fedurca/het68_pcb/docs/PINOUT.csv

function | gpio | dir | net | notes
mesh_uart_tx | GP0 | out | UART_TX | J_MESH pin 3; Heltec GPIO5 RX; 22 ohm; MeshCore companion 115200
mesh_uart_rx | GP1 | in | UART_RX | J_MESH pin 4; Heltec GPIO6 TX; 22 ohm
env_sda | GP2 | i2c | I2C1_SDA | DPS310 0x77; SHT40 0x44
env_scl | GP3 | i2c | I2C1_SCL | pressure + temperature + humidity
pm_sda | GP4 | i2c | I2C0_SDA | via J_PWR to power board INA/PAC
pm_scl | GP5 | i2c | I2C0_SCL
piezo_a | GP6 | out | PIEZO_IN1 | DRV8837 IN1; 4x PS1240 parallel
piezo_b | GP7 | out | PIEZO_IN2 | DRV8837 IN2
i2s_ws | GP8 | out | I2S_WS | shared; 33 ohm then LVDS047 to six RJ45
i2s_sck | GP9 | out | I2S_SCK | 3.072 MHz; 33 ohm then LVDS047
led4_din | GP10 | out | LED4_DIN | RJ45 MIC4 pin 8
led5_din | GP11 | out | LED5_DIN | RJ45 MIC5 pin 8
led6_din | GP12 | out | LED6_DIN | RJ45 MIC6 pin 8
mic4_sd | GP13 | in | I2S_SD4 | LVDS RX; firmware PIN_I2S_SD[3]
mic5_sd | GP14 | in | I2S_SD5 | firmware PIN_I2S_SD[4]
mic6_sd | GP15 | in | I2S_SD6 | firmware PIN_I2S_SD[5]
mic3_sd | GP16 | in | I2S_SD3 | firmware PIN_I2S_SD[2]
mic2_sd | GP17 | in | I2S_SD2 | firmware PIN_I2S_SD[1]
mic1_sd | GP18 | in | I2S_SD1 | firmware PIN_I2S_SD[0]
led3_din | GP19 | out | LED3_DIN | RJ45 MIC3 pin 8
led2_din | GP20 | out | LED2_DIN | RJ45 MIC2 pin 8
led1_din | GP21 | out | LED1_DIN | RJ45 MIC1 pin 8
dsp_awake | GP22 | out | DSP_AWAKE | J_MESH pin 6; Heltec GPIO4
adxl_sck | GP23 | out | SPI0_SCK | ADXL355 1.8 V
adxl_mosi | GP24 | out | SPI0_MOSI | ADXL355
adxl_miso | GP25 | in | SPI0_MISO | ADXL355
adc_i | GP26 | analog | ADC_I | J_PWR pin 9; CT burden
adc_rogo | GP27 | analog | ADC_ROGO | J_PWR pin 10; VVN integrator; NC on NN/VN
adc_pt1000 | GP28 | analog | ADC_PT1000 | J_PWR pin 12
adc_harvest | GP29 | analog | ADC_HARVEST | J_PWR pin 11
adxl_cs | GP30 | out | SPI0_CS | ADXL355
burden_en | GP31 | out | BURDEN_EN | J_PWR pin 13; NN/VN multiplex; NC on VVN
psram_ce | GP32 | out | PSRAM_CE | APS6404L
psram_so | GP33 | in | PSRAM_SO | APS6404L
psram_si | GP34 | out | PSRAM_SI | APS6404L
psram_sclk | GP35 | out | PSRAM_SCLK | APS6404L
pg_5v | GP36 | in | PG_5V | J_PWR pin 14
status_led | GP37 | out | STATUS_DIN | one SK6812 on Core; +3V3_DIG; DOUT NC
user_btn | GP38 | in | BTN_USER | active low; 10k to +3V3_DIG; SW_USR to GND
reset_btn |  |  | RUN | SW_RST to GND; 10k R_RUN already on RUN
boot_btn |  |  | QSPI_SS | SW_BOOT to GND; 10k R_CS; hold with reset for USB bootloader
wake_dsp |  | in | WAKE_DSP | not an MCU GPIO; Heltec GPIO7 -> EN of +3V3_DIG and +1V8_AUDIO LDOs
qspi_flash |  | bus | QSPI | dedicated RP2350B QSPI pins to W25Q128
usb_cdc |  |  | USB | console; replaces v3 debug UART on GP0/GP1
