fedurca/het68_pcb/docs/img/core-3d.png

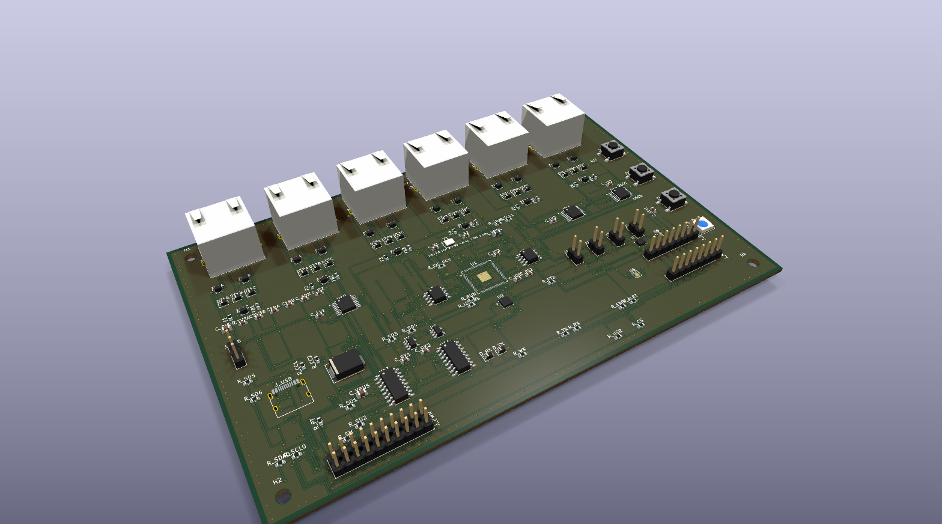
docs/img/core-3d.png
