fedurca/het68_pcb/docs/img/sat-3d.png

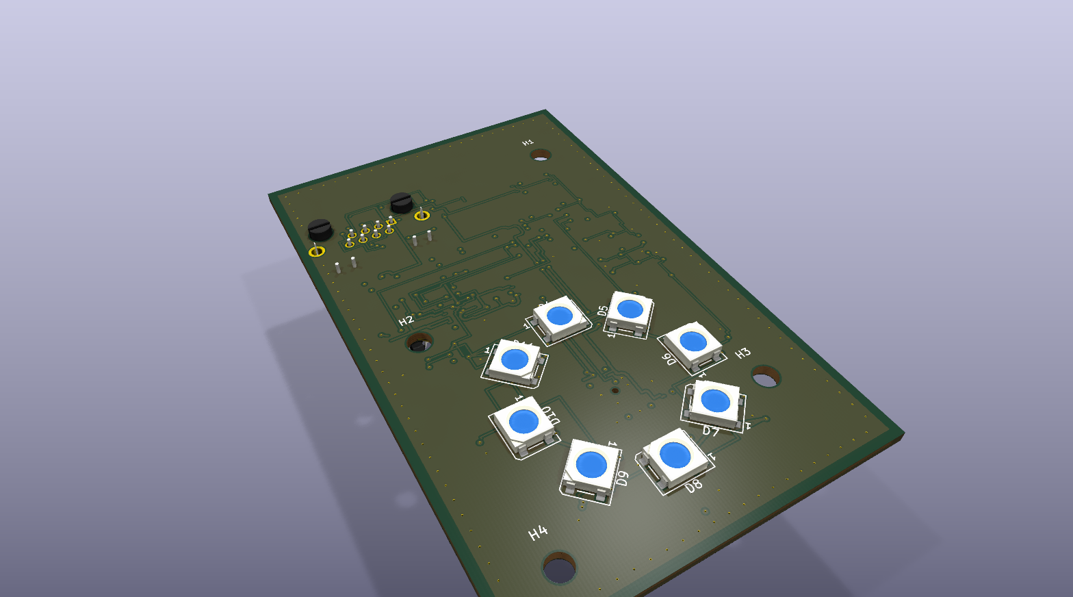
docs/img/sat-3d.png
