fedurca/het68_pcb/docs/img/sat-back-3d.png

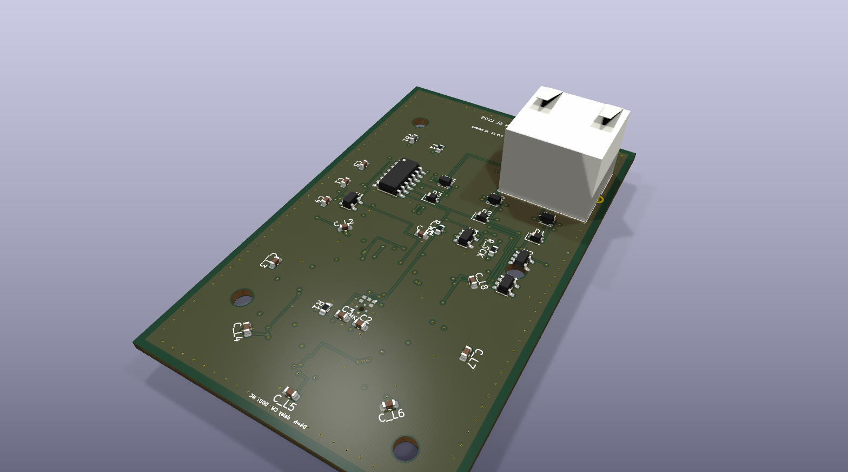
docs/img/sat-back-3d.png
