fedurca/het68_pcb/kicad/BOM_KIT.csv

Qty | Value | MPN | On
4 | 0 | RC0603FR-070RL | core+pwr-nn
1 | 0.1 | RC0805FR-070R1L | pwr-nn
6 | 0.25A | PPTC 0603 | core
6 | 0.5A | PPTC 0603 | sat x6
1 | 0.5A | polyfuse 1812 0.5 A | pwr-nn
1 | 10 | 10R 0.1pct burden | pwr-nn
18 | 100 | RC0603FR-07100RL | core+sat x6
1 | 100 | 100R THT burden | pwr-nn
11 | 100k | RC0603FR-07100KL | core+pwr-nn+sat x6
80 | 100n | CL10B104KB8NNNC | core+pwr-nn+sat x6
12 | 10k | RC0603FR-0710KL | core+pwr-nn
4 | 10u | CL21A106KOQNNNE | core+pwr-nn
1 | 10uH | 10uH boost | pwr-nn
1 | 12MHz | 12MHz 3225 | core
2 | 15p | CL10C150JB8NNNC | core
1 | 1k | RC0603FR-071KL | core
1 | 1k | RC0805FR-071KL | pwr-nn
16 | 1u | CL10A105KA8NNNC | core+pwr-nn+sat x6
1 | 1u/100V | 1uF 100V X7R LC | pwr-nn
1 | 2.2k | RC0603FR-072K2L | pwr-nn
1 | 2.2u | CL21A225KOQNNNE | core
1 | 2.2uH | 2.2uH VREG | core
1 | 20k | RC0603FR-0720KL | pwr-nn
1 | 21700 | Keystone 1122 | pwr-nn
2 | 22 | RC0603FR-0722RL | core
2 | 33 | RC0603FR-0733RL | core
6 | 4.7k | RC0603FR-074K7L | core+pwr-nn
1 | 470u/50V | electrolytic 470u 50V | pwr-nn
1 | 470uH | 470uH radial | pwr-nn
4 | 5.1k | RC0603FR-075K1L | core+pwr-nn
1 | 5KP36A | 5KP36A | pwr-nn
12 | 600R | BLM18PG601SN1D | core+sat x6
1 | ADXL355 | ADXL355BCCZ | core
2 | AO3400A | AO3400A | pwr-nn
1 | AO3401A | AO3401A | pwr-nn
7 | AP2112K-1.8 | AP2112K-1.8TRG1 | core+sat x6
2 | AP2112K-3.3 | AP2112K-3.3TRG1 | core+pwr-nn
1 | APS6404L | APS6404L-3SQR-SN | core
1 | BOOT | PTS645SM43SMTR92 | core
1 | BZX84-C24 | BZX84-C24 | pwr-nn
36 | CMC | ACM2012 | core+sat x6
1 | CN3791 | CN3791 | pwr-nn
1 | CT_SEC | sekundar CT, NE sit | pwr-nn
1 | DPS310 | DPS310 | core
1 | DRV8837C | DRV8837CDSGR | core
1 | FP6291 | FP6291 | pwr-nn
1 | GDT | GDT secondary | pwr-nn
1 | INA3221 | INA3221AIRGVR | pwr-nn
1 | J_CORE | interconnect 2x10 | pwr-nn
1 | J_MESH | PinHeader 1x8 Heltec V3 | core
1 | J_PWR | interconnect 2x10 | core
1 | J_STAMP_DNP | DNP stamp RAK class | core
1 | LED | LED 0603 | pwr-nn
1 | MIC1 | RJ45-8P8C-VERT | core
1 | MIC2 | RJ45-8P8C-VERT | core
1 | MIC3 | RJ45-8P8C-VERT | core
1 | MIC4 | RJ45-8P8C-VERT | core
1 | MIC5 | RJ45-8P8C-VERT | core
1 | MIC6 | RJ45-8P8C-VERT | core
38 | PESD5V0X1BT | PESD5V0X1BT | core+sat x6
1 | PT1000 | PT1000 on conductor | pwr-nn
1 | PZ1 | PS1240 | core
1 | PZ2 | PS1240 | core
1 | PZ3 | PS1240 | core
1 | PZ4 | PS1240 | core
1 | RESET | PTS645SM43SMTR92 | core
6 | RJ45 | RJ45-8P8C-VERT | sat x6
1 | RP2350B | RP2350B | core
1 | SHT40 | SHT40-AD1B-R2 | core
49 | SK6812 | SK6812 (5050, 3.3 V) | core+sat x6
3 | SN65LVDS047 | SN65LVDS047PW | core
6 | SN65LVDS1 | SN65LVDS1DBVR | sat x6
12 | SN65LVDS2 | SN65LVDS2DBVR | sat x6
2 | SN65LVDS32 | SN65LVDS32D | core
1 | SOLAR | panel Voc 6-18 V | pwr-nn
4 | SS14 | SS14 | pwr-nn
4 | SS34 | SS34 | core+pwr-nn
1 | SWD | SWD | core
6 | T5848 | MMICT5848-00-012 | sat x6
6 | TXS0104E | TXS0104EDR | sat x6
2 | USB_C | TYPE-C-31-M-12 | core+pwr-nn
1 | USER | PTS645SM43SMTR92 | core
1 | VOUT | 5V lab | pwr-nn
1 | W25Q128JVSIQ | W25Q128JVSIQ | core
1 | X0202MN | X0202MN | pwr-nn
