fedurca/het68_pcb/kicad/BOM_v4.csv

Board | Qty | Value | MPN | Refs
core | 1 | RP2350B | RP2350B | U1
core | 1 | W25Q128JVSIQ | W25Q128JVSIQ | U2
core | 1 | APS6404L | APS6404L-3SQR-SN | U3
core | 1 | 12MHz | 12MHz 3225 | Y1
core | 2 | 15p | CL10C150JB8NNNC | C_X1 C_X2
core | 1 | 2.2uH | 2.2uH VREG | L_VREG
core | 1 | 2.2u | CL21A225KOQNNNE | C_DVDD
core | 1 | AP2112K-3.3 | AP2112K-3.3TRG1 | U4
core | 1 | AP2112K-1.8 | AP2112K-1.8TRG1 | U5
core | 3 | 1u | CL10A105KA8NNNC | C3V3A C18A C_IO3
core | 12 | 100n | CL10B104KB8NNNC | C3V3B C18B C_STAT C_ADX C_PZ C_LV1 C_LV2 C_LV3 C_RX1 C_RX2 C_IO1 C_IO2
core | 5 | 10k | RC0603FR-0710KL | R_RUN R_CS R_USR R_ENRF R_ALRT
core | 1 | 100k | RC0603FR-07100KL | R_WK
core | 1 | RESET | PTS645SM43SMTR92 | SW_RST
core | 1 | BOOT | PTS645SM43SMTR92 | SW_BOOT
core | 1 | USER | PTS645SM43SMTR92 | SW_USR
core | 1 | SK6812 | SK6812 (5050, 3.3 V) | D_STAT
core | 1 | USB_C | TYPE-C-31-M-12 | J_USB
core | 2 | 5.1k | RC0603FR-075K1L | R_CC1 R_CC2
core | 1 | SS34 | SS34 | D_USB
core | 1 | 10u | CL21A106KOQNNNE | C_VBUS
core | 1 | J_MESH | PinHeader 1x8 Heltec V3 | J_MESH
core | 1 | J_STAMP_DNP | DNP stamp RAK class | J_STAMP
core | 2 | 22 | RC0603FR-0722RL | R_TX R_RX
core | 2 | 33 | RC0603FR-0733RL | R_I2S_SCK R_I2S_WS
core | 20 | PESD5V0X1BT | PESD5V0X1BT | D_TX D_RX DT1A DT1B DT1C DT2A DT2B DT2C DT3A DT3B DT3C DT4A DT4B DT4C DT5A DT5B DT5C DT6A DT6B DT6C
core | 1 | SWD | SWD | J_SWD
core | 1 | J_PWR | interconnect 2x10 | J_PWR
core | 4 | 4.7k | RC0603FR-074K7L | R_SDA0 R_SCL0 R_SDA1 R_SCL1
core | 1 | 1k | RC0603FR-071KL | R_PT
core | 2 | 0 | RC0603FR-070RL | R_PT2 R_SH
core | 1 | DPS310 | DPS310 | U7
core | 1 | SHT40 | SHT40-AD1B-R2 | U8
core | 1 | ADXL355 | ADXL355BCCZ | U9
core | 1 | DRV8837C | DRV8837CDSGR | U6
core | 1 | PZ1 | PS1240 | J11
core | 1 | PZ2 | PS1240 | J12
core | 1 | PZ3 | PS1240 | J13
core | 1 | PZ4 | PS1240 | J14
core | 3 | SN65LVDS047 | SN65LVDS047PW | U10 U11 U12
core | 2 | SN65LVDS32 | SN65LVDS32D | U13 U14
core | 1 | MIC1 | RJ45-8P8C-VERT | J1
core | 18 | CMC | ACM2012 | FL1A FL1B FL1C FL2A FL2B FL2C FL3A FL3B FL3C FL4A FL4B FL4C FL5A FL5B FL5C FL6A FL6B FL6C
core | 6 | 100 | RC0603FR-07100RL | R_SD1 R_SD2 R_SD3 R_SD4 R_SD5 R_SD6
core | 6 | 0.25A | PPTC 0603 | F1 F2 F3 F4 F5 F6
core | 6 | 600R | BLM18PG601SN1D | FB1 FB2 FB3 FB4 FB5 FB6
core | 1 | MIC2 | RJ45-8P8C-VERT | J2
core | 1 | MIC3 | RJ45-8P8C-VERT | J3
core | 1 | MIC4 | RJ45-8P8C-VERT | J4
core | 1 | MIC5 | RJ45-8P8C-VERT | J5
core | 1 | MIC6 | RJ45-8P8C-VERT | J6
sat | 6 | RJ45 | RJ45-8P8C-VERT | J1
sat | 18 | CMC | ACM2012 | FL1 FL2 FL3
sat | 18 | PESD5V0X1BT | PESD5V0X1BT | D1 D2 D3
sat | 6 | 0.5A | PPTC 0603 | F1
sat | 6 | 600R | BLM18PG601SN1D | FB1
sat | 12 | 100 | RC0603FR-07100RL | R_SCK R_WS
sat | 12 | SN65LVDS2 | SN65LVDS2DBVR | U2 U3
sat | 6 | SN65LVDS1 | SN65LVDS1DBVR | U4
sat | 6 | TXS0104E | TXS0104EDR | U5
sat | 6 | AP2112K-1.8 | AP2112K-1.8TRG1 | U1
sat | 6 | T5848 | MMICT5848-00-012 | MK1
sat | 48 | SK6812 | SK6812 (5050, 3.3 V) | D4 D5 D6 D7 D8 D9 D10 D11
sat | 66 | 100n | CL10B104KB8NNNC | C_L1 C_L2 C_L3 C_L4 C_L5 C_L6 C_L7 C_L8 C3 C4 C5
sat | 12 | 1u | CL10A105KA8NNNC | C1 C2
sat | 6 | 100k | RC0603FR-07100KL | R1
het68-pwr-nn | 1 | CT_SEC | sekundar CT, NE sit | J1
het68-pwr-nn | 1 | 100 | 100R THT burden | R4
het68-pwr-nn | 1 | GDT | GDT secondary | GDT1
het68-pwr-nn | 1 | 470uH | 470uH radial | L1
het68-pwr-nn | 1 | 1u/100V | 1uF 100V X7R LC | C4
het68-pwr-nn | 1 | 0.5A | polyfuse 1812 0.5 A | F1
het68-pwr-nn | 4 | SS14 | SS14 | D1 D2 D3 D4
het68-pwr-nn | 1 | 470u/50V | electrolytic 470u 50V | C1
het68-pwr-nn | 1 | X0202MN | X0202MN | Q1
het68-pwr-nn | 1 | BZX84-C24 | BZX84-C24 | D5
het68-pwr-nn | 1 | 1k | RC0805FR-071KL | R5
het68-pwr-nn | 1 | 5KP36A | 5KP36A | DTVS
het68-pwr-nn | 3 | SS34 | SS34 | D6 D7 D_HV
het68-pwr-nn | 1 | 10 | 10R 0.1pct burden | RPREC
het68-pwr-nn | 2 | AO3400A | AO3400A | Q2 Q4
het68-pwr-nn | 4 | 100k | RC0603FR-07100KL | R_BG R_PGATE R_ROGO_NC R_FB1
het68-pwr-nn | 1 | AO3401A | AO3401A | Q3
het68-pwr-nn | 7 | 10k | RC0603FR-0710KL | R_IS R_IG R_PG R_PG2 R_RFEN R_HS R_HG
het68-pwr-nn | 1 | USB_C | TYPE-C-31-M-12 | J2
het68-pwr-nn | 2 | 5.1k | RC0603FR-075K1L | R1 R2
het68-pwr-nn | 3 | 10u | CL21A106KOQNNNE | C3 C_MP C_5V
het68-pwr-nn | 1 | SOLAR | panel Voc 6-18 V | J_SOL
het68-pwr-nn | 1 | CN3791 | CN3791 | U_MPPT
het68-pwr-nn | 2 | 100n | CL10B104KB8NNNC | C_MC C_INA
het68-pwr-nn | 1 | 21700 | Keystone 1122 | BT1
het68-pwr-nn | 1 | FP6291 | FP6291 | U_BST
het68-pwr-nn | 1 | 10uH | 10uH boost | L_BST
het68-pwr-nn | 1 | 20k | RC0603FR-0720KL | R_FB2
het68-pwr-nn | 1 | AP2112K-3.3 | AP2112K-3.3TRG1 | U_RF
het68-pwr-nn | 1 | 1u | CL10A105KA8NNNC | C_RF
het68-pwr-nn | 1 | INA3221 | INA3221AIRGVR | U_INA
het68-pwr-nn | 1 | 0.1 | RC0805FR-070R1L | R_SH5
het68-pwr-nn | 1 | PT1000 | PT1000 on conductor | J_RTD
het68-pwr-nn | 2 | 0 | RC0603FR-070RL | R_RTN R_SH
het68-pwr-nn | 1 | J_CORE | interconnect 2x10 | J_CORE
het68-pwr-nn | 2 | 4.7k | RC0603FR-074K7L | R_SDA R_SCL
het68-pwr-nn | 1 | LED | LED 0603 | D8
het68-pwr-nn | 1 | 2.2k | RC0603FR-072K2L | R3
het68-pwr-nn | 1 | VOUT | 5V lab | J3
het68-pwr-vn | 1 | CT_SEC | sekundar CT, NE sit | J1
het68-pwr-vn | 1 | 100 | 100R THT burden | R4
het68-pwr-vn | 1 | GDT | GDT secondary | GDT1
het68-pwr-vn | 1 | GDT | GDT secondary extra | GDT2
het68-pwr-vn | 1 | 470uH | 470uH radial | L1
het68-pwr-vn | 1 | 1u/100V | 1uF 100V X7R LC | C4
het68-pwr-vn | 1 | 0.5A | polyfuse 1812 0.5 A | F1
het68-pwr-vn | 4 | SS14 | SS14 | D1 D2 D3 D4
het68-pwr-vn | 1 | 470u/50V | electrolytic 470u 50V | C1
het68-pwr-vn | 1 | X0202MN | X0202MN | Q1
het68-pwr-vn | 1 | BZX84-C24 | BZX84-C24 | D5
het68-pwr-vn | 1 | 1k | RC0805FR-071KL | R5
het68-pwr-vn | 1 | 15KP36A | 15KP36A | DTVS
het68-pwr-vn | 3 | SS34 | SS34 | D6 D7 D_HV
het68-pwr-vn | 1 | 10 | 10R 0.1pct burden | RPREC
het68-pwr-vn | 2 | AO3400A | AO3400A | Q2 Q4
het68-pwr-vn | 4 | 100k | RC0603FR-07100KL | R_BG R_PGATE R_ROGO_NC R_FB1
het68-pwr-vn | 1 | AO3401A | AO3401A | Q3
het68-pwr-vn | 7 | 10k | RC0603FR-0710KL | R_IS R_IG R_PG R_PG2 R_RFEN R_HS R_HG
het68-pwr-vn | 1 | USB_C | TYPE-C-31-M-12 | J2
het68-pwr-vn | 2 | 5.1k | RC0603FR-075K1L | R1 R2
het68-pwr-vn | 3 | 10u | CL21A106KOQNNNE | C3 C_MP C_5V
het68-pwr-vn | 1 | SOLAR | panel Voc 6-18 V | J_SOL
het68-pwr-vn | 1 | CN3791 | CN3791 | U_MPPT
het68-pwr-vn | 2 | 100n | CL10B104KB8NNNC | C_MC C_INA
het68-pwr-vn | 1 | 21700 | Keystone 1122 | BT1
het68-pwr-vn | 1 | FP6291 | FP6291 | U_BST
het68-pwr-vn | 1 | 10uH | 10uH boost | L_BST
het68-pwr-vn | 1 | 20k | RC0603FR-0720KL | R_FB2
het68-pwr-vn | 1 | AP2112K-3.3 | AP2112K-3.3TRG1 | U_RF
het68-pwr-vn | 1 | 1u | CL10A105KA8NNNC | C_RF
het68-pwr-vn | 1 | INA3221 | INA3221AIRGVR | U_INA
het68-pwr-vn | 1 | 0.1 | RC0805FR-070R1L | R_SH5
het68-pwr-vn | 1 | PT1000 | PT1000 on conductor | J_RTD
het68-pwr-vn | 2 | 0 | RC0603FR-070RL | R_RTN R_SH
het68-pwr-vn | 1 | J_CORE | interconnect 2x10 | J_CORE
het68-pwr-vn | 2 | 4.7k | RC0603FR-074K7L | R_SDA R_SCL
het68-pwr-vn | 1 | LED | LED 0603 | D8
het68-pwr-vn | 1 | 2.2k | RC0603FR-072K2L | R3
het68-pwr-vn | 1 | VOUT | 5V lab | J3
het68-pwr-vvn | 1 | CT_SEC | sekundar CT, NE sit | J1
het68-pwr-vvn | 1 | 100 | 100R THT burden | R4
het68-pwr-vvn | 1 | GDT | GDT secondary | GDT1
het68-pwr-vvn | 1 | 470uH | 470uH radial | L1
het68-pwr-vvn | 1 | 1u/100V | 1uF 100V X7R LC | C4
het68-pwr-vvn | 1 | 0.5A | polyfuse 1812 0.5 A | F1
het68-pwr-vvn | 4 | SS14 | SS14 | D1 D2 D3 D4
het68-pwr-vvn | 1 | 470u/50V | electrolytic 470u 50V | C1
het68-pwr-vvn | 1 | X0202MN | X0202MN | Q1
het68-pwr-vvn | 1 | BZX84-C24 | BZX84-C24 | D5
het68-pwr-vvn | 1 | 1k | RC0805FR-071KL | R5
het68-pwr-vvn | 1 | 15KP36A | 15KP36A | DTVS
het68-pwr-vvn | 3 | SS34 | SS34 | D6 D7 D_HV
het68-pwr-vvn | 1 | ROGOWSKI | Rogowski secondary, NE sit | J_ROGO
het68-pwr-vvn | 3 | 0 | RC0603FR-070RL | R_RN R_RTN R_SH
het68-pwr-vvn | 8 | 10k | RC0603FR-0710KL | R_INT R_IS R_IG R_PG R_PG2 R_RFEN R_HS R_HG
het68-pwr-vvn | 4 | 100n | CL10B104KB8NNNC | C_INT C_OA C_MC C_INA
het68-pwr-vvn | 1 | MCP6001 | MCP6001T-OT | U_INT
het68-pwr-vvn | 2 | 100k | RC0603FR-07100KL | R_BEN_NC R_FB1
het68-pwr-vvn | 1 | USB_C | TYPE-C-31-M-12 | J2
het68-pwr-vvn | 2 | 5.1k | RC0603FR-075K1L | R1 R2
het68-pwr-vvn | 3 | 10u | CL21A106KOQNNNE | C3 C_MP C_5V
het68-pwr-vvn | 1 | SOLAR | panel Voc 6-18 V | J_SOL
het68-pwr-vvn | 1 | CN3791 | CN3791 | U_MPPT
het68-pwr-vvn | 1 | 21700 | Keystone 1122 | BT1
het68-pwr-vvn | 1 | FP6291 | FP6291 | U_BST
het68-pwr-vvn | 1 | 10uH | 10uH boost | L_BST
het68-pwr-vvn | 1 | 20k | RC0603FR-0720KL | R_FB2
het68-pwr-vvn | 1 | AP2112K-3.3 | AP2112K-3.3TRG1 | U_RF
het68-pwr-vvn | 1 | 1u | CL10A105KA8NNNC | C_RF
het68-pwr-vvn | 1 | INA3221 | INA3221AIRGVR | U_INA
het68-pwr-vvn | 1 | 0.1 | RC0805FR-070R1L | R_SH5
het68-pwr-vvn | 1 | PT1000 | PT1000 on conductor | J_RTD
het68-pwr-vvn | 1 | J_CORE | interconnect 2x10 | J_CORE
het68-pwr-vvn | 2 | 4.7k | RC0603FR-074K7L | R_SDA R_SCL
het68-pwr-vvn | 1 | LED | LED 0603 | D8
het68-pwr-vvn | 1 | 2.2k | RC0603FR-072K2L | R3
het68-pwr-vvn | 1 | VOUT | 5V lab | J3
