fedurca/het68_pcb/kicad/het68-sat/bom.csv

Ref | Value | Footprint | MPN | LCSC
J1 | RJ45 | het68:RJ45_Vertical_het68 | RJ45-8P8C-VERT
FL1 | CMC | Inductor_SMD:L_CommonModeChoke_Coilank_ACM2012 | ACM2012
FL2 | CMC | Inductor_SMD:L_CommonModeChoke_Coilank_ACM2012 | ACM2012
D1 | PESD5V0X1BT | Diode_SMD:D_SOD-323 | PESD5V0X1BT
D2 | PESD5V0X1BT | Diode_SMD:D_SOD-323 | PESD5V0X1BT
D3 | PESD5V0X1BT | Diode_SMD:D_SOD-323 | PESD5V0X1BT
F1 | 0.5A | Fuse:Fuse_0603_1608Metric | PPTC 0603
FB1 | 600R | Inductor_SMD:L_0603_1608Metric | BLM18PG601SN1D
R_SCK | 100 | Resistor_SMD:R_0603_1608Metric | RC0603FR-07100RL
R_WS | 100 | Resistor_SMD:R_0603_1608Metric | RC0603FR-07100RL
JP_TSCK | T | Connector_PinHeader_2.54mm:PinHeader_1x02_P2.54mm_Vertical | jumper DIFF term SCK
JP_TWS | T | Connector_PinHeader_2.54mm:PinHeader_1x02_P2.54mm_Vertical | jumper DIFF term WS
U2 | SN65LVDS2 | Package_TO_SOT_SMD:SOT-23-5 | SN65LVDS2DBVR
U3 | SN65LVDS2 | Package_TO_SOT_SMD:SOT-23-5 | SN65LVDS2DBVR
U4 | SN65LVDS1 | Package_TO_SOT_SMD:SOT-23-5 | SN65LVDS1DBVR
JP_SCK | MODE | Connector_PinHeader_2.54mm:PinHeader_2x03_P2.54mm_Vertical | SCK radky DIFF / 3V3 / 1V8
JP_WS | MODE | Connector_PinHeader_2.54mm:PinHeader_2x03_P2.54mm_Vertical | WS radky DIFF / 3V3 / 1V8
JP_SD | MODE | Connector_PinHeader_2.54mm:PinHeader_2x03_P2.54mm_Vertical | SD radky DIFF / 3V3 / 1V8
JP_SDN | SDN | Connector_PinHeader_2.54mm:PinHeader_1x03_P2.54mm_Vertical | jumper SDN 1-2 DIFF 2-3 single-ended
R_OE | 10k | Resistor_SMD:R_0603_1608Metric | RC0603FR-0710KL
JP_OE | OE | Connector_PinHeader_2.54mm:PinHeader_1x02_P2.54mm_Vertical | jumper OE to GND = 1V8 mode
R_SD3 | 100k | Resistor_SMD:R_0603_1608Metric | RC0603FR-07100KL
U5 | TXS0104E | Package_SO:SOIC-14_3.9x8.7mm_P1.27mm | TXS0104EDR
U1 | AP2112K-1.8 | Package_TO_SOT_SMD:SOT-23-5 | AP2112K-1.8TRG1 | C176944
MK1 | T5848 | het68:T5848 | MMICT5848-00-012 | C20344623
D4 | SK6812 | LED_SMD:LED_WS2812B_PLCC4_5.0x5.0mm_P3.2mm | SK6812 (5050, 3.3 V)
C_L1 | 100n | Capacitor_SMD:C_0603_1608Metric | CL10B104KB8NNNC
D5 | SK6812 | LED_SMD:LED_WS2812B_PLCC4_5.0x5.0mm_P3.2mm | SK6812 (5050, 3.3 V)
C_L2 | 100n | Capacitor_SMD:C_0603_1608Metric | CL10B104KB8NNNC
D6 | SK6812 | LED_SMD:LED_WS2812B_PLCC4_5.0x5.0mm_P3.2mm | SK6812 (5050, 3.3 V)
C_L3 | 100n | Capacitor_SMD:C_0603_1608Metric | CL10B104KB8NNNC
D7 | SK6812 | LED_SMD:LED_WS2812B_PLCC4_5.0x5.0mm_P3.2mm | SK6812 (5050, 3.3 V)
C_L4 | 100n | Capacitor_SMD:C_0603_1608Metric | CL10B104KB8NNNC
D8 | SK6812 | LED_SMD:LED_WS2812B_PLCC4_5.0x5.0mm_P3.2mm | SK6812 (5050, 3.3 V)
C_L5 | 100n | Capacitor_SMD:C_0603_1608Metric | CL10B104KB8NNNC
D9 | SK6812 | LED_SMD:LED_WS2812B_PLCC4_5.0x5.0mm_P3.2mm | SK6812 (5050, 3.3 V)
C_L6 | 100n | Capacitor_SMD:C_0603_1608Metric | CL10B104KB8NNNC
D10 | SK6812 | LED_SMD:LED_WS2812B_PLCC4_5.0x5.0mm_P3.2mm | SK6812 (5050, 3.3 V)
C_L7 | 100n | Capacitor_SMD:C_0603_1608Metric | CL10B104KB8NNNC
D11 | SK6812 | LED_SMD:LED_WS2812B_PLCC4_5.0x5.0mm_P3.2mm | SK6812 (5050, 3.3 V)
C_L8 | 100n | Capacitor_SMD:C_0603_1608Metric | CL10B104KB8NNNC
C1 | 1u | Capacitor_SMD:C_0603_1608Metric | CL10A105KA8NNNC
C2 | 1u | Capacitor_SMD:C_0603_1608Metric | CL10A105KA8NNNC
C3 | 100n | Capacitor_SMD:C_0603_1608Metric | CL10B104KB8NNNC
C4 | 100n | Capacitor_SMD:C_0603_1608Metric | CL10B104KB8NNNC
C5 | 100n | Capacitor_SMD:C_0603_1608Metric | CL10B104KB8NNNC
R1 | 100k | Resistor_SMD:R_0603_1608Metric | RC0603FR-07100KL
FL3 | CMC | Inductor_SMD:L_CommonModeChoke_Coilank_ACM2012 | ACM2012
