fedurca/het68_pcb/kicad/jlc/het68-core-bom.csv

Comment | Designator | Footprint | MPN | LCSC
RP2350B | U1 | Package_DFN_QFN:QFN-80-1EP_10x10mm_P0.4mm_EP3.4x3.4mm_ThermalVias | RP2350B
W25Q128JVSIQ | U2 | Package_SO:SOIC-8_3.9x4.9mm_P1.27mm | W25Q128JVSIQ
APS6404L | U3 | Package_SO:SOIC-8_3.9x4.9mm_P1.27mm | APS6404L-3SQR-SN
12MHz | Y1 | Crystal:Crystal_SMD_3225-4Pin_3.2x2.5mm | 12MHz 3225
15p | C_X1,C_X2 | Capacitor_SMD:C_0603_1608Metric | CL10C150JB8NNNC
2.2uH | L_VREG | Inductor_SMD:L_0805_2012Metric | 2.2uH VREG
2.2u | C_DVDD | Capacitor_SMD:C_0805_2012Metric | CL21A225KOQNNNE
AP2112K-3.3 | U4 | Package_TO_SOT_SMD:SOT-23-5 | AP2112K-3.3TRG1
AP2112K-1.8 | U5 | Package_TO_SOT_SMD:SOT-23-5 | AP2112K-1.8TRG1 | C176944
1u | C3V3A,C18A,C_IO3 | Capacitor_SMD:C_0603_1608Metric | CL10A105KA8NNNC
100n | C3V3B,C18B,C_STAT,C_ADX,C_PZ,C_LV1,C_LV2,C_LV3,C_RX1,C_RX2,C_IO1,C_IO2 | Capacitor_SMD:C_0603_1608Metric | CL10B104KB8NNNC
10k | R_RUN,R_CS,R_USR,R_ENRF,R_ALRT | Resistor_SMD:R_0603_1608Metric | RC0603FR-0710KL
100k | R_WK | Resistor_SMD:R_0603_1608Metric | RC0603FR-07100KL
RESET | SW_RST | Button_Switch_SMD:SW_SPST_PTS645Sx43SMTR92 | PTS645SM43SMTR92
BOOT | SW_BOOT | Button_Switch_SMD:SW_SPST_PTS645Sx43SMTR92 | PTS645SM43SMTR92
USER | SW_USR | Button_Switch_SMD:SW_SPST_PTS645Sx43SMTR92 | PTS645SM43SMTR92
SK6812 | D_STAT | LED_SMD:LED_WS2812B_PLCC4_5.0x5.0mm_P3.2mm | SK6812 (5050, 3.3 V)
USB_C | J_USB | Connector_USB:USB_C_Receptacle_HRO_TYPE-C-31-M-12 | TYPE-C-31-M-12 | C165948
5.1k | R_CC1,R_CC2 | Resistor_SMD:R_0603_1608Metric | RC0603FR-075K1L
SS34 | D_USB | Diode_SMD:D_SMC | SS34
10u | C_VBUS | Capacitor_SMD:C_0805_2012Metric | CL21A106KOQNNNE
J_MESH | J_MESH | Connector_PinHeader_2.54mm:PinHeader_1x08_P2.54mm_Vertical | PinHeader 1x8 Heltec V3
J_STAMP_DNP | J_STAMP | Connector_PinHeader_2.54mm:PinHeader_1x08_P2.54mm_Vertical | DNP stamp RAK class
22 | R_TX,R_RX | Resistor_SMD:R_0603_1608Metric | RC0603FR-0722RL
33 | R_I2S_SCK,R_I2S_WS | Resistor_SMD:R_0603_1608Metric | RC0603FR-0733RL
PESD5V0X1BT | D_TX,D_RX,DT1A,DT1B,DT1C,DT2A,DT2B,DT2C,DT3A,DT3B,DT3C,DT4A,DT4B,DT4C,DT5A,DT5B,DT5C,DT6A,DT6B,DT6C | Diode_SMD:D_SOD-323 | PESD5V0X1BT
SWD | J_SWD | Connector_PinHeader_2.54mm:PinHeader_1x03_P2.54mm_Vertical | SWD
J_PWR | J_PWR | Connector_PinHeader_2.54mm:PinHeader_2x10_P2.54mm_Vertical | interconnect 2x10
4.7k | R_SDA0,R_SCL0,R_SDA1,R_SCL1 | Resistor_SMD:R_0603_1608Metric | RC0603FR-074K7L
1k | R_PT | Resistor_SMD:R_0603_1608Metric | RC0603FR-071KL
0 | R_PT2,R_SH | Resistor_SMD:R_0603_1608Metric | RC0603FR-070RL
DPS310 | U7 | Package_LGA:Bosch_LGA-8_2x2.5mm_P0.65mm_ClockwisePinNumbering | DPS310 | C130156
SHT40 | U8 | Sensor_Humidity:Sensirion_DFN-4_1.5x1.5mm_P0.8mm_SHT4x_NoCentralPad | SHT40-AD1B-R2 | C2909890
ADXL355 | U9 | Package_DFN_QFN:QFN-16-1EP_3x3mm_P0.5mm_EP1.7x1.7mm | ADXL355BCCZ
DRV8837C | U6 | Package_SON:Texas_DSG0008A_WSON-8-1EP_2x2mm_P0.5mm_EP0.9x1.6mm | DRV8837CDSGR | C191000
PZ1 | J11 | Connector_PinHeader_2.54mm:PinHeader_1x02_P2.54mm_Vertical | PS1240
PZ2 | J12 | Connector_PinHeader_2.54mm:PinHeader_1x02_P2.54mm_Vertical | PS1240
PZ3 | J13 | Connector_PinHeader_2.54mm:PinHeader_1x02_P2.54mm_Vertical | PS1240
PZ4 | J14 | Connector_PinHeader_2.54mm:PinHeader_1x02_P2.54mm_Vertical | PS1240
SN65LVDS047 | U10,U11,U12 | Package_SO:TSSOP-16_4.4x5mm_P0.65mm | SN65LVDS047PW
SN65LVDS32 | U13,U14 | Package_SO:SOIC-16_3.9x9.9mm_P1.27mm | SN65LVDS32D
MIC1 | J1 | het68:RJ45_Vertical_het68 | RJ45-8P8C-VERT
CMC | FL1A,FL1B,FL1C,FL2A,FL2B,FL2C,FL3A,FL3B,FL3C,FL4A,FL4B,FL4C,FL5A,FL5B,FL5C,FL6A,FL6B,FL6C | Inductor_SMD:L_CommonModeChoke_Coilank_ACM2012 | ACM2012
100 | R_SD1,R_SD2,R_SD3,R_SD4,R_SD5,R_SD6 | Resistor_SMD:R_0603_1608Metric | RC0603FR-07100RL
0.25A | F1,F2,F3,F4,F5,F6 | Fuse:Fuse_0603_1608Metric | PPTC 0603
600R | FB1,FB2,FB3,FB4,FB5,FB6 | Inductor_SMD:L_0603_1608Metric | BLM18PG601SN1D
MIC2 | J2 | het68:RJ45_Vertical_het68 | RJ45-8P8C-VERT
MIC3 | J3 | het68:RJ45_Vertical_het68 | RJ45-8P8C-VERT
MIC4 | J4 | het68:RJ45_Vertical_het68 | RJ45-8P8C-VERT
MIC5 | J5 | het68:RJ45_Vertical_het68 | RJ45-8P8C-VERT
MIC6 | J6 | het68:RJ45_Vertical_het68 | RJ45-8P8C-VERT
