fedurca/het68_pcb/kicad/jlc/het68-sat-bom.csv

Comment | Designator | Footprint | MPN | LCSC
RJ45 | J1 | het68:RJ45_Vertical_het68 | RJ45-8P8C-VERT
CMC | FL1,FL2,FL3 | Inductor_SMD:L_CommonModeChoke_Coilank_ACM2012 | ACM2012
PESD5V0X1BT | D1,D2,D3 | Diode_SMD:D_SOD-323 | PESD5V0X1BT
0.5A | F1 | Fuse:Fuse_0603_1608Metric | PPTC 0603
600R | FB1 | Inductor_SMD:L_0603_1608Metric | BLM18PG601SN1D
100 | R_SCK,R_WS | Resistor_SMD:R_0603_1608Metric | RC0603FR-07100RL
10k | R_OE | Resistor_SMD:R_0603_1608Metric | RC0603FR-0710KL
MODE | JP_SCK,JP_WS,JP_SD | Connector_PinHeader_2.54mm:PinHeader_2x03_P2.54mm_Vertical | PinHeader 2x03 2.54mm
T | JP_TSCK,JP_TWS | Connector_PinHeader_2.54mm:PinHeader_1x02_P2.54mm_Vertical | PinHeader 1x02 2.54mm
SDN | JP_SDN | Connector_PinHeader_2.54mm:PinHeader_1x03_P2.54mm_Vertical | PinHeader 1x03 2.54mm
OE | JP_OE | Connector_PinHeader_2.54mm:PinHeader_1x02_P2.54mm_Vertical | PinHeader 1x02 2.54mm
SN65LVDS2 | U2,U3 | Package_TO_SOT_SMD:SOT-23-5 | SN65LVDS2DBVR
SN65LVDS1 | U4 | Package_TO_SOT_SMD:SOT-23-5 | SN65LVDS1DBVR
TXS0104E | U5 | Package_SO:SOIC-14_3.9x8.7mm_P1.27mm | TXS0104EDR
AP2112K-1.8 | U1 | Package_TO_SOT_SMD:SOT-23-5 | AP2112K-1.8TRG1 | C176944
T5848 | MK1 | het68:T5848 | MMICT5848-00-012 | C20344623
SK6812 | D4,D5,D6,D7,D8,D9,D10,D11 | LED_SMD:LED_WS2812B_PLCC4_5.0x5.0mm_P3.2mm | SK6812 (5050, 3.3 V)
100n | C_L1,C_L2,C_L3,C_L4,C_L5,C_L6,C_L7,C_L8,C3,C4,C5 | Capacitor_SMD:C_0603_1608Metric | CL10B104KB8NNNC
1u | C1,C2 | Capacitor_SMD:C_0603_1608Metric | CL10A105KA8NNNC
100k | R1,R_SD3 | Resistor_SMD:R_0603_1608Metric | RC0603FR-07100KL
