fedurca/het68_pcb/kicad/het68-pwr-nn/bom.csv

Ref | Value | Footprint | MPN | LCSC
J1 | CT_SEC | Connector_PinHeader_2.54mm:PinHeader_1x02_P2.54mm_Vertical | sekundar CT, NE sit
R4 | 100 | Resistor_THT:R_Axial_DIN0207_L6.3mm_D2.5mm_P10.16mm_Horizontal | 100R THT burden
GDT1 | GDT | Fuse:Fuse_1812_4532Metric | GDT secondary
L1 | 470uH | Inductor_THT:L_Radial_D10.0mm_P5.00mm_Fastron_07P | 470uH radial
C4 | 1u/100V | Capacitor_SMD:C_1206_3216Metric | 1uF 100V X7R LC
F1 | 0.5A | Fuse:Fuse_1812_4532Metric | polyfuse 1812 0.5 A
D1 | SS14 | Diode_SMD:D_SMA | SS14
D2 | SS14 | Diode_SMD:D_SMA | SS14
D3 | SS14 | Diode_SMD:D_SMA | SS14
D4 | SS14 | Diode_SMD:D_SMA | SS14
C1 | 470u/50V | Capacitor_THT:CP_Radial_D10.0mm_P5.00mm | electrolytic 470u 50V
Q1 | X0202MN | Package_TO_SOT_SMD:SOT-223 | X0202MN
D5 | BZX84-C24 | Diode_SMD:D_SOD-323 | BZX84-C24
R5 | 1k | Resistor_SMD:R_0805_2012Metric | RC0805FR-071KL
DTVS | 5KP36A | Diode_THT:D_DO-201_P15.24mm_Horizontal | 5KP36A
D6 | SS34 | Diode_SMD:D_SMC | SS34
RPREC | 10 | Resistor_SMD:R_1206_3216Metric | 10R 0.1pct burden
Q2 | AO3400A | Package_TO_SOT_SMD:SOT-23 | AO3400A
R_BG | 100k | Resistor_SMD:R_0603_1608Metric | RC0603FR-07100KL
Q3 | AO3401A | Package_TO_SOT_SMD:SOT-23 | AO3401A
R_PGATE | 100k | Resistor_SMD:R_0603_1608Metric | RC0603FR-07100KL
Q4 | AO3400A | Package_TO_SOT_SMD:SOT-23 | AO3400A
R_IS | 10k | Resistor_SMD:R_0603_1608Metric | RC0603FR-0710KL
R_IG | 10k | Resistor_SMD:R_0603_1608Metric | RC0603FR-0710KL
R_ROGO_NC | 100k | Resistor_SMD:R_0603_1608Metric | RC0603FR-07100KL
J2 | USB_C | Connector_USB:USB_C_Receptacle_HRO_TYPE-C-31-M-12 | TYPE-C-31-M-12 | C165948
R1 | 5.1k | Resistor_SMD:R_0603_1608Metric | RC0603FR-075K1L
R2 | 5.1k | Resistor_SMD:R_0603_1608Metric | RC0603FR-075K1L
D7 | SS34 | Diode_SMD:D_SMC | SS34
C3 | 10u | Capacitor_SMD:C_0805_2012Metric | CL21A106KOQNNNE
J_SOL | SOLAR | Connector_PinHeader_2.54mm:PinHeader_1x02_P2.54mm_Vertical | panel Voc 6-18 V
U_MPPT | CN3791 | Package_SO:SOIC-8_3.9x4.9mm_P1.27mm | CN3791
C_MP | 10u | Capacitor_SMD:C_0805_2012Metric | CL21A106KOQNNNE
C_MC | 100n | Capacitor_SMD:C_0603_1608Metric | CL10B104KB8NNNC
D_HV | SS34 | Diode_SMD:D_SMC | SS34
BT1 | 21700 | het68:Keystone_1122_21700 | Keystone 1122
U_BST | FP6291 | Package_TO_SOT_SMD:SOT-23-6 | FP6291
L_BST | 10uH | Inductor_SMD:L_0805_2012Metric | 10uH boost
R_FB1 | 100k | Resistor_SMD:R_0603_1608Metric | RC0603FR-07100KL
R_FB2 | 20k | Resistor_SMD:R_0603_1608Metric | RC0603FR-0720KL
C_5V | 10u | Capacitor_SMD:C_0805_2012Metric | CL21A106KOQNNNE
R_PG | 10k | Resistor_SMD:R_0603_1608Metric | RC0603FR-0710KL
R_PG2 | 10k | Resistor_SMD:R_0603_1608Metric | RC0603FR-0710KL
U_RF | AP2112K-3.3 | Package_TO_SOT_SMD:SOT-23-5 | AP2112K-3.3TRG1
R_RFEN | 10k | Resistor_SMD:R_0603_1608Metric | RC0603FR-0710KL
C_RF | 1u | Capacitor_SMD:C_0603_1608Metric | CL10A105KA8NNNC
U_INA | INA3221 | Package_DFN_QFN:Texas_RGV0016A_VQFN-16-1EP_4x4mm_P0.65mm_EP2.1x2.1mm | INA3221AIRGVR | C181255
R_SH5 | 0.1 | Resistor_SMD:R_0805_2012Metric | RC0805FR-070R1L
C_INA | 100n | Capacitor_SMD:C_0603_1608Metric | CL10B104KB8NNNC
R_HS | 10k | Resistor_SMD:R_0603_1608Metric | RC0603FR-0710KL
R_HG | 10k | Resistor_SMD:R_0603_1608Metric | RC0603FR-0710KL
J_RTD | PT1000 | Connector_PinHeader_2.54mm:PinHeader_1x02_P2.54mm_Vertical | PT1000 on conductor
R_RTN | 0 | Resistor_SMD:R_0603_1608Metric | RC0603FR-070RL
J_CORE | J_CORE | Connector_PinHeader_2.54mm:PinHeader_2x10_P2.54mm_Vertical | interconnect 2x10
R_SH | 0 | Resistor_SMD:R_0603_1608Metric | RC0603FR-070RL
R_SDA | 4.7k | Resistor_SMD:R_0603_1608Metric | RC0603FR-074K7L
R_SCL | 4.7k | Resistor_SMD:R_0603_1608Metric | RC0603FR-074K7L
D8 | LED | LED_SMD:LED_0603_1608Metric | LED 0603
R3 | 2.2k | Resistor_SMD:R_0603_1608Metric | RC0603FR-072K2L
J3 | VOUT | Connector_PinHeader_2.54mm:PinHeader_1x02_P2.54mm_Vertical | 5V lab
