fedurca/het68_pcb/kicad/jlc/het68-pwr-nn-bom.csv

Comment | Designator | Footprint | MPN | LCSC
CT_SEC | J1 | Connector_PinHeader_2.54mm:PinHeader_1x02_P2.54mm_Vertical | sekundar CT, NE sit
100 | R4 | Resistor_THT:R_Axial_DIN0207_L6.3mm_D2.5mm_P10.16mm_Horizontal | 100R THT burden
GDT | GDT1 | Fuse:Fuse_1812_4532Metric | GDT secondary
470uH | L1 | Inductor_THT:L_Radial_D10.0mm_P5.00mm_Fastron_07P | 470uH radial
1u/100V | C4 | Capacitor_SMD:C_1206_3216Metric | 1uF 100V X7R LC
0.5A | F1 | Fuse:Fuse_1812_4532Metric | polyfuse 1812 0.5 A
SS14 | D1,D2,D3,D4 | Diode_SMD:D_SMA | SS14
470u/50V | C1 | Capacitor_THT:CP_Radial_D10.0mm_P5.00mm | electrolytic 470u 50V
X0202MN | Q1 | Package_TO_SOT_SMD:SOT-223 | X0202MN
BZX84-C24 | D5 | Diode_SMD:D_SOD-323 | BZX84-C24
1k | R5 | Resistor_SMD:R_0805_2012Metric | RC0805FR-071KL
5KP36A | DTVS | Diode_THT:D_DO-201_P15.24mm_Horizontal | 5KP36A
SS34 | D6,D7,D_HV | Diode_SMD:D_SMC | SS34
10 | RPREC | Resistor_SMD:R_1206_3216Metric | 10R 0.1pct burden
AO3400A | Q2,Q4 | Package_TO_SOT_SMD:SOT-23 | AO3400A
100k | R_BG,R_PGATE,R_ROGO_NC,R_FB1 | Resistor_SMD:R_0603_1608Metric | RC0603FR-07100KL
AO3401A | Q3 | Package_TO_SOT_SMD:SOT-23 | AO3401A
10k | R_IS,R_IG,R_PG,R_PG2,R_RFEN,R_HS,R_HG | Resistor_SMD:R_0603_1608Metric | RC0603FR-0710KL
USB_C | J2 | Connector_USB:USB_C_Receptacle_HRO_TYPE-C-31-M-12 | TYPE-C-31-M-12 | C165948
5.1k | R1,R2 | Resistor_SMD:R_0603_1608Metric | RC0603FR-075K1L
10u | C3,C_MP,C_5V | Capacitor_SMD:C_0805_2012Metric | CL21A106KOQNNNE
SOLAR | J_SOL | Connector_PinHeader_2.54mm:PinHeader_1x02_P2.54mm_Vertical | panel Voc 6-18 V
CN3791 | U_MPPT | Package_SO:SOIC-8_3.9x4.9mm_P1.27mm | CN3791
100n | C_MC,C_INA | Capacitor_SMD:C_0603_1608Metric | CL10B104KB8NNNC
21700 | BT1 | het68:Keystone_1122_21700 | Keystone 1122
FP6291 | U_BST | Package_TO_SOT_SMD:SOT-23-6 | FP6291
10uH | L_BST | Inductor_SMD:L_0805_2012Metric | 10uH boost
20k | R_FB2 | Resistor_SMD:R_0603_1608Metric | RC0603FR-0720KL
AP2112K-3.3 | U_RF | Package_TO_SOT_SMD:SOT-23-5 | AP2112K-3.3TRG1
1u | C_RF | Capacitor_SMD:C_0603_1608Metric | CL10A105KA8NNNC
INA3221 | U_INA | Package_DFN_QFN:Texas_RGV0016A_VQFN-16-1EP_4x4mm_P0.65mm_EP2.1x2.1mm | INA3221AIRGVR | C181255
0.1 | R_SH5 | Resistor_SMD:R_0805_2012Metric | RC0805FR-070R1L
PT1000 | J_RTD | Connector_PinHeader_2.54mm:PinHeader_1x02_P2.54mm_Vertical | PT1000 on conductor
0 | R_RTN,R_SH | Resistor_SMD:R_0603_1608Metric | RC0603FR-070RL
J_CORE | J_CORE | Connector_PinHeader_2.54mm:PinHeader_2x10_P2.54mm_Vertical | interconnect 2x10
4.7k | R_SDA,R_SCL | Resistor_SMD:R_0603_1608Metric | RC0603FR-074K7L
LED | D8 | LED_SMD:LED_0603_1608Metric | LED 0603
2.2k | R3 | Resistor_SMD:R_0603_1608Metric | RC0603FR-072K2L
VOUT | J3 | Connector_PinHeader_2.54mm:PinHeader_1x02_P2.54mm_Vertical | 5V lab
