fedurca/het68_pcb/kicad/het68-core/fab/het68-core.step

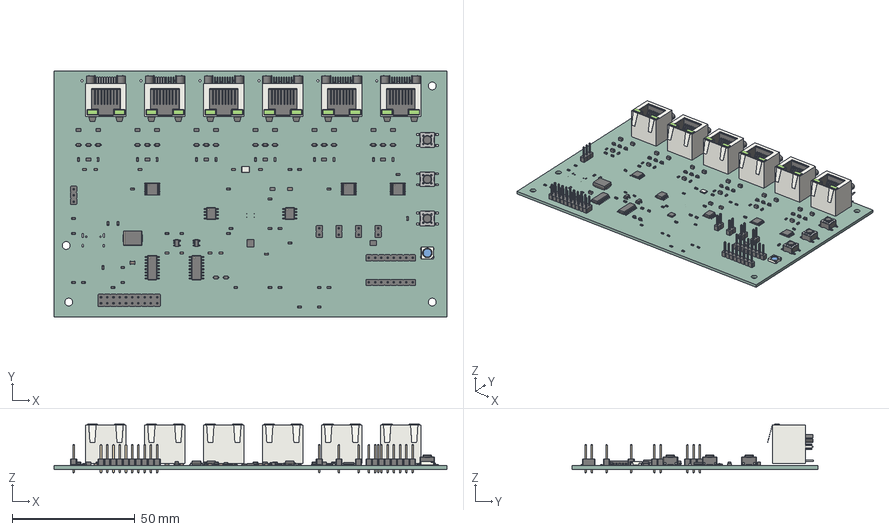
[picture p10: CAD file, 2026-10-31]
kicad/het68-core/fab/het68-core.step
160.0 x 100.0 x 19.8 mm
L_CommonModeChoke_Coilank_ACM2012 x 18
D_SOD-323 x 20
R_0603_1608Metric x 25
RJ45_Amphenol_RJHSE538X x 6
L_0805_2012Metric
TSSOP-16_4.4x5mm_P0.65mm x 3
L_0603_1608Metric x 6
Fuse_0603_1608Metric x 6
PinHeader_1x02_P254mm_Vertical x 4
SOIC-16_3.9x9.9mm_P1.27mm x 2
D_SMC
Bosch_LGA_8_2x25mm_P065mm_ClockwisePinNumbering
SOIC-8_3.9x4.9mm_P1.27mm x 2
C_0603_1608Metric x 17
Crystal_SMD_3225-4Pin_3.2x2.5mm
PinHeader_1x03_P254mm_Vertical
PinHeader_1x08_P254mm_Vertical x 2
SW_SPST_PTS645Sx43SMTR92 x 3
C_0805_2012Metric x 2
PinHeader_2x10_P254mm_Vertical
QFN-16-1EP_3x3mm_P0.5mm_EP1.7x1.7mm
LED_WS2812B_PLCC4_50x50mm_P32mm
SOT-23-5 x 2
het68-core_PCB
