fedurca/het68_pcb/kicad/het68-pwr-nn/fab/het68-pwr-nn.step

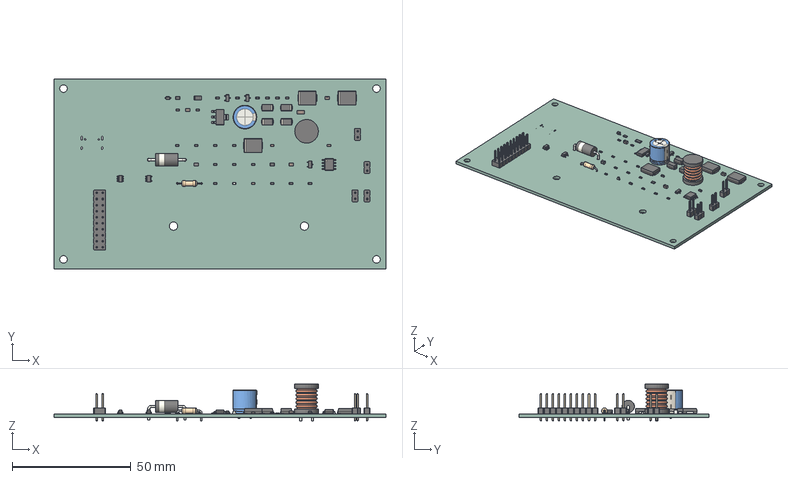
[picture p11: CAD file, 2026-10-29]
kicad/het68-pwr-nn/fab/het68-pwr-nn.step
140.0 x 80.0 x 15.6 mm
C_0805_2012Metric x 3
R_0603_1608Metric x 19
PinHeader_1x02_P254mm_Vertical x 4
D_SMA x 4
SOT-23-6
D_SOD-323
D_SMC x 3
C_0603_1608Metric x 3
SOT-23 x 3
L_0805_2012Metric
L_Radial_D10.0mm_P5.00mm_Fastron_07P
CP_Radial_D100mm_P500mm
R_0805_2012Metric x 2
SOT-223
SOIC-8_3.9x4.9mm_P1.27mm
D_DO-201_P15.24mm_Horizontal
R_Axial_DIN0207_L63mm_D25mm_P1016mm_Horizontal
PinHeader_2x10_P254mm_Vertical
SOT-23-5
LED_0603_1608Metric
R_1206_3216Metric
C_1206_3216Metric
het68-pwr-nn_PCB
