fedurca/het68_pcb/kicad/het68-pwr-vvn/fab/het68-pwr-vvn.step

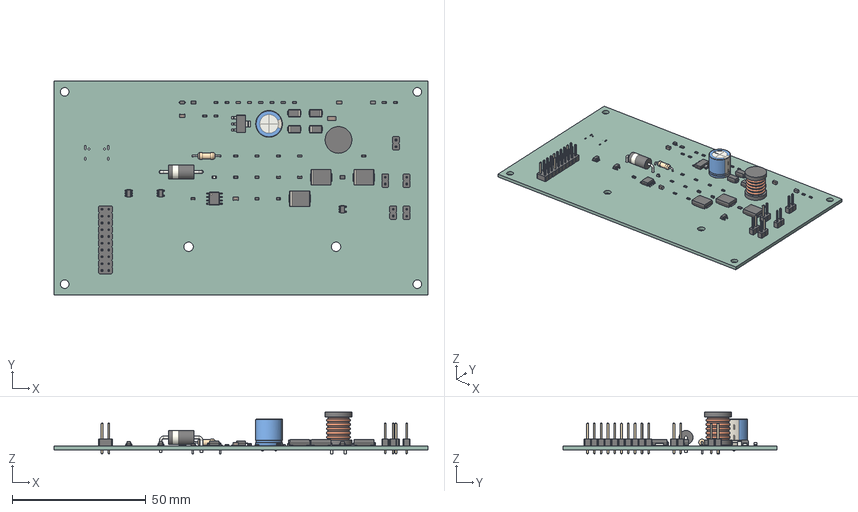
[picture p12: CAD file, 2026-10-29]
kicad/het68-pwr-vvn/fab/het68-pwr-vvn.step
140.0 x 80.0 x 15.6 mm
R_0603_1608Metric x 19
D_SMA x 4
SOT-23-6
CP_Radial_D100mm_P500mm
C_0603_1608Metric x 5
R_Axial_DIN0207_L63mm_D25mm_P1016mm_Horizontal
D_SOD-323
PinHeader_1x02_P254mm_Vertical x 5
SOT-23-5 x 2
LED_0603_1608Metric
D_DO-201_P15.24mm_Horizontal
C_0805_2012Metric x 3
D_SMC x 3
C_1206_3216Metric
R_0805_2012Metric x 2
L_0805_2012Metric
PinHeader_2x10_P254mm_Vertical
SOT-223
SOIC-8_3.9x4.9mm_P1.27mm
L_Radial_D10.0mm_P5.00mm_Fastron_07P
het68-pwr-vvn_PCB
