fedurca/het68_pcb/kicad/het68-sat/fab/het68-sat.step

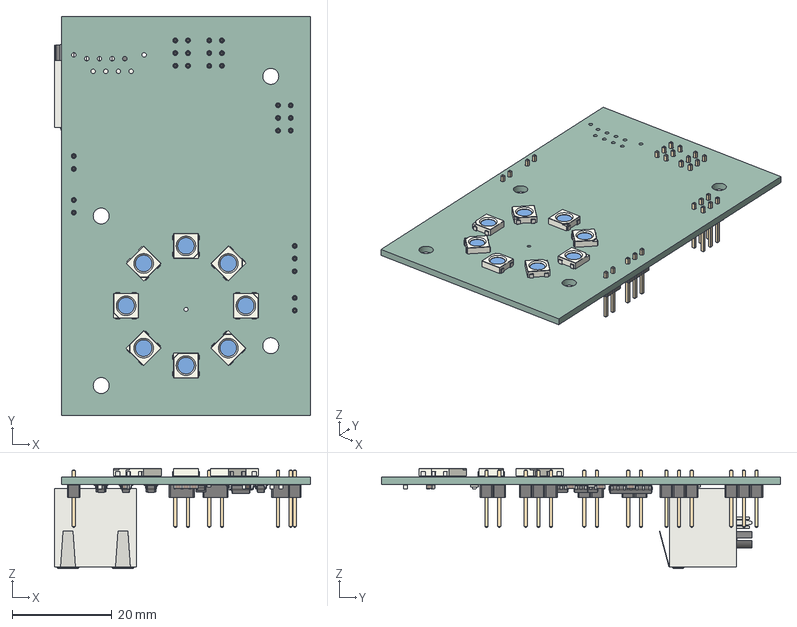
[picture p13: CAD file, 2026-10-31]
kicad/het68-sat/fab/het68-sat.step
51.4 x 80.0 x 20.1 mm
LED_WS2812B_PLCC4_50x50mm_P32mm x 8
RJ45_Amphenol_RJHSE538X
C_0603_1608Metric x 13
SOIC-14_3.9x8.7mm_P1.27mm
L_CommonModeChoke_Coilank_ACM2012 x 3
PinHeader_1x03_P254mm_Vertical
R_0603_1608Metric x 5
D_SOD-323 x 3
SOT-23-5 x 4
PinHeader_1x02_P254mm_Vertical x 3
Fuse_0603_1608Metric
PinHeader_2x03_P254mm_Vertical x 3
L_0603_1608Metric
het68-sat_PCB
