fedurca/het68_pcb/(list of files, cad)

Other CAD files:
kicad/het68-pwr-vn/fab/het68-pwr-vn.step
