fedurca/het68_pcb/docs/img/core-sch.pdf

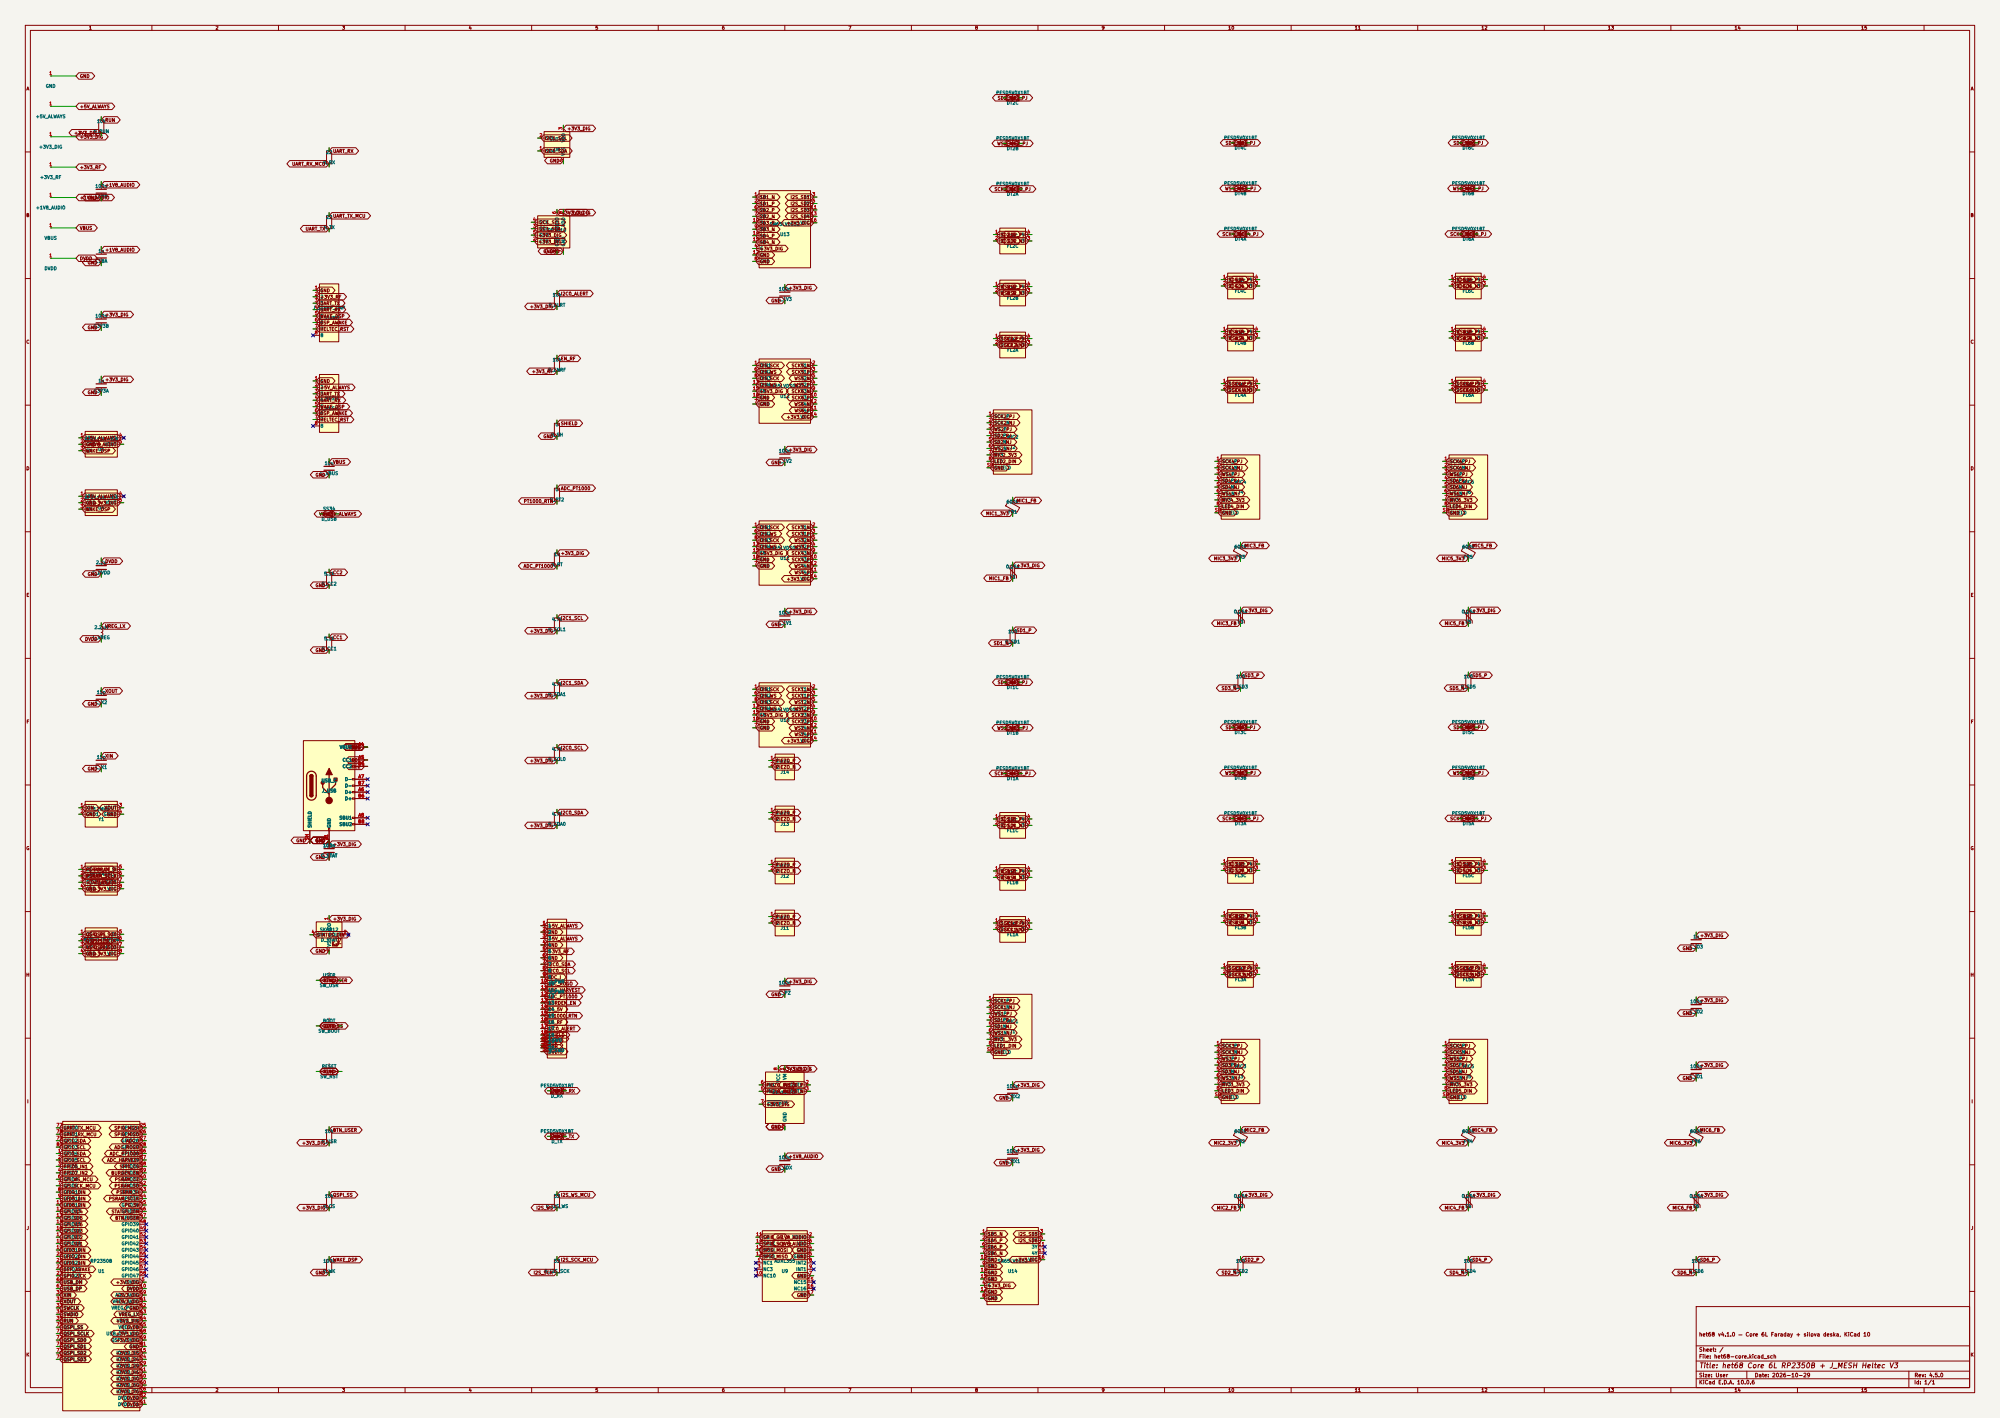
[picture p14: page 1]

het68 v4.1.0 — Core 6L Faraday + silova deska, KiCad 10

Size: User | Rev: 4.5.0
KiCad E.D.A. 10.0.6 | Id: 1/1
