fedurca/het68_pcb/docs/img/pwr-nn-sch.pdf

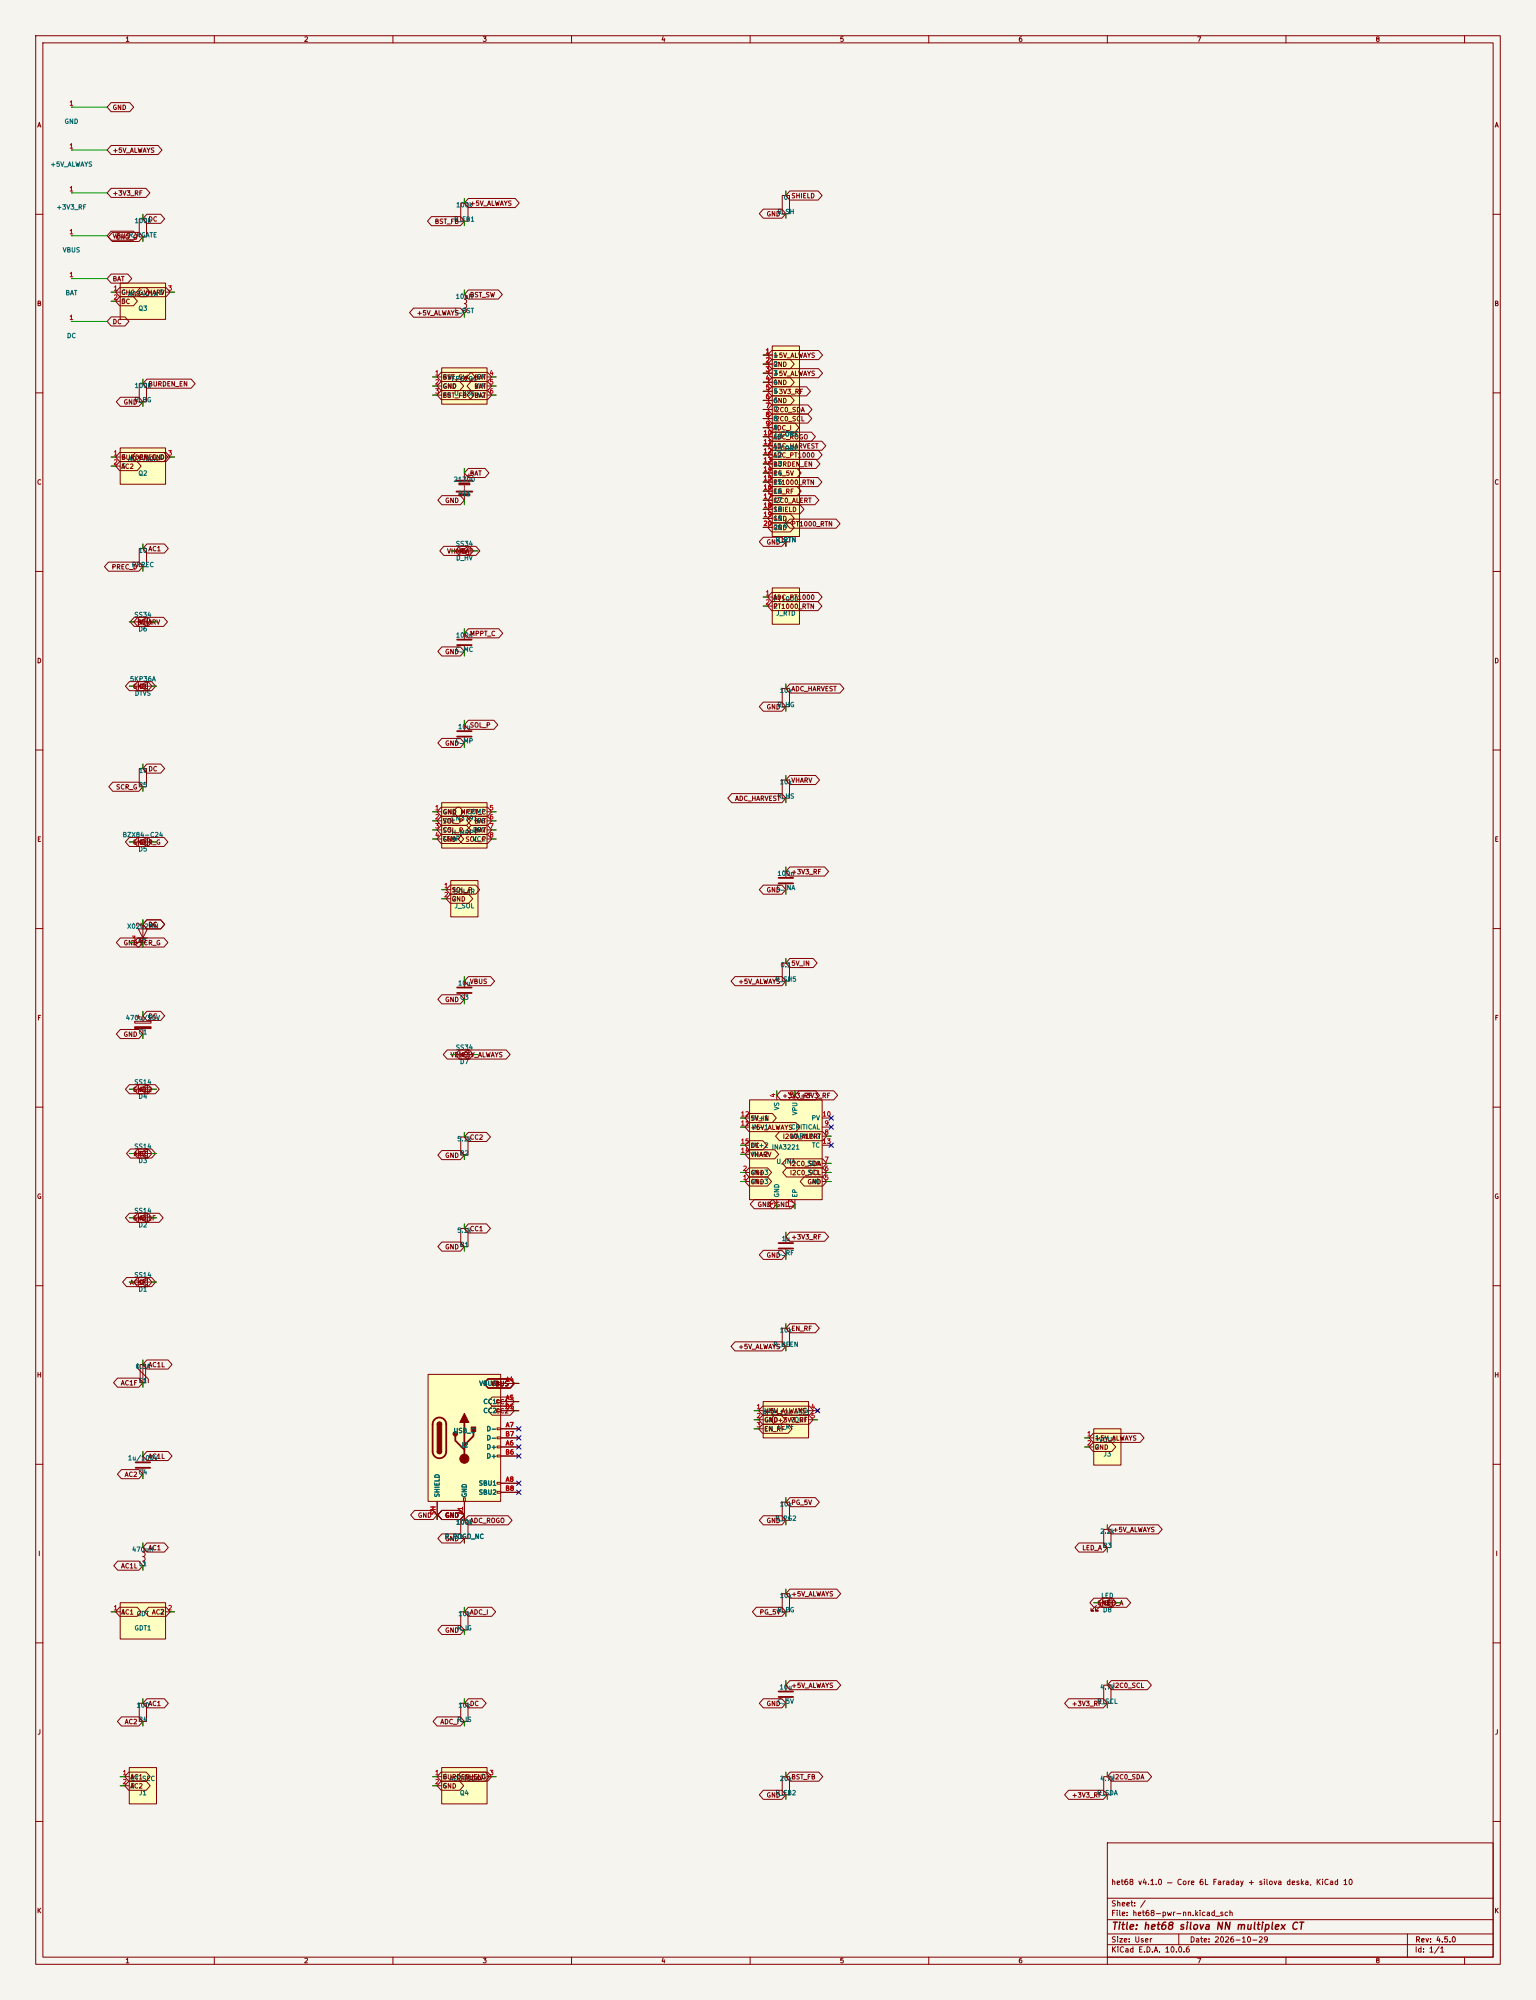
[picture p15: page 1]

het68 v4.1.0 — Core 6L Faraday + silova deska, KiCad 10

Sheet: /
File: het68-pwr-nn.kicad_sch
Title: het68 silova NN multiplex CT

Size: User | Rev: 4.5.0
KiCad E.D.A. 10.0.6 | Id: 1/1
