fedurca/het68_pcb/docs/img/v490/core-sch.pdf

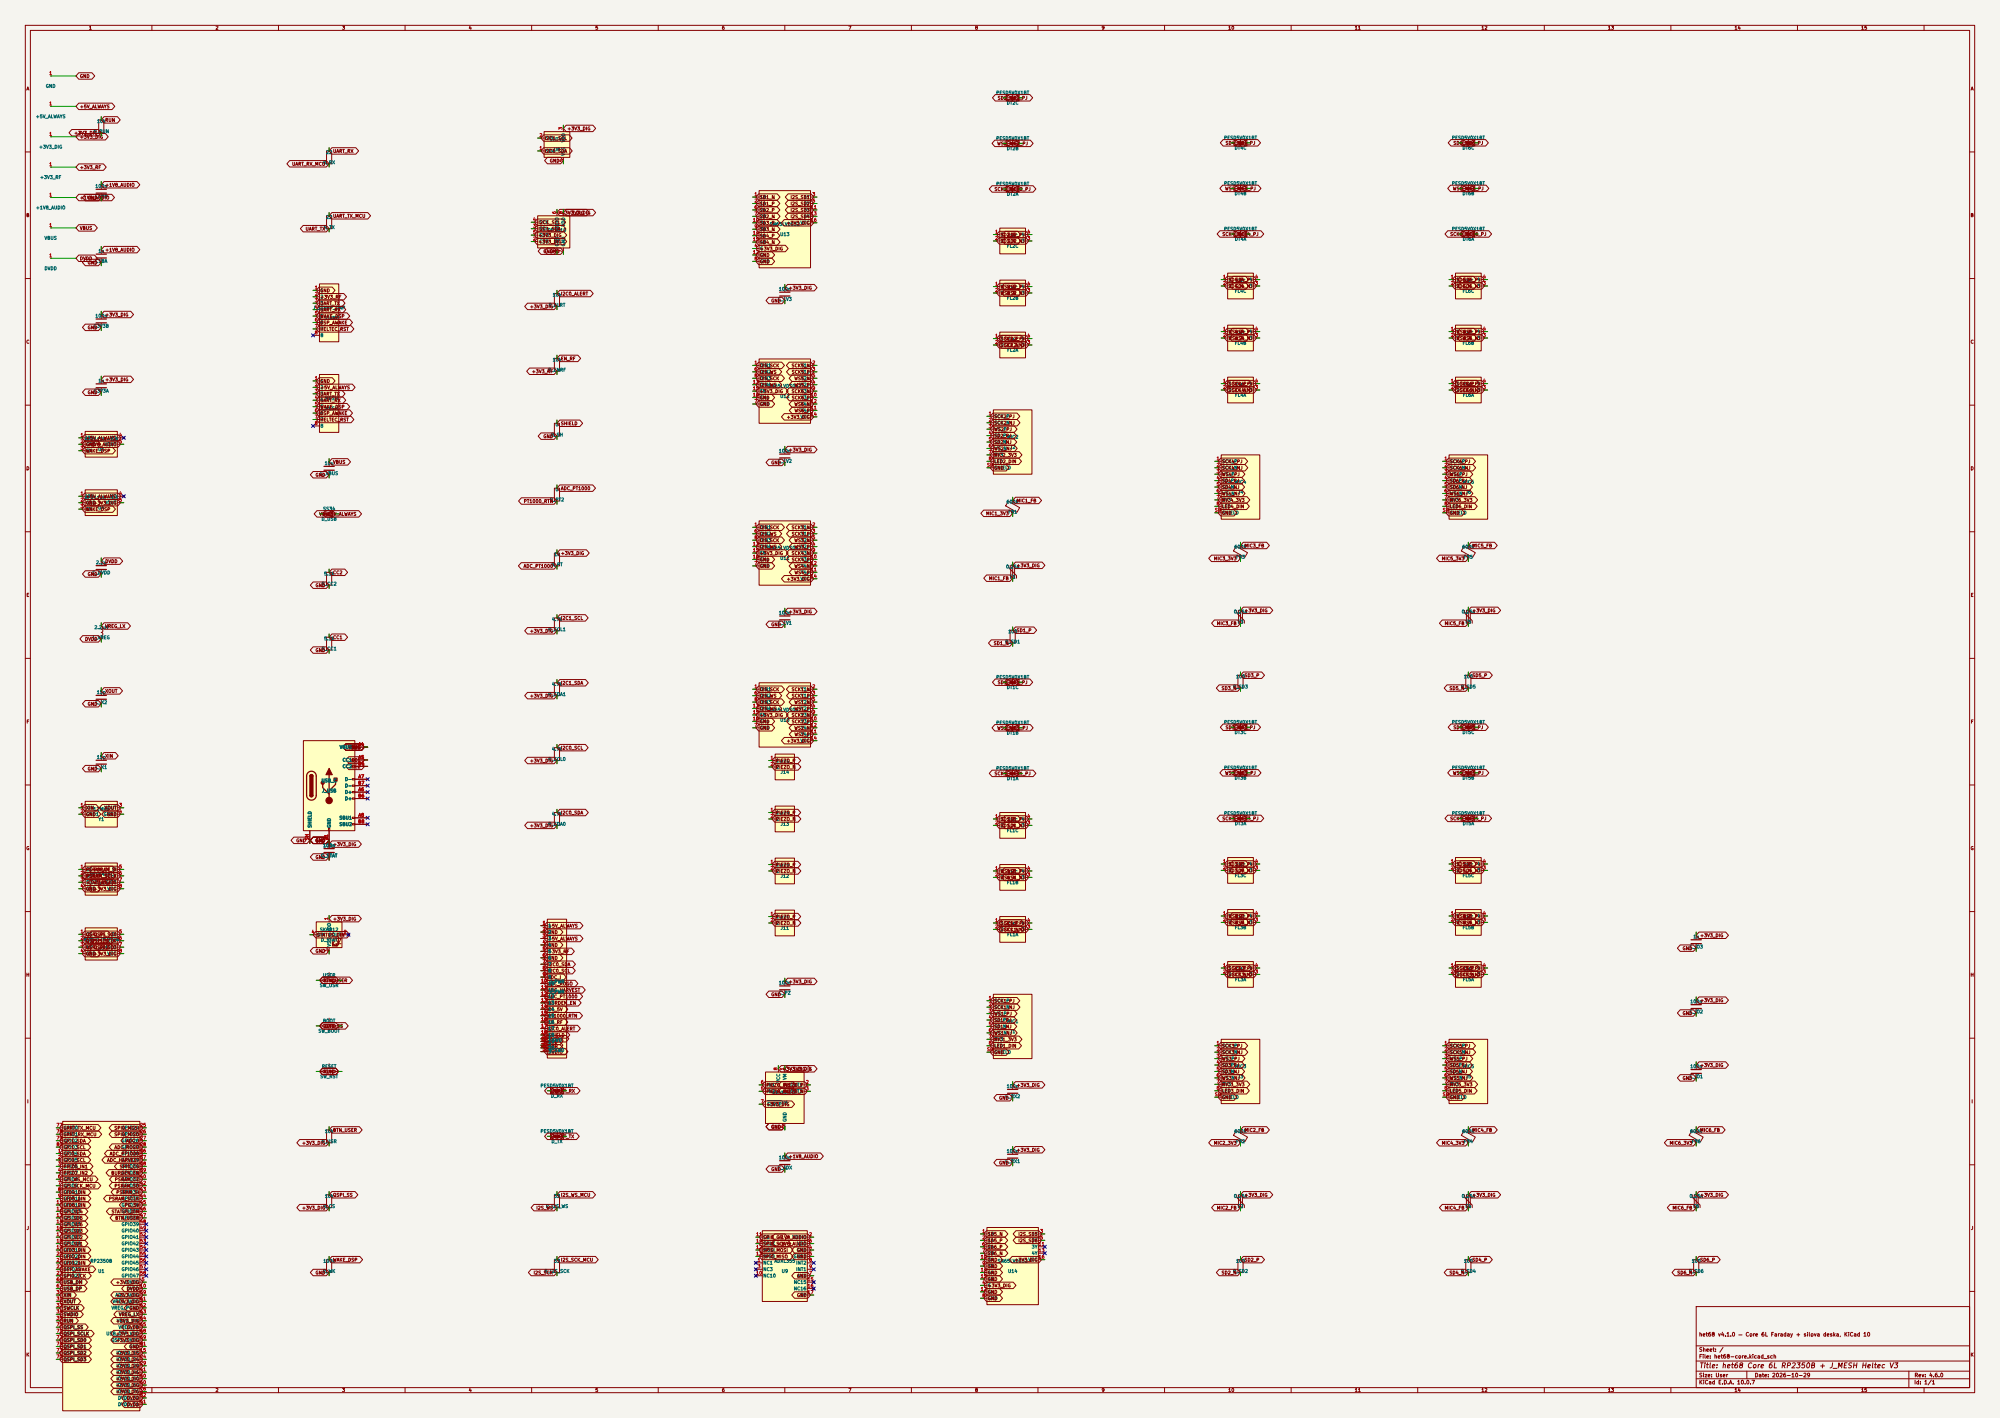
[picture p16: page 1]

het68 v4.1.0 — Core 6L Faraday + silova deska, KiCad 10

Size: User | Rev: 4.6.0
KiCad E.D.A. 10.0.7 | Id: 1/1
