fedurca/het68_pcb/docs/img/v490/sat-sch.pdf

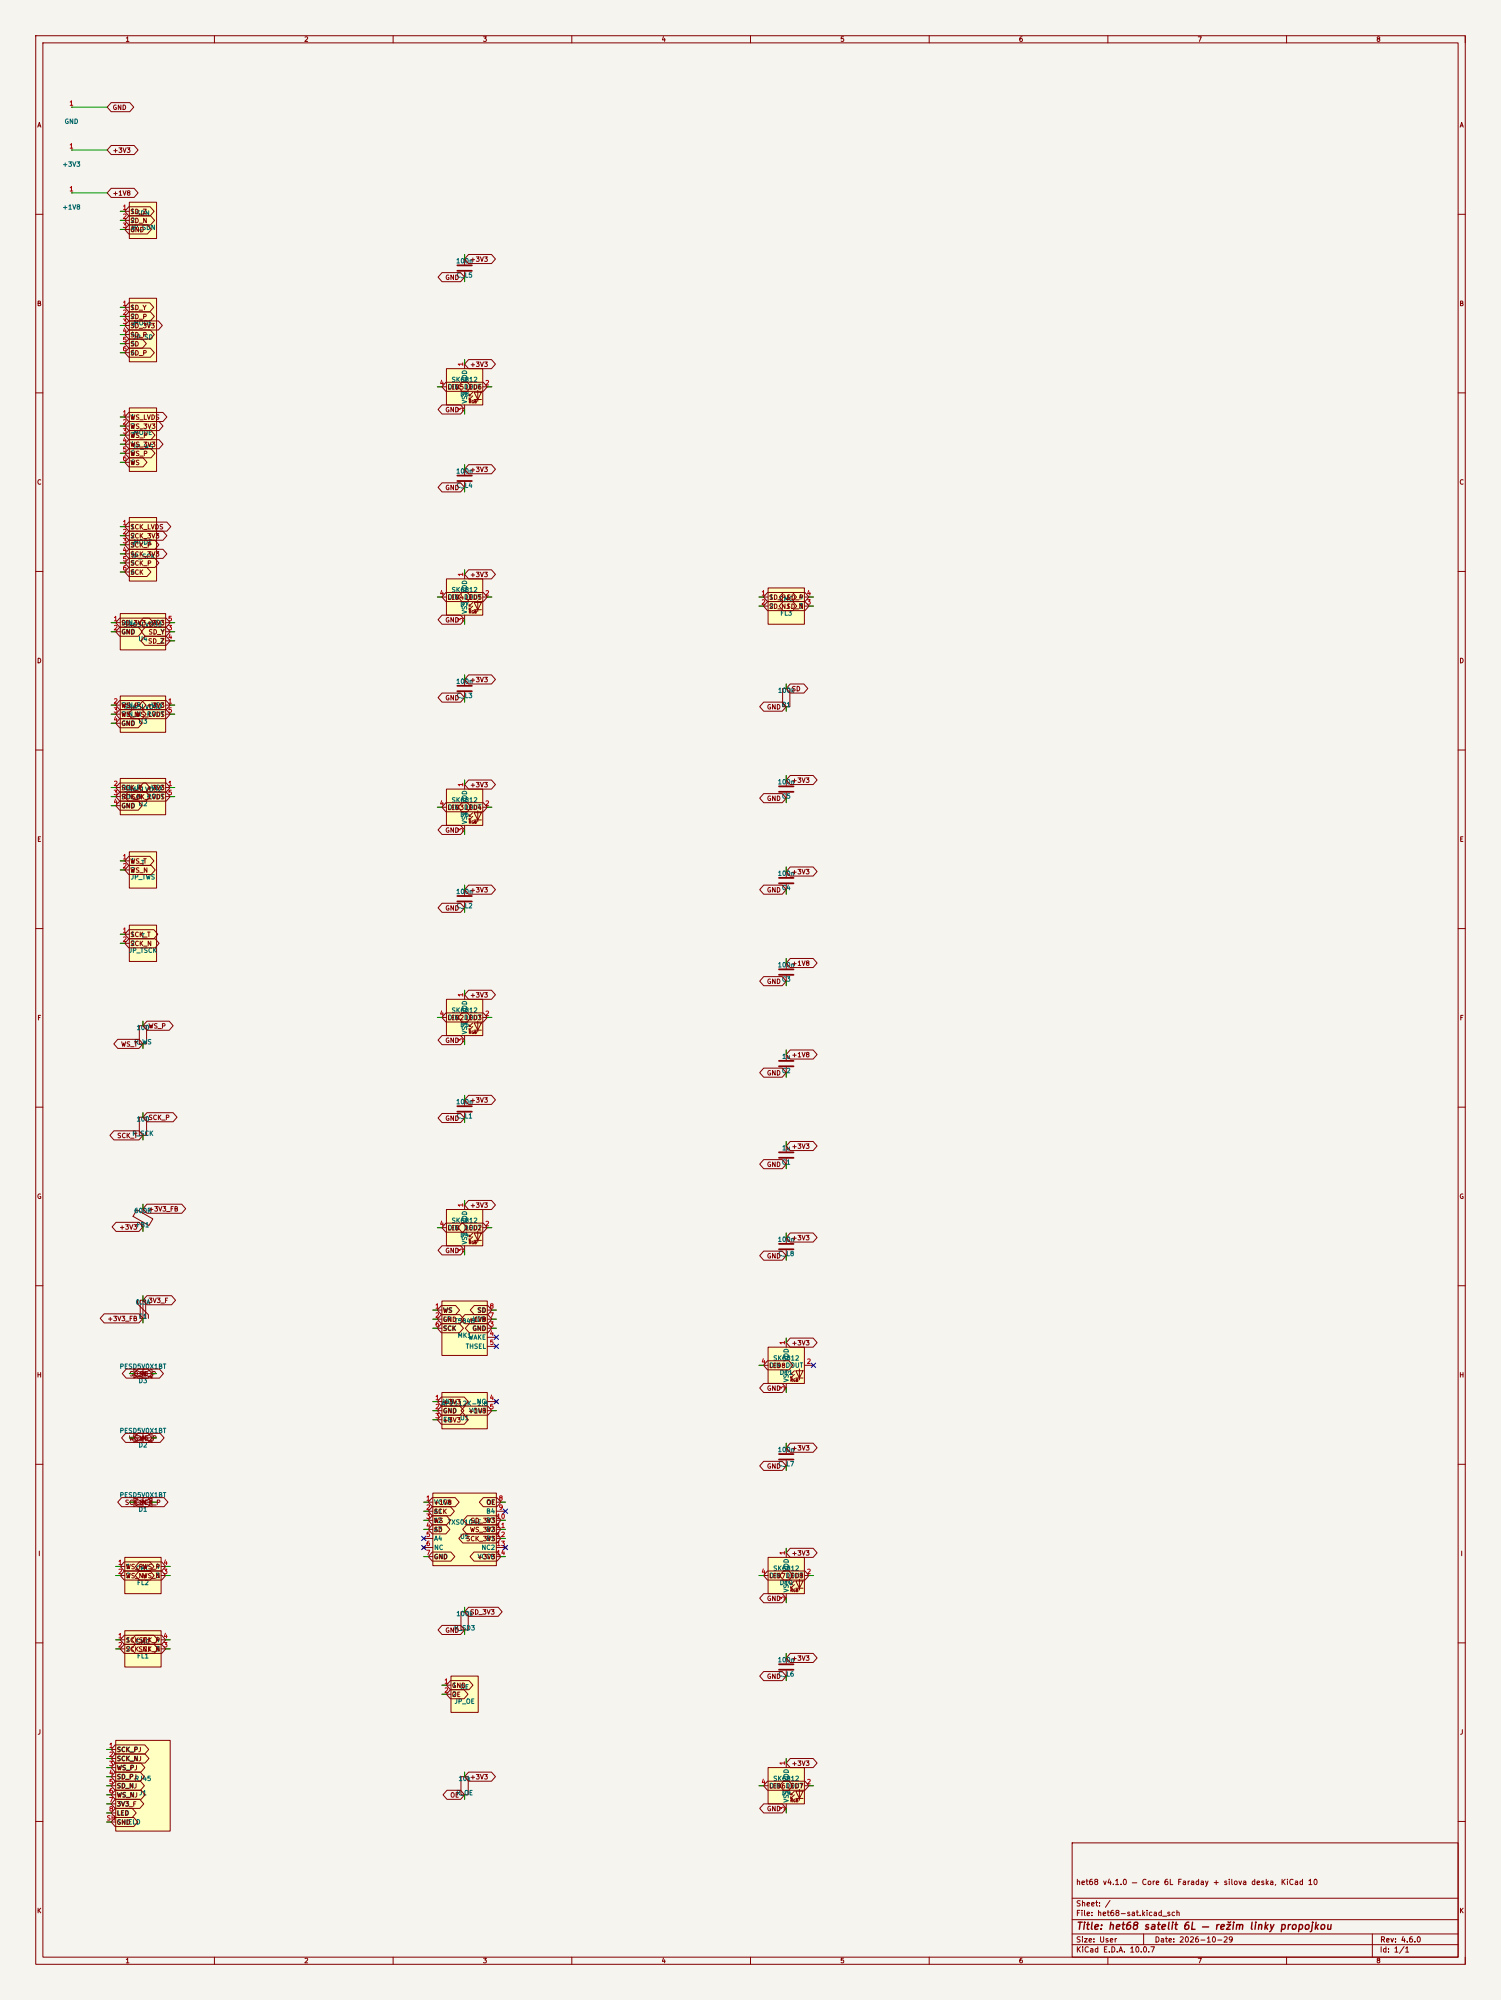
[picture p17: page 1]

Sheet: /
File: het68-sat.kicad_sch
Title: het68 satelit 6L — režim linky propojkou

Size: User | Rev: 4.6.0
KiCad E.D.A. 10.0.7 | Id: 1/1
