fedurca/het68_pcb/kicad/het68-pwr-vvn/fab/het68-pwr-vvn-sch.pdf

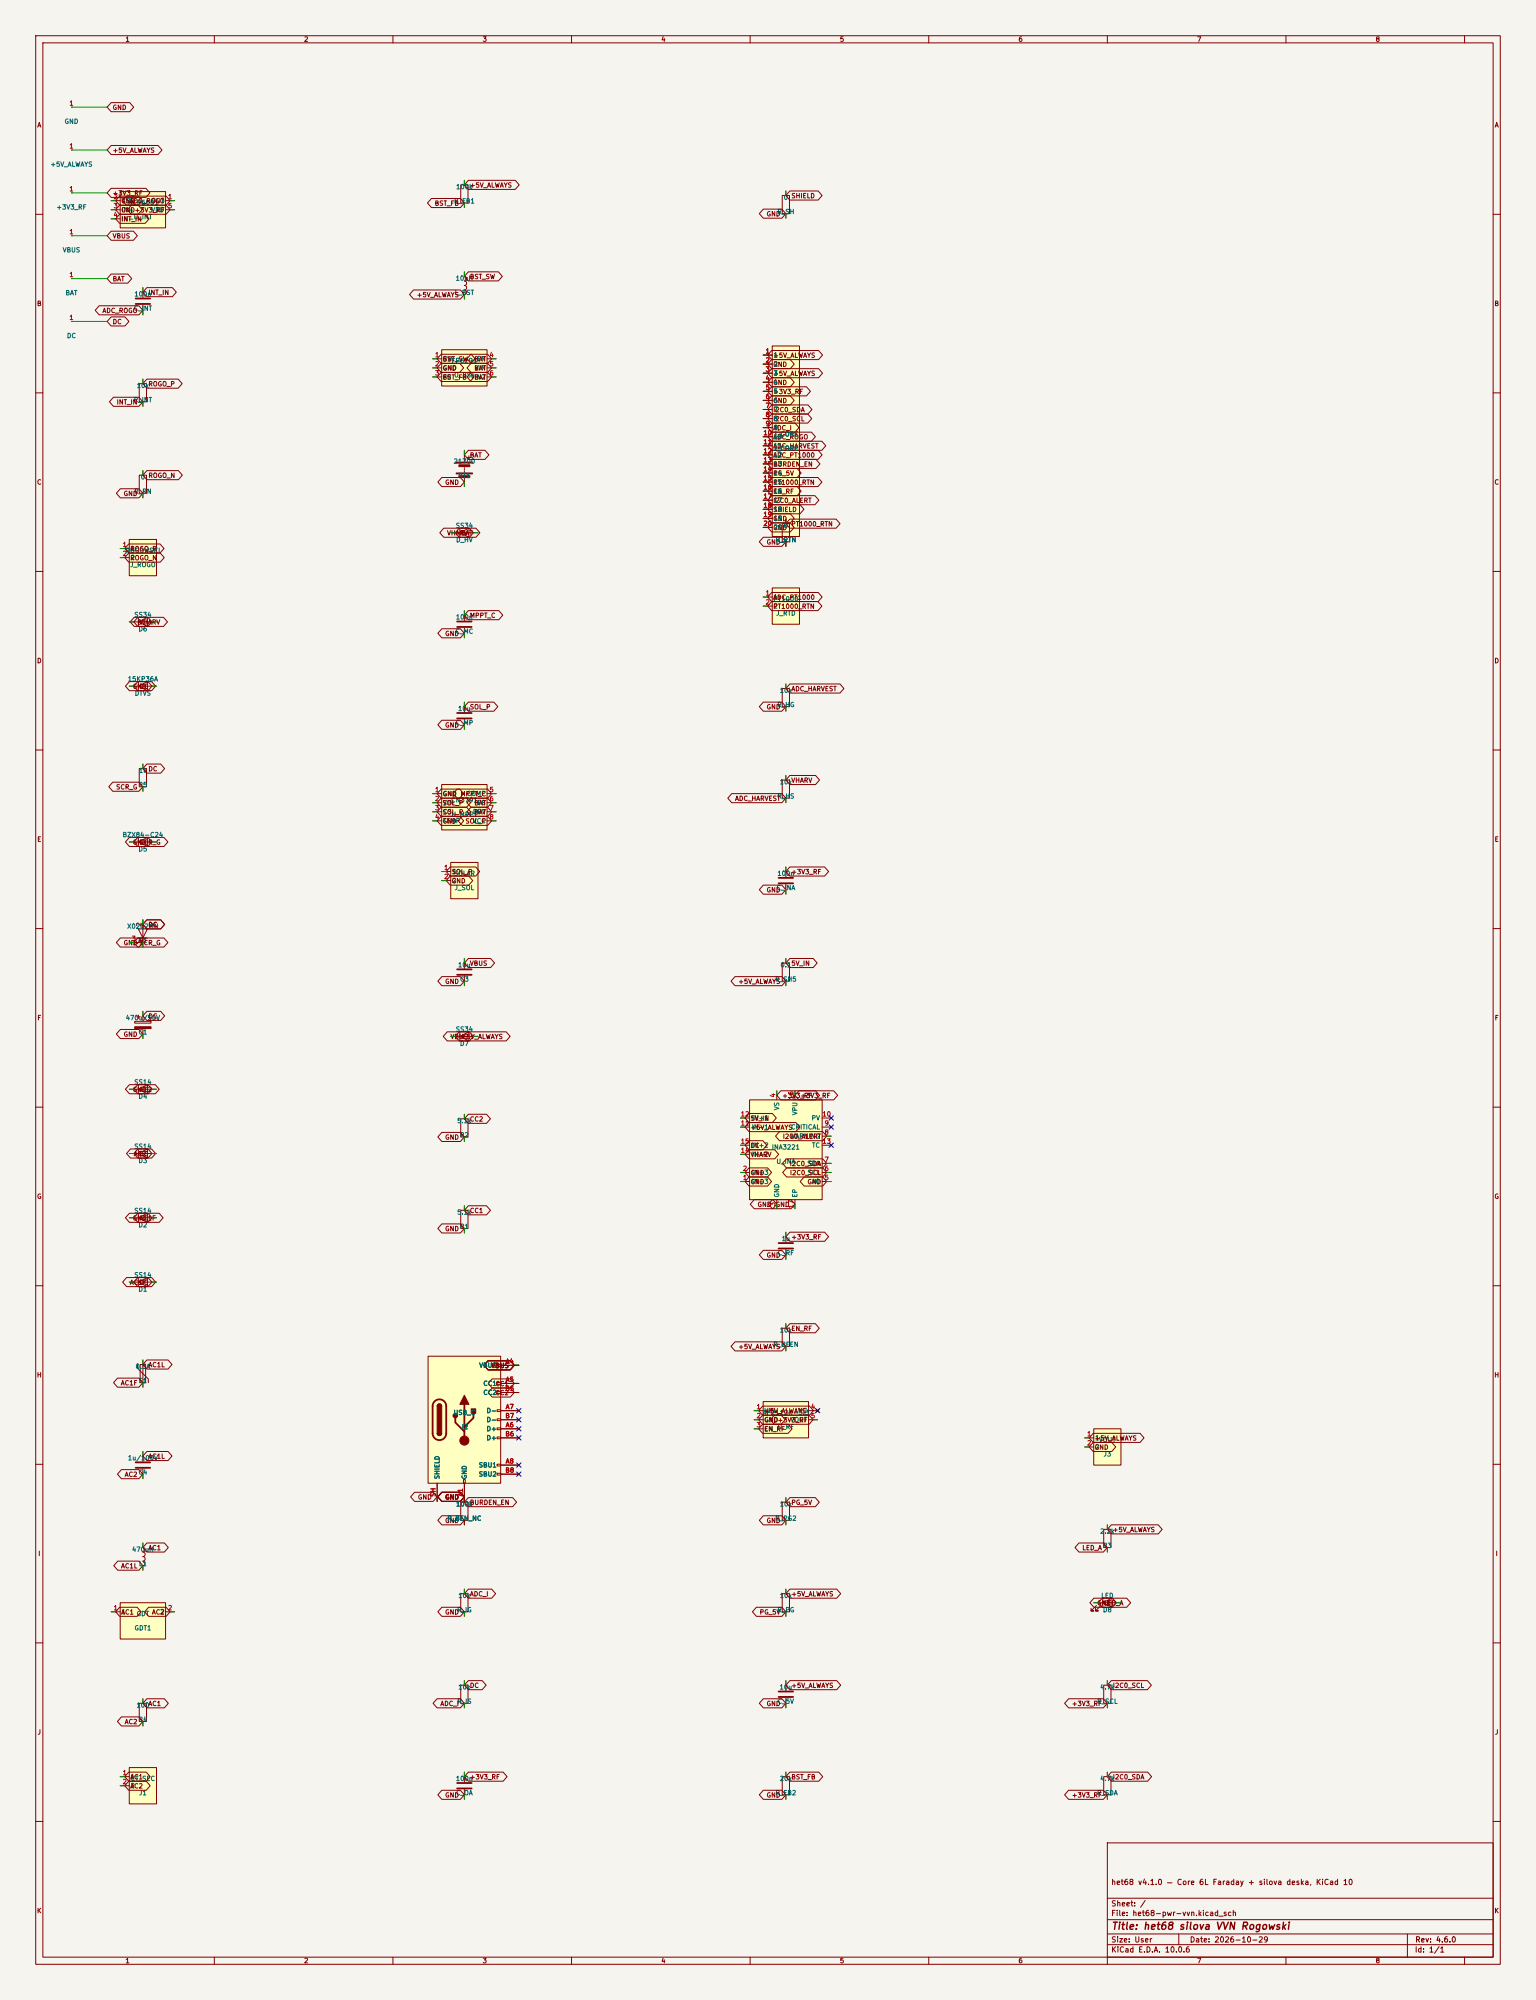
[picture p18: page 1]

het68 v4.1.0 — Core 6L Faraday + silova deska, KiCad 10

Sheet: /
File: het68-pwr-vvn.kicad_sch
Title: het68 silova VVN Rogowski

Size: User | Rev: 4.6.0
KiCad E.D.A. 10.0.6 | Id: 1/1
