fedurca/het68_pcb/kicad/het68-core/het68-core.kicad_pcb

## KiCad design kicad/het68-core/het68-core.kicad_pcb (2026-10-31)

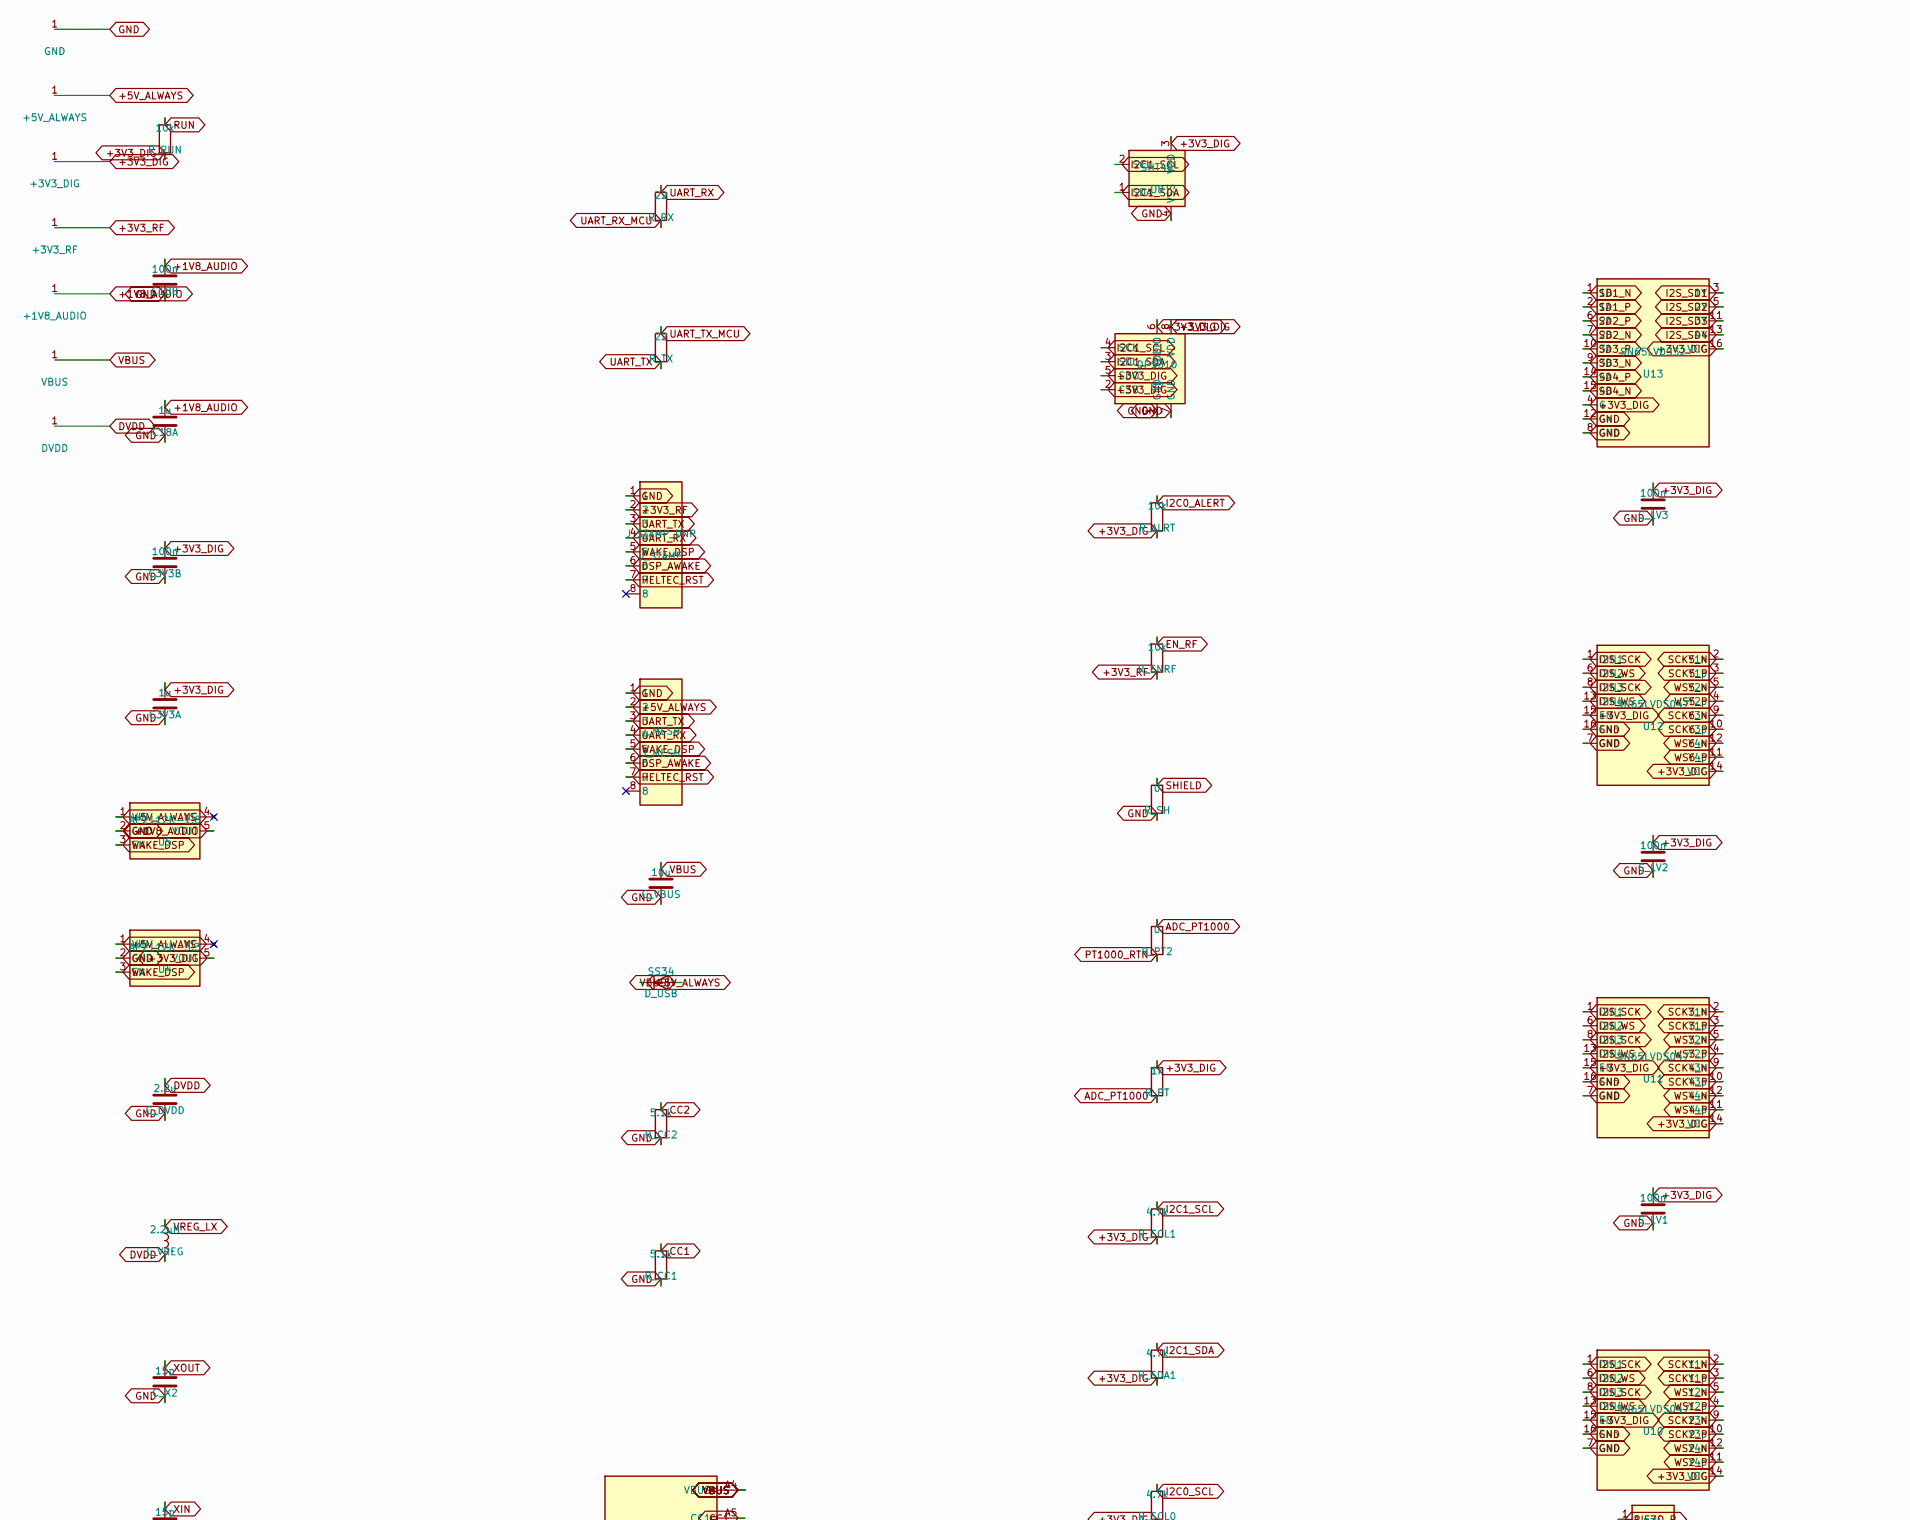
[picture p19: schematic het68-core.kicad_sch, het68 Core 6L RP2350B + J_MESH Heltec V3, part in row 1, column 1]

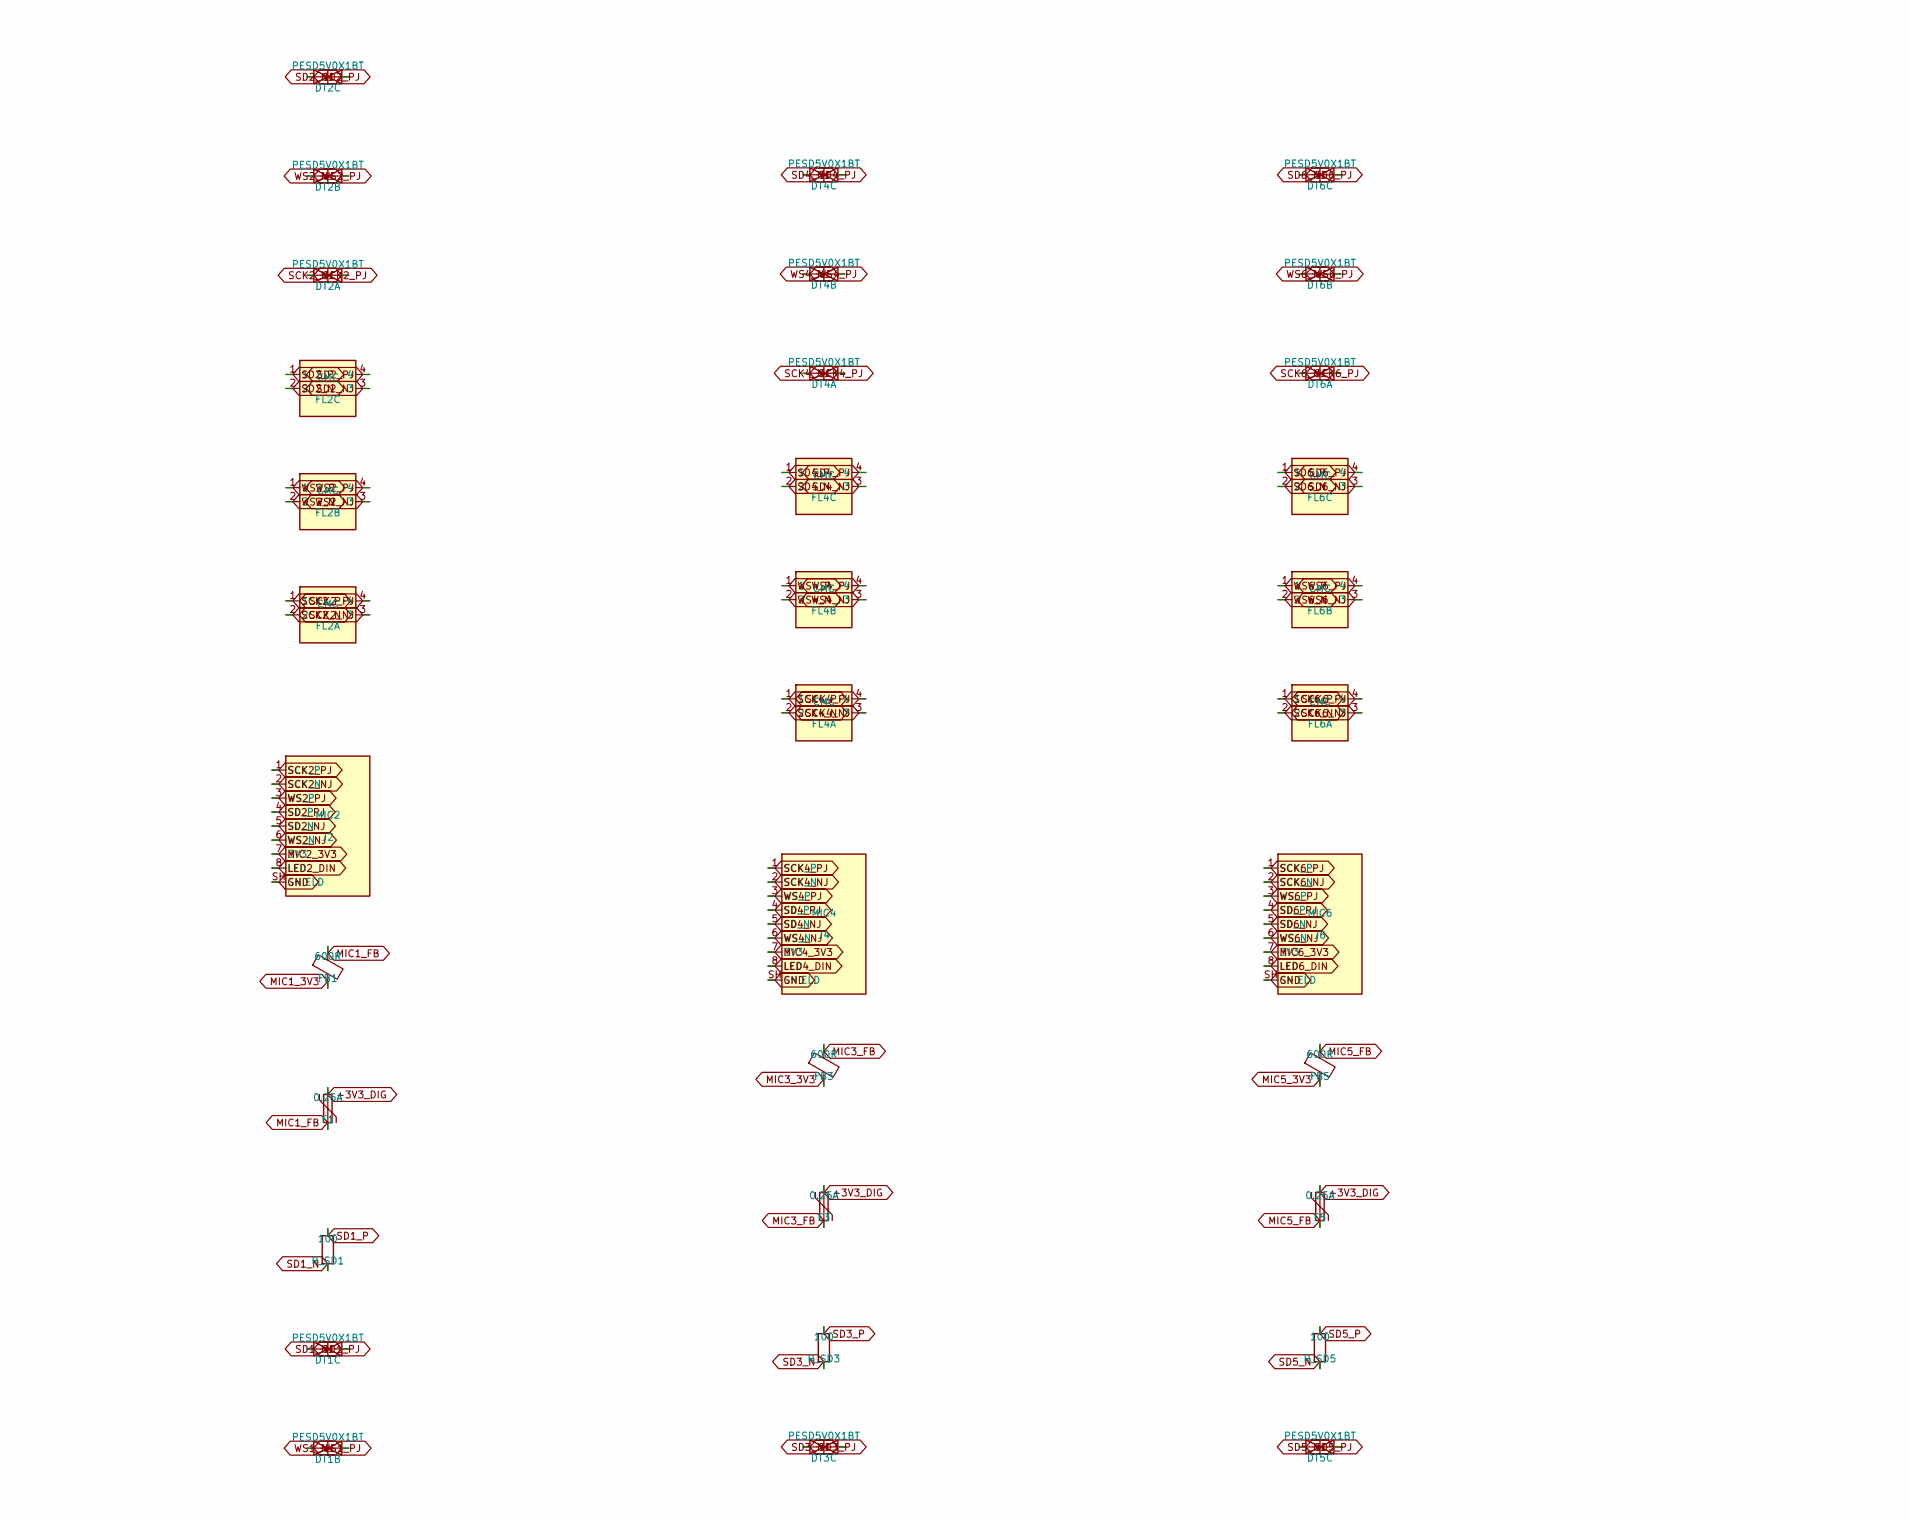
[picture p20: schematic het68-core.kicad_sch, het68 Core 6L RP2350B + J_MESH Heltec V3, part in row 1, column 2]

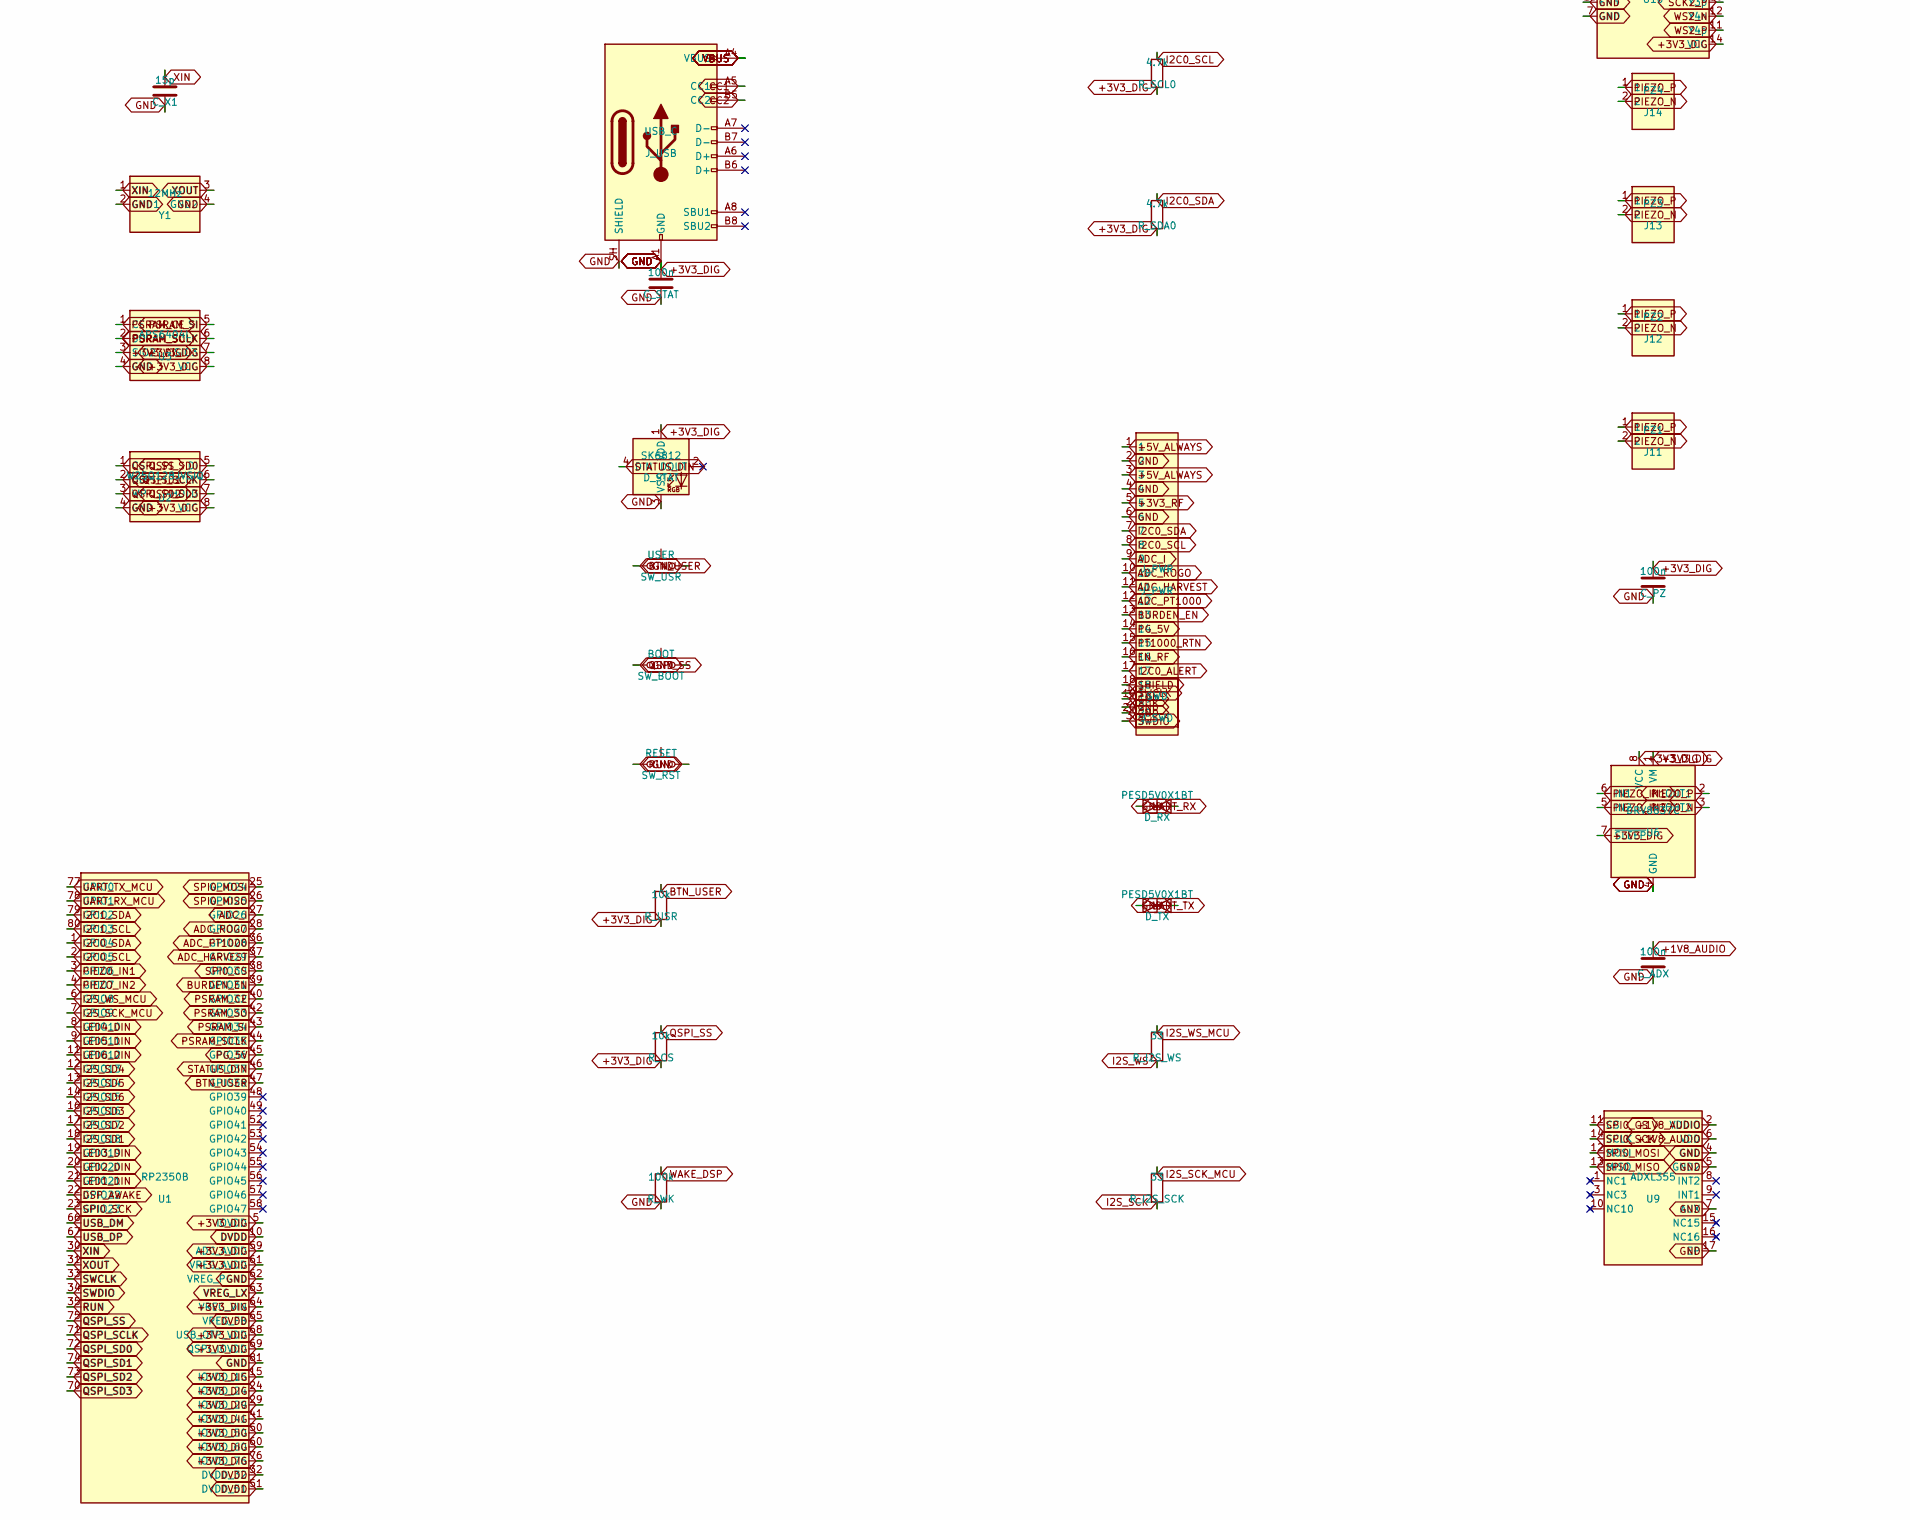
[picture p21: schematic het68-core.kicad_sch, het68 Core 6L RP2350B + J_MESH Heltec V3, part in row 2, column 1]

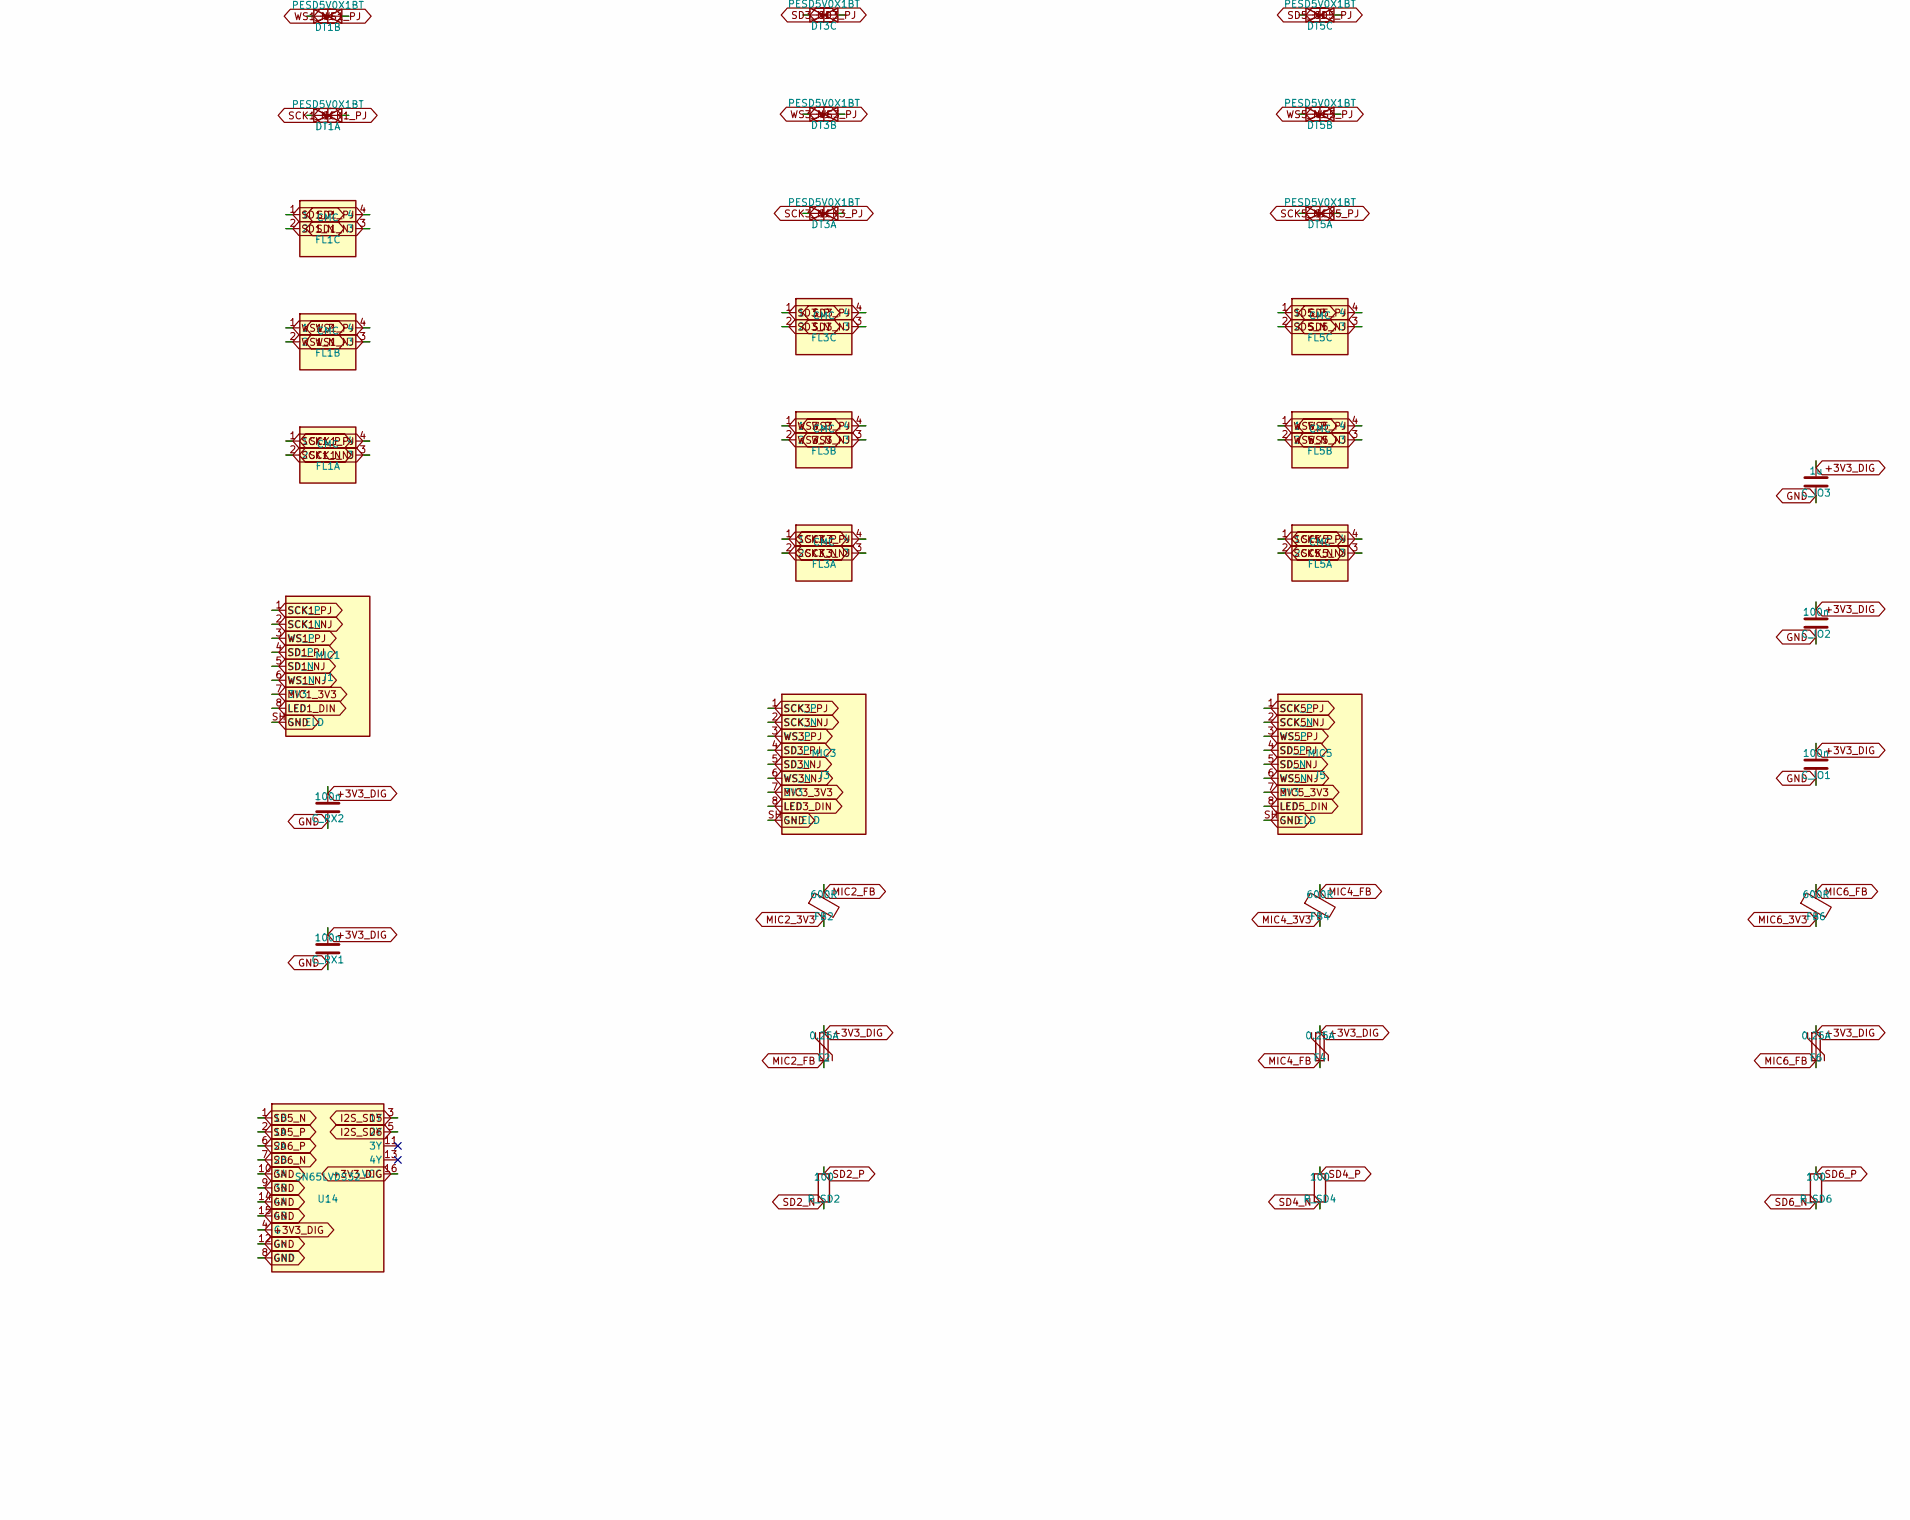
[picture p22: schematic het68-core.kicad_sch, het68 Core 6L RP2350B + J_MESH Heltec V3, part in row 2, column 2]

Parts:
C3V3A, C18A: 1u; C_0603_1608Metric; MPN CL10A105KA8NNNC
C3V3B, C18B: 100n; C_0603_1608Metric; MPN CL10B104KB8NNNC
C_ADX: 100n; C_0603_1608Metric; MPN CL10B104KB8NNNC
C_DVDD: 2.2u; C_0805_2012Metric; MPN CL21A225KOQNNNE
C_IO1, C_IO2: 100n; C_0603_1608Metric; MPN CL10B104KB8NNNC
C_IO3: 1u; C_0603_1608Metric; MPN CL10A105KA8NNNC
C_LV1, C_LV2, C_LV3: 100n; C_0603_1608Metric; MPN CL10B104KB8NNNC
C_PZ: 100n; C_0603_1608Metric; MPN CL10B104KB8NNNC
C_RX1, C_RX2: 100n; C_0603_1608Metric; MPN CL10B104KB8NNNC
C_STAT: 100n; C_0603_1608Metric; MPN CL10B104KB8NNNC
C_VBUS: 10u; C_0805_2012Metric; MPN CL21A106KOQNNNE
C_X1, C_X2: 15p; C_0603_1608Metric; MPN CL10C150JB8NNNC
DT1A, DT1B, DT1C, DT2A, DT2B, DT2C, DT3A, DT3B, DT3C, DT4A, DT4B, DT4C, DT5A, DT5B, DT5C, DT6A, DT6B, DT6C: PESD5V0X1BT; D_SOD-323; MPN PESD5V0X1BT
D_RX: PESD5V0X1BT; D_SOD-323; MPN PESD5V0X1BT
D_STAT: SK6812; LED_WS2812B_PLCC4_5.0x5.0mm_P3.2mm; MPN SK6812 (5050, 3.3 V)
D_TX: PESD5V0X1BT; D_SOD-323; MPN PESD5V0X1BT
D_USB: SS34; D_SMC; MPN SS34
F1, F2, F3, F4, F5, F6: 0.25A; Fuse_0603_1608Metric; MPN PPTC 0603
FB1, FB2, FB3, FB4, FB5, FB6: 600R; L_0603_1608Metric; MPN BLM18PG601SN1D
FL1A, FL1B, FL1C, FL2A, FL2B, FL2C, FL3A, FL3B, FL3C, FL4A, FL4B, FL4C, FL5A, FL5B, FL5C, FL6A, FL6B, FL6C: CMC; L_CommonModeChoke_Coilank_ACM2012; MPN ACM2012
J1: MIC1; RJ45_Vertical_het68; MPN RJ45-8P8C-VERT
J2: MIC2; RJ45_Vertical_het68; MPN RJ45-8P8C-VERT
J3: MIC3; RJ45_Vertical_het68; MPN RJ45-8P8C-VERT
J4: MIC4; RJ45_Vertical_het68; MPN RJ45-8P8C-VERT
J5: MIC5; RJ45_Vertical_het68; MPN RJ45-8P8C-VERT
J6: MIC6; RJ45_Vertical_het68; MPN RJ45-8P8C-VERT
J11: PZ1; PinHeader_1x02_P2.54mm_Vertical; MPN PS1240
J12: PZ2; PinHeader_1x02_P2.54mm_Vertical; MPN PS1240
J13: PZ3; PinHeader_1x02_P2.54mm_Vertical; MPN PS1240
J14: PZ4; PinHeader_1x02_P2.54mm_Vertical; MPN PS1240
J_MESH: J_MESH; PinHeader_1x08_P2.54mm_Vertical; MPN PinHeader 1x8 Heltec V3
J_PWR: J_PWR; PinHeader_2x10_P2.54mm_Vertical; MPN interconnect 2x10
J_STAMP: J_STAMP_DNP; PinHeader_1x08_P2.54mm_Vertical; MPN DNP stamp RAK class
J_SWD: SWD; PinHeader_1x03_P2.54mm_Vertical; MPN SWD
J_USB: USB_C; USB_C_Receptacle_HRO_TYPE-C-31-M-12; MPN TYPE-C-31-M-12
L_VREG: 2.2uH; L_0805_2012Metric; MPN 2.2uH VREG
R_ALRT: 10k; R_0603_1608Metric; MPN RC0603FR-0710KL
R_CC1, R_CC2: 5.1k; R_0603_1608Metric; MPN RC0603FR-075K1L
R_CS: 10k; R_0603_1608Metric; MPN RC0603FR-0710KL
R_ENRF: 10k; R_0603_1608Metric; MPN RC0603FR-0710KL
R_I2S_SCK, R_I2S_WS: 33; R_0603_1608Metric; MPN RC0603FR-0733RL
R_PT: 1k; R_0603_1608Metric; MPN RC0603FR-071KL
R_PT2: 0; R_0603_1608Metric; MPN RC0603FR-070RL
R_RUN: 10k; R_0603_1608Metric; MPN RC0603FR-0710KL
R_RX: 22; R_0603_1608Metric; MPN RC0603FR-0722RL
R_SCL0, R_SCL1: 4.7k; R_0603_1608Metric; MPN RC0603FR-074K7L
R_SD1, R_SD2, R_SD3, R_SD4, R_SD5, R_SD6: 100; R_0603_1608Metric; MPN RC0603FR-07100RL
R_SDA0, R_SDA1: 4.7k; R_0603_1608Metric; MPN RC0603FR-074K7L
R_SH: 0; R_0603_1608Metric; MPN RC0603FR-070RL
R_TX: 22; R_0603_1608Metric; MPN RC0603FR-0722RL
R_USR: 10k; R_0603_1608Metric; MPN RC0603FR-0710KL
R_WK: 100k; R_0603_1608Metric; MPN RC0603FR-07100KL
SW_BOOT: BOOT; SW_SPST_PTS645Sx43SMTR92; MPN PTS645SM43SMTR92
SW_RST: RESET; SW_SPST_PTS645Sx43SMTR92; MPN PTS645SM43SMTR92
SW_USR: USER; SW_SPST_PTS645Sx43SMTR92; MPN PTS645SM43SMTR92
U1: RP2350B; QFN-80-1EP_10x10mm_P0.4mm_EP3.4x3.4mm_ThermalVias; MPN RP2350B
U2: W25Q128JVSIQ; SOIC-8_3.9x4.9mm_P1.27mm; MPN W25Q128JVSIQ
U3: APS6404L; SOIC-8_3.9x4.9mm_P1.27mm; MPN APS6404L-3SQR-SN
U4: AP2112K-3.3; SOT-23-5; MPN AP2112K-3.3TRG1
U5: AP2112K-1.8; SOT-23-5; MPN AP2112K-1.8TRG1
U6: DRV8837C; Texas_DSG0008A_WSON-8-1EP_2x2mm_P0.5mm_EP0.9x1.6mm; MPN DRV8837CDSGR
U7: DPS310; Bosch_LGA-8_2x2.5mm_P0.65mm_ClockwisePinNumbering; MPN DPS310
U8: SHT40; Sensirion_DFN-4_1.5x1.5mm_P0.8mm_SHT4x_NoCentralPad; MPN SHT40-AD1B-R2
U9: ADXL355; QFN-16-1EP_3x3mm_P0.5mm_EP1.7x1.7mm; MPN ADXL355BCCZ
U10, U11, U12: SN65LVDS047; TSSOP-16_4.4x5mm_P0.65mm; MPN SN65LVDS047PW
U13, U14: SN65LVDS32; SOIC-16_3.9x9.9mm_P1.27mm; MPN SN65LVDS32D
Y1: 12MHz; Crystal_SMD_3225-4Pin_3.2x2.5mm; MPN 12MHz 3225

Connections:
+1V8_AUDIO: C18A.1, C18B.1, C_ADX.1, U5.5 (VOUT), U9.2 (VDDIO), U9.6 (VDD)
+3V3_DIG: C3V3A.1, C3V3B.1, C_IO1.1, C_IO2.1, C_IO3.1, C_LV1.1, C_LV2.1, C_LV3.1, C_PZ.1, C_RX1.1, C_RX2.1, C_STAT.1, D_STAT.1 (VDD), F1.1, F2.1, F3.1, F4.1, F5.1, F6.1, R_ALRT.2, R_CS.2, R_PT.1, R_RUN.2, R_SCL0.2, R_SCL1.2, R_SDA0.2, R_SDA1.2, R_USR.2, U1.5 (IOVDD), U1.15 (IOVDD_15), U1.24 (IOVDD_24), U1.29 (IOVDD_29), U1.41 (IOVDD_41), U1.50 (IOVDD_50), U1.59 (ADC_AVDD), U1.60 (IOVDD_60), U1.61 (VREG_AVDD), U1.64 (VREG_VIN), U1.68 (USB_OTP_VDD), U1.69 (QSPI_IOVDD), U1.76 (IOVDD_76), U2.8 (VCC), U3.3 (SIO2), U3.7 (SIO3), U3.8 (VCC), U4.5 (VOUT), U6.1 (VM), U6.7 (~SLEEP), U6.8 (VCC), U7.2 (CSB), U7.5 (SDO), U7.6 (VDDIO), U7.8 (VDD), U8.3 (VDD), U10.14 (VCC), U10.15 (EN), U11.14 (VCC), U11.15 (EN), U12.14 (VCC), U12.15 (EN), U13.4 (G), U13.16 (VCC), U14.4 (G), U14.16 (VCC)
+3V3_RF: J_PWR.5, J_STAMP.2, R_ENRF.2
+5V_ALWAYS: D_USB.1 (K), J_MESH.2, J_PWR.1, J_PWR.3, U4.1 (VIN), U5.1 (VIN)
ADC_HARVEST: J_PWR.11, U1.37 (GPIO29)
ADC_I: J_PWR.9, U1.27 (GPIO26)
ADC_PT1000: J_PWR.12, R_PT.2, R_PT2.1, U1.36 (GPIO28)
ADC_ROGO: J_PWR.10, U1.28 (GPIO27)
BTN_USER: R_USR.1, SW_USR.1, U1.47 (GPIO38)
BURDEN_EN: J_PWR.13, U1.39 (GPIO31)
CC1: J_USB.A5 (CC1), R_CC1.1
CC2: J_USB.B5 (CC2), R_CC2.1
DSP_AWAKE: J_MESH.6, J_STAMP.6, U1.22 (GPIO22)
DVDD: C_DVDD.1, L_VREG.2, U1.10 (DVDD), U1.32 (DVDD_32), U1.51 (DVDD_51), U1.65 (VREG_FB)
EN_RF: J_PWR.16, R_ENRF.1
GND: C3V3A.2, C3V3B.2, C18A.2, C18B.2, C_ADX.2, C_DVDD.2, C_IO1.2, C_IO2.2, C_IO3.2, C_LV1.2, C_LV2.2, C_LV3.2, C_PZ.2, C_RX1.2, C_RX2.2, C_STAT.2, C_VBUS.2, C_X1.2, C_X2.2, D_RX.2 (A2), D_STAT.3 (VSS), D_TX.2 (A2), J1.SH (SHIELD), J2.SH (SHIELD), J3.SH (SHIELD), J4.SH (SHIELD), J5.SH (SHIELD), J6.SH (SHIELD), J_MESH.1, J_PWR.2, J_PWR.4, J_PWR.6, J_PWR.19, J_PWR.20, J_STAMP.1, J_SWD.2, J_USB.A1 (GND), J_USB.A12 (GND), J_USB.B1 (GND), J_USB.B12 (GND), J_USB.SH (SHIELD), R_CC1.2, R_CC2.2, R_SH.2, R_WK.2, SW_BOOT.2, SW_RST.2, SW_USR.2, U1.62 (VREG_PGND), U1.81 (GND), U2.4 (GND), U3.4 (GND), U4.2 (GND), U5.2 (GND), U6.4 (GND), U6.9 (GND), U7.1 (GND), U7.7 (GND), U8.4 (VSS), U9.4 (GND), U9.5 (GND2), U9.7 (AUX), U9.17 (EP), U10.7 (GND), U10.16 (ENn), U11.7 (GND), U11.16 (ENn), U12.7 (GND), U12.16 (ENn), U13.8 (GND), U13.12 (Gn), U14.8 (GND), U14.9 (3B), U14.10 (3A), U14.12 (Gn), U14.14 (4A), U14.15 (4B), Y1.2 (GND1), Y1.4 (GND2)
HELTEC_RST: J_MESH.7, J_STAMP.7
I2C0_ALERT: J_PWR.17, R_ALRT.1
I2C0_SCL: J_PWR.8, R_SCL0.1, U1.2 (GPIO5)
I2C0_SDA: J_PWR.7, R_SDA0.1, U1.1 (GPIO4)
I2C1_SCL: R_SCL1.1, U1.80 (GPIO3), U7.4 (SCK), U8.2 (SCL)
I2C1_SDA: R_SDA1.1, U1.79 (GPIO2), U7.3 (SDI), U8.1 (SDA)
I2S_SCK: R_I2S_SCK.2, U10.1 (DIN1), U10.8 (DIN3), U11.1 (DIN1), U11.8 (DIN3), U12.1 (DIN1), U12.8 (DIN3)
I2S_SCK_MCU: R_I2S_SCK.1, U1.7 (GPIO9)
I2S_SD1: U1.18 (GPIO18), U13.3 (1Y)
I2S_SD2: U1.17 (GPIO17), U13.5 (2Y)
I2S_SD3: U1.16 (GPIO16), U13.11 (3Y)
I2S_SD4: U1.12 (GPIO13), U13.13 (4Y)
I2S_SD5: U1.13 (GPIO14), U14.3 (1Y)
I2S_SD6: U1.14 (GPIO15), U14.5 (2Y)
I2S_WS: R_I2S_WS.2, U10.6 (DIN2), U10.13 (DIN4), U11.6 (DIN2), U11.13 (DIN4), U12.6 (DIN2), U12.13 (DIN4)
I2S_WS_MCU: R_I2S_WS.1, U1.6 (GPIO8)
LED1_DIN: J1.8 (LED), U1.21 (GPIO21)
LED2_DIN: J2.8 (LED), U1.20 (GPIO20)
LED3_DIN: J3.8 (LED), U1.19 (GPIO19)
LED4_DIN: J4.8 (LED), U1.8 (GPIO10)
LED5_DIN: J5.8 (LED), U1.9 (GPIO11)
LED6_DIN: J6.8 (LED), U1.11 (GPIO12)
MIC1_3V3: FB1.2, J1.7 (3V3)
MIC1_FB: F1.2, FB1.1
MIC2_3V3: FB2.2, J2.7 (3V3)
MIC2_FB: F2.2, FB2.1
MIC3_3V3: FB3.2, J3.7 (3V3)
MIC3_FB: F3.2, FB3.1
MIC4_3V3: FB4.2, J4.7 (3V3)
MIC4_FB: F4.2, FB4.1
MIC5_3V3: FB5.2, J5.7 (3V3)
MIC5_FB: F5.2, FB5.1
MIC6_3V3: FB6.2, J6.7 (3V3)
MIC6_FB: F6.2, FB6.1
PG_5V: J_PWR.14, U1.45 (GPIO36)
PIEZO_IN1: U1.3 (GPIO6), U6.6 (IN1)
PIEZO_IN2: U1.4 (GPIO7), U6.5 (IN2)
PIEZO_N: J11.2, J12.2, J13.2, J14.2, U6.3 (OUT2)
PIEZO_P: J11.1, J12.1, J13.1, J14.1, U6.2 (OUT1)
PSRAM_CE: U1.40 (GPIO32), U3.1 (CE)
PSRAM_SCLK: U1.44 (GPIO35), U3.6 (SCLK)
PSRAM_SI: U1.43 (GPIO34), U3.5 (SI)
PSRAM_SO: U1.42 (GPIO33), U3.2 (SO)
PT1000_RTN: J_PWR.15, R_PT2.2
QSPI_SCLK: U1.71 (QSPI_SCLK), U2.6 (CLK)
QSPI_SD0: U1.72 (QSPI_SD0), U2.5 (DI)
QSPI_SD1: U1.74 (QSPI_SD1), U2.2 (DO)
QSPI_SD2: U1.73 (QSPI_SD2), U2.3 (WP)
QSPI_SD3: U1.70 (QSPI_SD3), U2.7 (HOLD)
QSPI_SS: R_CS.1, SW_BOOT.1, U1.75 (QSPI_SS), U2.1 (CS)
RUN: R_RUN.1, SW_RST.1, U1.35 (RUN)
SCK1_N: FL1A.2, U10.2 (Y1n)
SCK1_NJ: DT1A.2 (A2), FL1A.3, J1.2 (SCK_N)
SCK1_P: FL1A.1, U10.3 (Y1p)
SCK1_PJ: DT1A.1 (A1), FL1A.4, J1.1 (SCK_P)
SCK2_N: FL2A.2, U10.9 (Y3n)
SCK2_NJ: DT2A.2 (A2), FL2A.3, J2.2 (SCK_N)
SCK2_P: FL2A.1, U10.10 (Y3p)
SCK2_PJ: DT2A.1 (A1), FL2A.4, J2.1 (SCK_P)
SCK3_N: FL3A.2, U11.2 (Y1n)
SCK3_NJ: DT3A.2 (A2), FL3A.3, J3.2 (SCK_N)
SCK3_P: FL3A.1, U11.3 (Y1p)
SCK3_PJ: DT3A.1 (A1), FL3A.4, J3.1 (SCK_P)
SCK4_N: FL4A.2, U11.9 (Y3n)
SCK4_NJ: DT4A.2 (A2), FL4A.3, J4.2 (SCK_N)
SCK4_P: FL4A.1, U11.10 (Y3p)
SCK4_PJ: DT4A.1 (A1), FL4A.4, J4.1 (SCK_P)
SCK5_N: FL5A.2, U12.2 (Y1n)
SCK5_NJ: DT5A.2 (A2), FL5A.3, J5.2 (SCK_N)
SCK5_P: FL5A.1, U12.3 (Y1p)
SCK5_PJ: DT5A.1 (A1), FL5A.4, J5.1 (SCK_P)
SCK6_N: FL6A.2, U12.9 (Y3n)
SCK6_NJ: DT6A.2 (A2), FL6A.3, J6.2 (SCK_N)
SCK6_P: FL6A.1, U12.10 (Y3p)
SCK6_PJ: DT6A.1 (A1), FL6A.4, J6.1 (SCK_P)
SD1_N: FL1C.2, R_SD1.2, U13.1 (1B)
SD1_NJ: DT1C.2 (A2), FL1C.3, J1.5 (SD_N)
SD1_P: FL1C.1, R_SD1.1, U13.2 (1A)
SD1_PJ: DT1C.1 (A1), FL1C.4, J1.4 (SD_P)
SD2_N: FL2C.2, R_SD2.2, U13.7 (2B)
SD2_NJ: DT2C.2 (A2), FL2C.3, J2.5 (SD_N)
SD2_P: FL2C.1, R_SD2.1, U13.6 (2A)
SD2_PJ: DT2C.1 (A1), FL2C.4, J2.4 (SD_P)
SD3_N: FL3C.2, R_SD3.2, U13.9 (3B)
SD3_NJ: DT3C.2 (A2), FL3C.3, J3.5 (SD_N)
SD3_P: FL3C.1, R_SD3.1, U13.10 (3A)
SD3_PJ: DT3C.1 (A1), FL3C.4, J3.4 (SD_P)
SD4_N: FL4C.2, R_SD4.2, U13.15 (4B)
SD4_NJ: DT4C.2 (A2), FL4C.3, J4.5 (SD_N)
SD4_P: FL4C.1, R_SD4.1, U13.14 (4A)
SD4_PJ: DT4C.1 (A1), FL4C.4, J4.4 (SD_P)
SD5_N: FL5C.2, R_SD5.2, U14.1 (1B)
SD5_NJ: DT5C.2 (A2), FL5C.3, J5.5 (SD_N)
SD5_P: FL5C.1, R_SD5.1, U14.2 (1A)
SD5_PJ: DT5C.1 (A1), FL5C.4, J5.4 (SD_P)
SD6_N: FL6C.2, R_SD6.2, U14.7 (2B)
SD6_NJ: DT6C.2 (A2), FL6C.3, J6.5 (SD_N)
SD6_P: FL6C.1, R_SD6.1, U14.6 (2A)
SD6_PJ: DT6C.1 (A1), FL6C.4, J6.4 (SD_P)
SHIELD: J_PWR.18, R_SH.1
SPI0_CS: U1.38 (GPIO30), U9.11 (CS)
SPI0_MISO: U1.26 (GPIO25), U9.13 (MISO)
SPI0_MOSI: U1.25 (GPIO24), U9.12 (MOSI)
SPI0_SCK: U1.23 (GPIO23), U9.14 (SCLK)
STATUS_DIN: D_STAT.4 (DIN), U1.46 (GPIO37)
SWCLK: J_SWD.1, U1.33 (SWCLK)
SWDIO: J_SWD.3, U1.34 (SWDIO)
UART_RX: D_RX.1 (A1), J_MESH.4, J_STAMP.4, R_RX.1
UART_RX_MCU: R_RX.2, U1.78 (GPIO1)
UART_TX: D_TX.1 (A1), J_MESH.3, J_STAMP.3, R_TX.2
UART_TX_MCU: R_TX.1, U1.77 (GPIO0)
USB_DM: U1.66 (USB_DM)
USB_DP: U1.67 (USB_DP)
VBUS: C_VBUS.1, D_USB.2 (A), J_USB.A4 (VBUS), J_USB.A9 (VBUS), J_USB.B4 (VBUS), J_USB.B9 (VBUS)
VREG_LX: L_VREG.1, U1.63 (VREG_LX)
WAKE_DSP: J_MESH.5, J_STAMP.5, R_WK.1, U4.3 (EN), U5.3 (EN)
WS1_N: FL1B.2, U10.5 (Y2n)
WS1_NJ: DT1B.2 (A2), FL1B.3, J1.6 (WS_N)
WS1_P: FL1B.1, U10.4 (Y2p)
WS1_PJ: DT1B.1 (A1), FL1B.4, J1.3 (WS_P)
WS2_N: FL2B.2, U10.12 (Y4n)
WS2_NJ: DT2B.2 (A2), FL2B.3, J2.6 (WS_N)
WS2_P: FL2B.1, U10.11 (Y4p)
WS2_PJ: DT2B.1 (A1), FL2B.4, J2.3 (WS_P)
WS3_N: FL3B.2, U11.5 (Y2n)
WS3_NJ: DT3B.2 (A2), FL3B.3, J3.6 (WS_N)
WS3_P: FL3B.1, U11.4 (Y2p)
WS3_PJ: DT3B.1 (A1), FL3B.4, J3.3 (WS_P)
WS4_N: FL4B.2, U11.12 (Y4n)
WS4_NJ: DT4B.2 (A2), FL4B.3, J4.6 (WS_N)
WS4_P: FL4B.1, U11.11 (Y4p)
WS4_PJ: DT4B.1 (A1), FL4B.4, J4.3 (WS_P)
WS5_N: FL5B.2, U12.5 (Y2n)
WS5_NJ: DT5B.2 (A2), FL5B.3, J5.6 (WS_N)
WS5_P: FL5B.1, U12.4 (Y2p)
WS5_PJ: DT5B.1 (A1), FL5B.4, J5.3 (WS_P)
WS6_N: FL6B.2, U12.12 (Y4n)
WS6_NJ: DT6B.2 (A2), FL6B.3, J6.6 (WS_N)
WS6_P: FL6B.1, U12.11 (Y4p)
WS6_PJ: DT6B.1 (A1), FL6B.4, J6.3 (WS_P)
XIN: C_X1.1, U1.30 (XIN), Y1.1 (XIN)
XOUT: C_X2.1, U1.31 (XOUT), Y1.3 (XOUT)

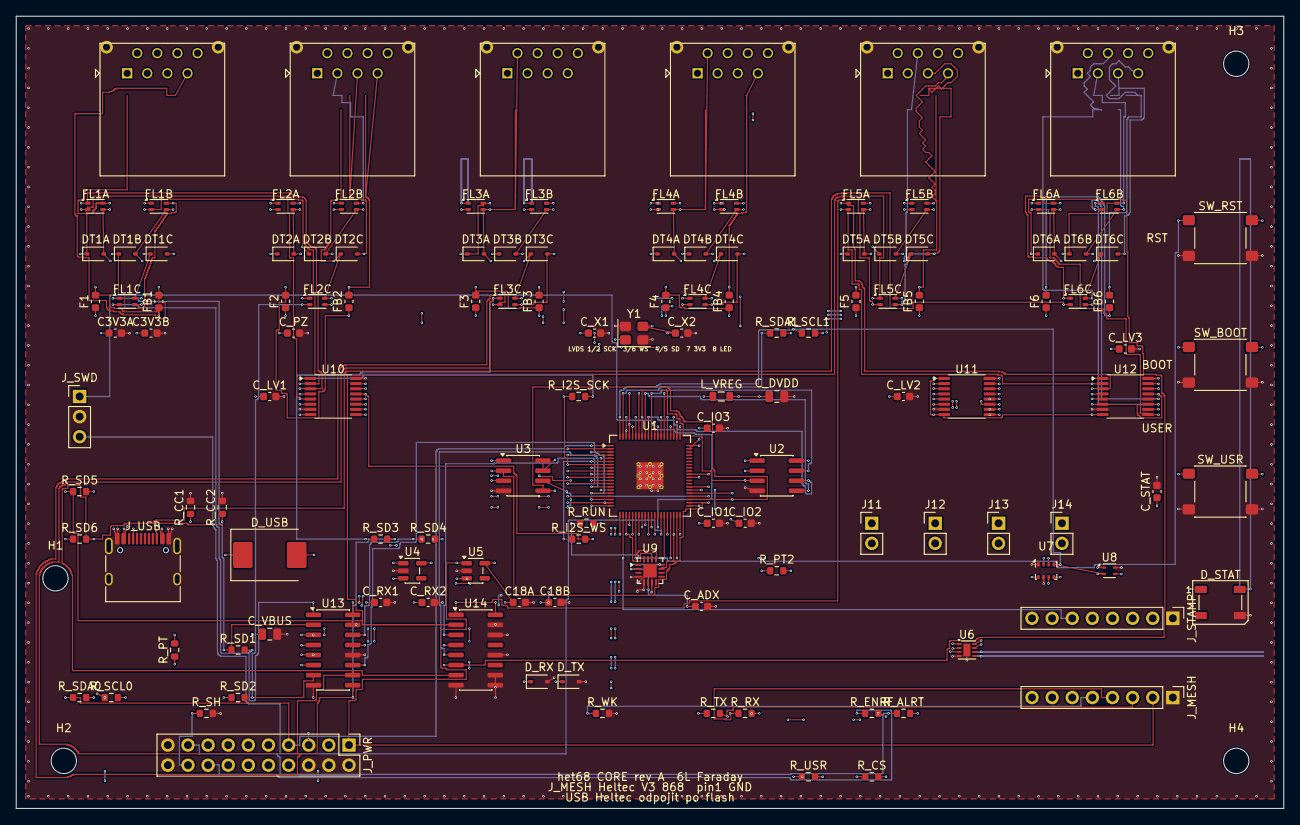
[picture p23: board het68-core.kicad_pcb from above]

Board: 6 copper layers, 160.0 x 100.0 mm, 134 parts (0 on the bottom side), 156 nets.

Other parts of the board:
H1, H2, H3, H4: M3; MountingHole_3.2mm_M3
