fedurca/het68_pcb/kicad/het68-sat/het68-sat.kicad_pcb

## KiCad design kicad/het68-sat/het68-sat.kicad_pcb (2026-10-31)

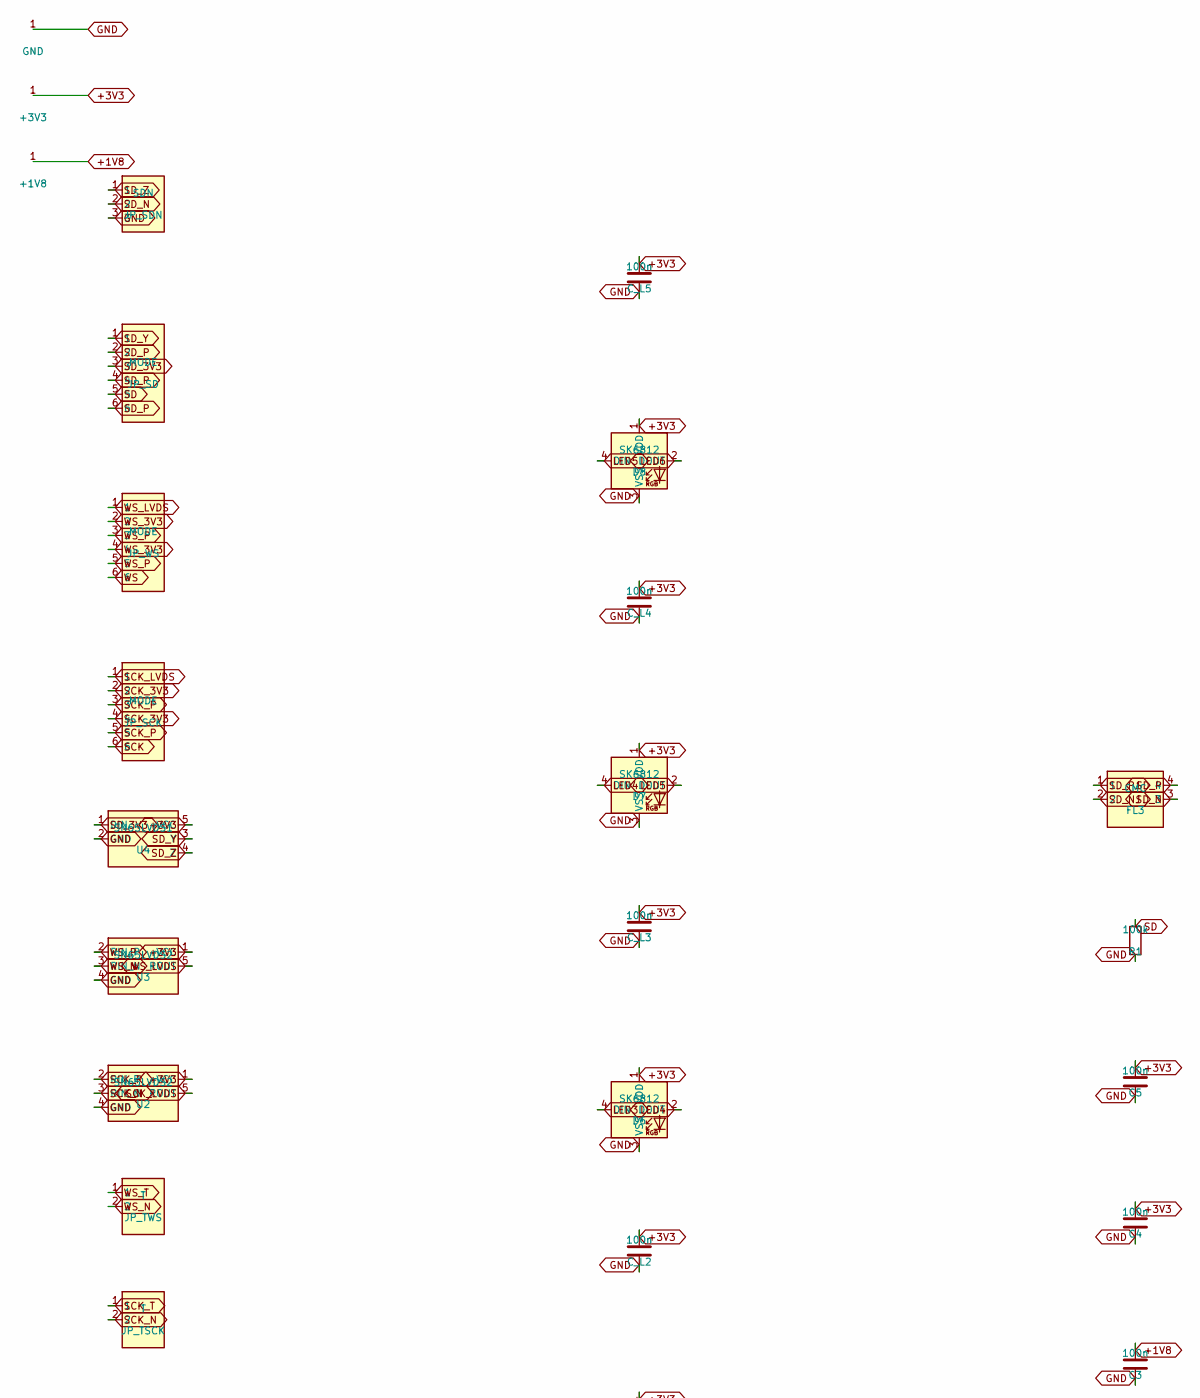
[picture p24: schematic het68-sat.kicad_sch, het68 satelit 6L — režim linky propojkou, part in row 1, column 1]

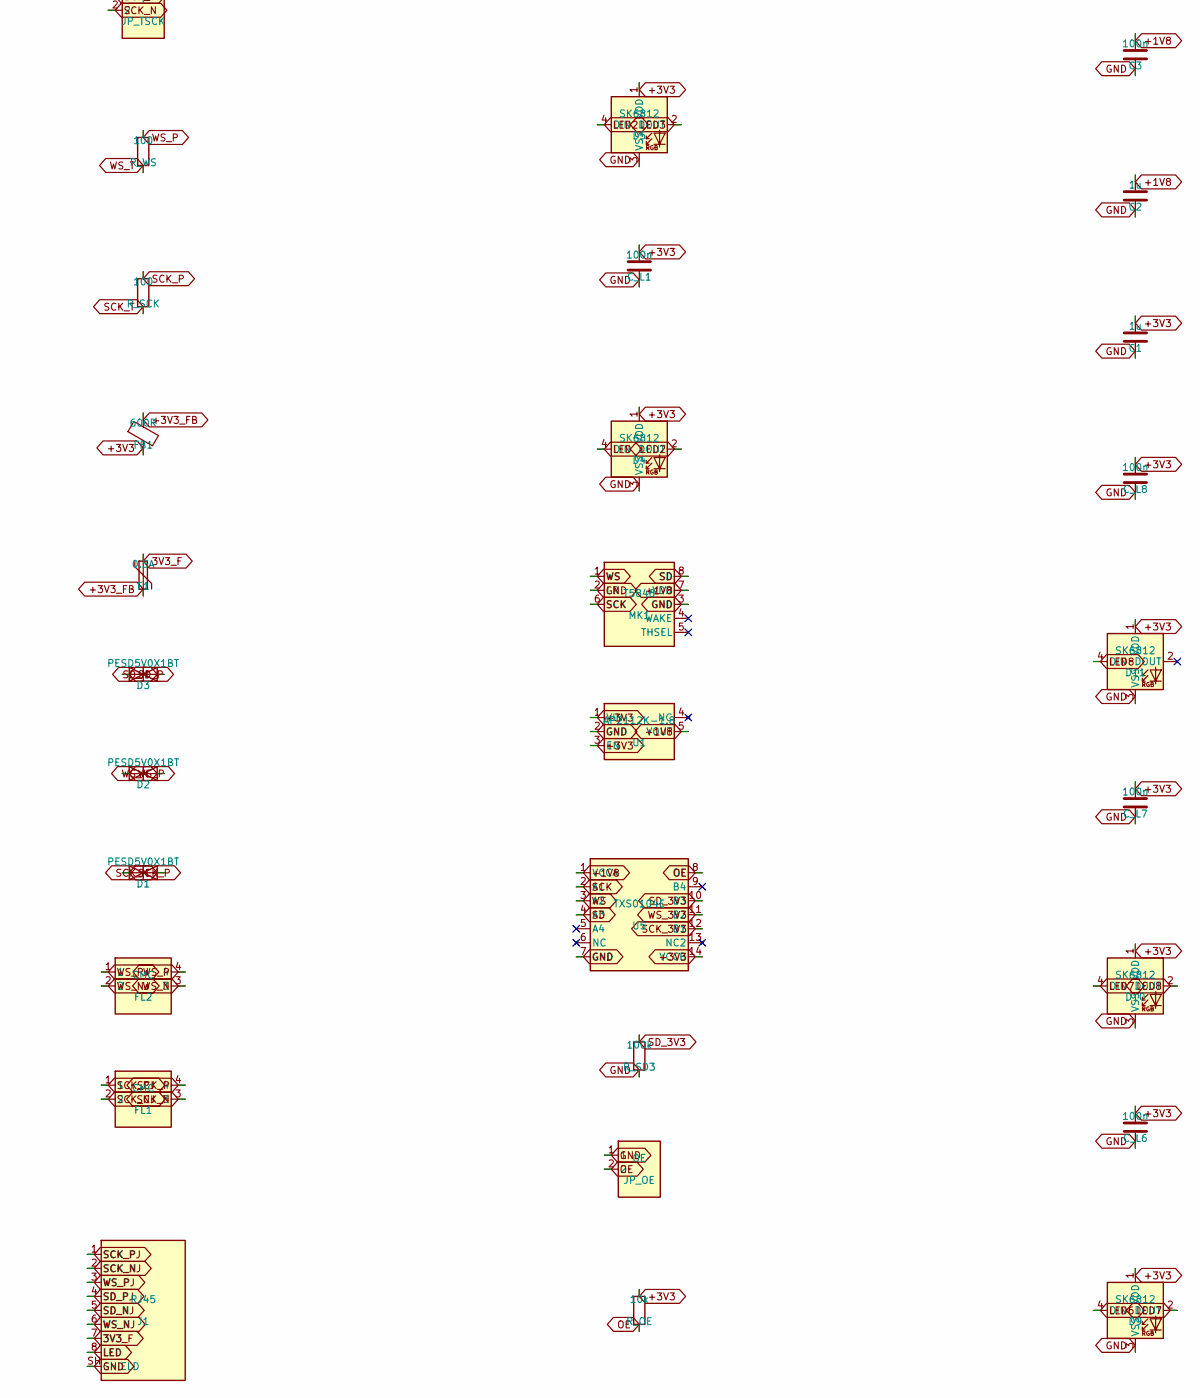
[picture p25: schematic het68-sat.kicad_sch, het68 satelit 6L — režim linky propojkou, part in row 2, column 1]

Parts:
C1, C2: 1u; C_0603_1608Metric; MPN CL10A105KA8NNNC
C3, C4, C5: 100n; C_0603_1608Metric; MPN CL10B104KB8NNNC
C_L1, C_L2, C_L3, C_L4, C_L5, C_L6, C_L7, C_L8: 100n; C_0603_1608Metric; MPN CL10B104KB8NNNC
D1, D2, D3: PESD5V0X1BT; D_SOD-323; MPN PESD5V0X1BT
D4, D5, D6, D7, D8, D9, D10, D11: SK6812; LED_WS2812B_PLCC4_5.0x5.0mm_P3.2mm; MPN SK6812 (5050, 3.3 V)
F1: 0.5A; Fuse_0603_1608Metric; MPN PPTC 0603
FB1: 600R; L_0603_1608Metric; MPN BLM18PG601SN1D
FL1, FL2, FL3: CMC; L_CommonModeChoke_Coilank_ACM2012; MPN ACM2012
J1: RJ45; RJ45_Vertical_het68; MPN RJ45-8P8C-VERT
JP_OE: OE; PinHeader_1x02_P2.54mm_Vertical; MPN jumper OE to GND = 1V8 mode
JP_SCK: MODE; PinHeader_2x03_P2.54mm_Vertical; MPN SCK radky DIFF / 3V3 / 1V8
JP_SD: MODE; PinHeader_2x03_P2.54mm_Vertical; MPN SD radky DIFF / 3V3 / 1V8
JP_SDN: SDN; PinHeader_1x03_P2.54mm_Vertical; MPN jumper SDN 1-2 DIFF 2-3 single-ended
JP_TSCK: T; PinHeader_1x02_P2.54mm_Vertical; MPN jumper DIFF term SCK
JP_TWS: T; PinHeader_1x02_P2.54mm_Vertical; MPN jumper DIFF term WS
JP_WS: MODE; PinHeader_2x03_P2.54mm_Vertical; MPN WS radky DIFF / 3V3 / 1V8
MK1: T5848; MPN MMICT5848-00-012
R1: 100k; R_0603_1608Metric; MPN RC0603FR-07100KL
R_OE: 10k; R_0603_1608Metric; MPN RC0603FR-0710KL
R_SCK: 100; R_0603_1608Metric; MPN RC0603FR-07100RL
R_SD3: 100k; R_0603_1608Metric; MPN RC0603FR-07100KL
R_WS: 100; R_0603_1608Metric; MPN RC0603FR-07100RL
U1: AP2112K-1.8; SOT-23-5; MPN AP2112K-1.8TRG1
U2, U3: SN65LVDS2; SOT-23-5; MPN SN65LVDS2DBVR
U4: SN65LVDS1; SOT-23-5; MPN SN65LVDS1DBVR
U5: TXS0104E; SOIC-14_3.9x8.7mm_P1.27mm; MPN TXS0104EDR

Connections:
3V3_F: F1.1, J1.7 (3V3)
+1V8: C2.1, C3.1, MK1.7 (VDD), U1.5 (VOUT), U5.1 (VCCA)
+3V3: C1.1, C4.1, C5.1, C_L1.1, C_L2.1, C_L3.1, C_L4.1, C_L5.1, C_L6.1, C_L7.1, C_L8.1, D4.1 (VDD), D5.1 (VDD), D6.1 (VDD), D7.1 (VDD), D8.1 (VDD), D9.1 (VDD), D10.1 (VDD), D11.1 (VDD), FB1.2, R_OE.1, U1.1 (VIN), U1.3 (EN), U2.1 (VCC), U3.1 (VCC), U4.5 (VCC), U5.14 (VCCB)
+3V3_FB: F1.2, FB1.1
GND: C1.2, C2.2, C3.2, C4.2, C5.2, C_L1.2, C_L2.2, C_L3.2, C_L4.2, C_L5.2, C_L6.2, C_L7.2, C_L8.2, D4.3 (VSS), D5.3 (VSS), D6.3 (VSS), D7.3 (VSS), D8.3 (VSS), D9.3 (VSS), D10.3 (VSS), D11.3 (VSS), J1.SH (SHIELD), JP_OE.1, JP_SDN.3, MK1.2 (LR), MK1.3 (GND), R1.2, R_SD3.2, U1.2 (GND), U2.4 (GND), U3.4 (GND), U4.2 (GND), U5.7 (GND)
LED: D4.4 (DIN), J1.8 (LED)
LED2: D4.2 (DOUT), D5.4 (DIN)
LED3: D5.2 (DOUT), D6.4 (DIN)
LED4: D6.2 (DOUT), D7.4 (DIN)
LED5: D7.2 (DOUT), D8.4 (DIN)
LED6: D8.2 (DOUT), D9.4 (DIN)
LED7: D9.2 (DOUT), D10.4 (DIN)
LED8: D10.2 (DOUT), D11.4 (DIN)
OE: JP_OE.2, R_OE.2, U5.8 (OE)
SCK: JP_SCK.6, MK1.6 (SCK), U5.2 (A1)
SCK_3V3: JP_SCK.2, JP_SCK.4, U5.12 (B1)
SCK_LVDS: JP_SCK.1, U2.5 (ROUT)
SCK_N: D1.2 (A2), FL1.3, JP_TSCK.2, U2.3 (RIN_N)
SCK_NJ: FL1.2, J1.2 (SCK_N)
SCK_P: D1.1 (A1), FL1.4, JP_SCK.3, JP_SCK.5, R_SCK.1, U2.2 (RIN_P)
SCK_PJ: FL1.1, J1.1 (SCK_P)
SCK_T: JP_TSCK.1, R_SCK.2
SD: JP_SD.5, MK1.8 (SD), R1.1, U5.4 (A3)
SD_3V3: JP_SD.3, R_SD3.1, U4.1 (DIN), U5.10 (B3)
SD_N: D3.2 (A2), FL3.3, JP_SDN.2
SD_NJ: FL3.2, J1.5 (SD_N)
SD_P: D3.1 (A1), FL3.4, JP_SD.2, JP_SD.4, JP_SD.6
SD_PJ: FL3.1, J1.4 (SD_P)
SD_Y: JP_SD.1, U4.3 (Y)
SD_Z: JP_SDN.1, U4.4 (Z)
WS: JP_WS.6, MK1.1 (WS), U5.3 (A2)
WS_3V3: JP_WS.2, JP_WS.4, U5.11 (B2)
WS_LVDS: JP_WS.1, U3.5 (ROUT)
WS_N: D2.2 (A2), FL2.3, JP_TWS.2, U3.3 (RIN_N)
WS_NJ: FL2.2, J1.6 (WS_N)
WS_P: D2.1 (A1), FL2.4, JP_WS.3, JP_WS.5, R_WS.1, U3.2 (RIN_P)
WS_PJ: FL2.1, J1.3 (WS_P)
WS_T: JP_TWS.1, R_WS.2

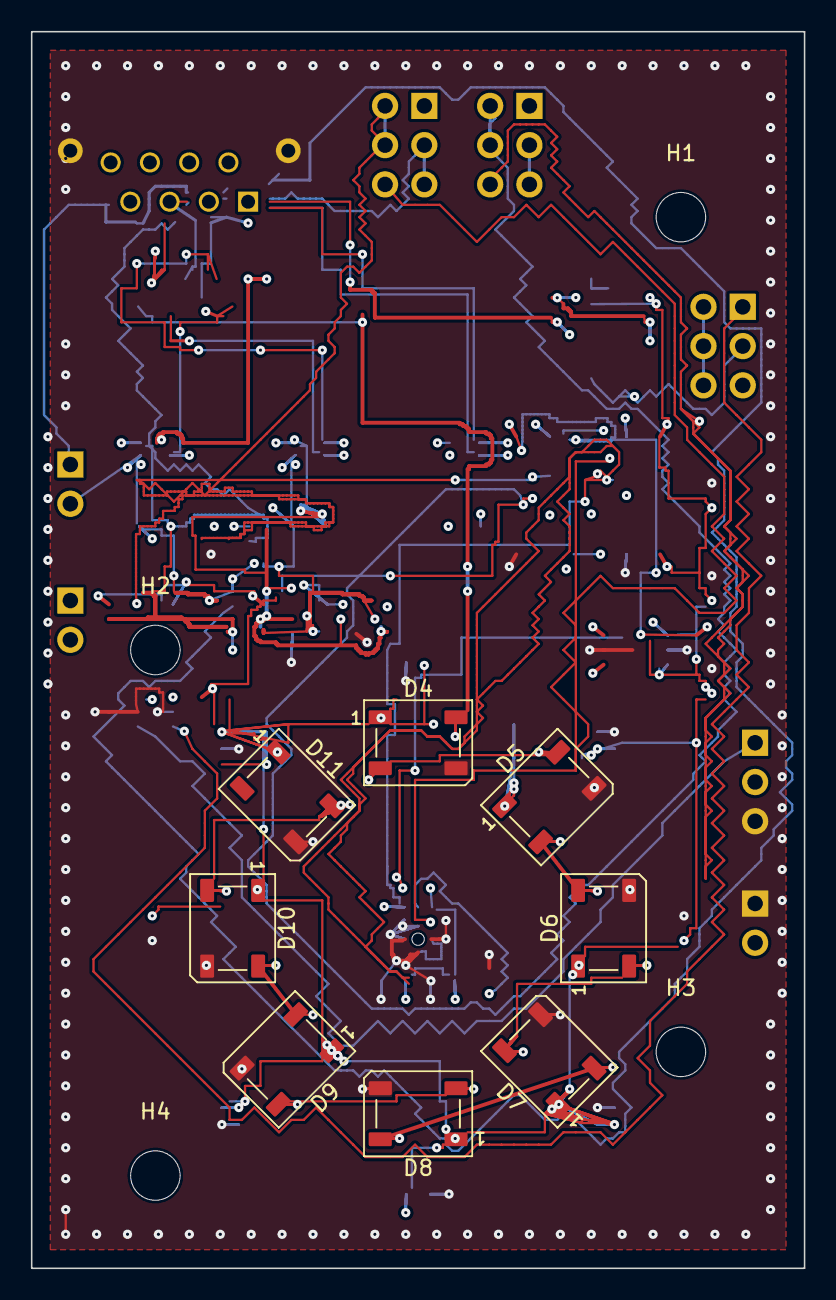
[picture p26: board het68-sat.kicad_pcb from above]

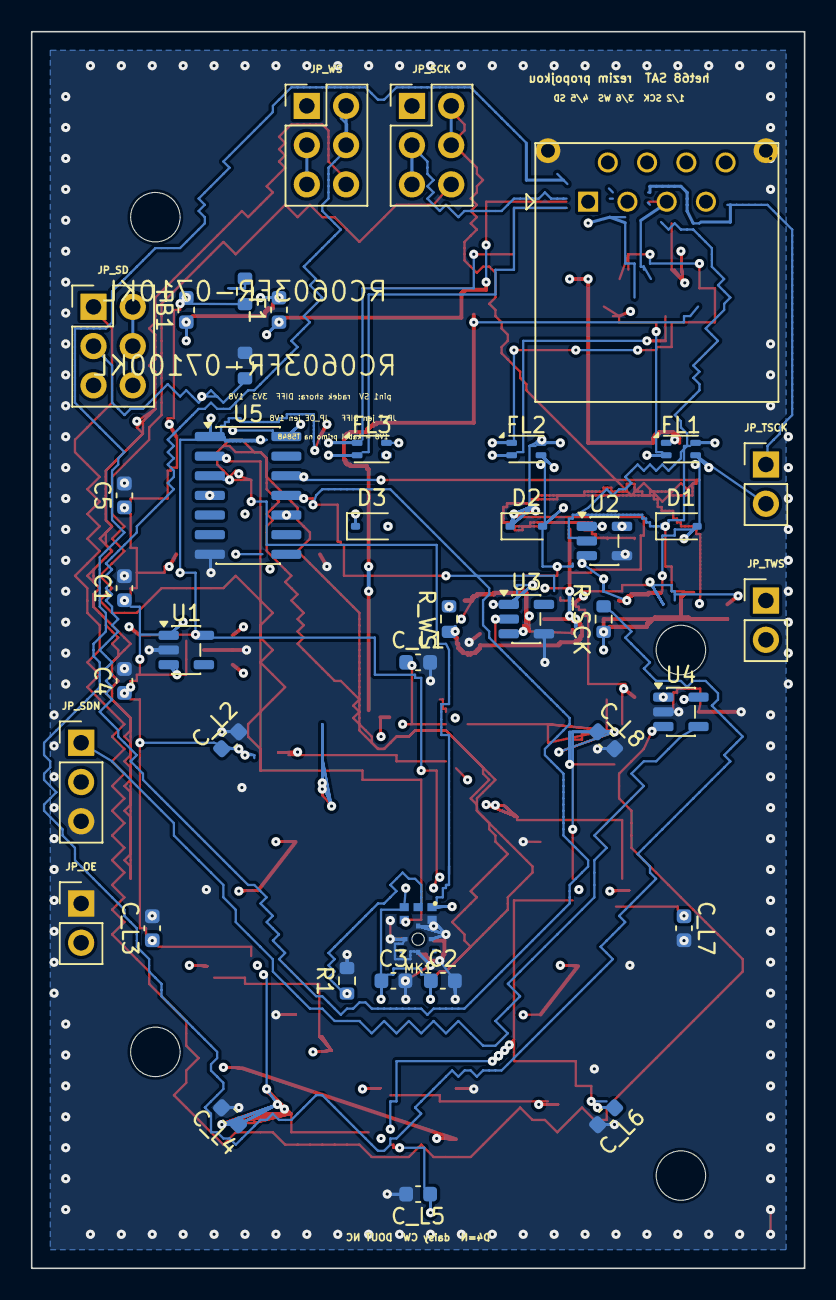
[picture p27: board het68-sat.kicad_pcb from below]

Board: 6 copper layers, 50.0 x 80.0 mm, 52 parts (40 on the bottom side), 38 nets.

Other parts of the board:
H1, H2, H3, H4: M3; MountingHole_3.2mm_M3
