fedurca/het68_pcb/kicad/het68-pwr-vvn/het68-pwr-vvn.kicad_pcb

## KiCad design kicad/het68-pwr-vvn/het68-pwr-vvn.kicad_pcb (2026-10-29)

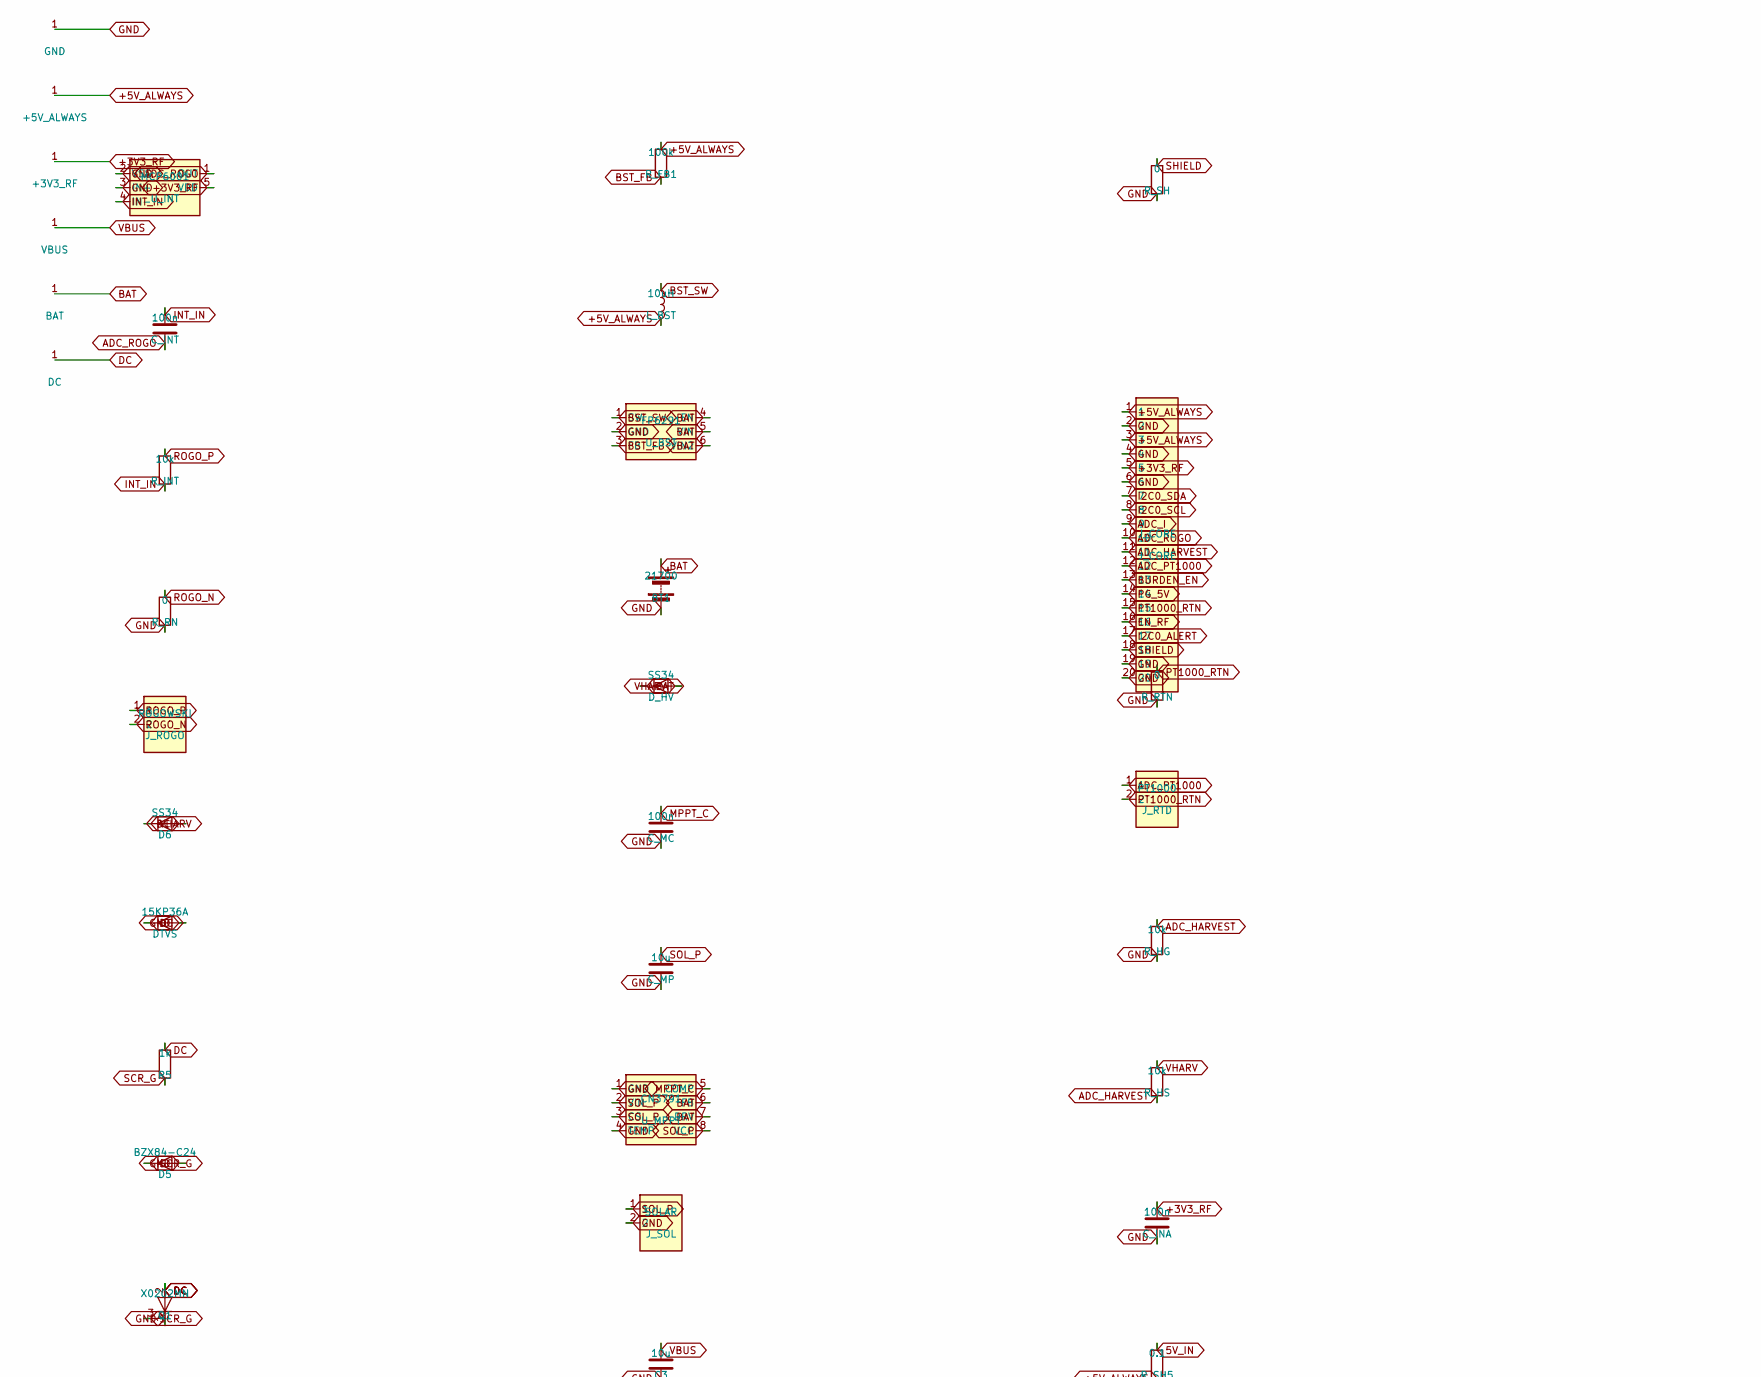
[picture p28: schematic het68-pwr-vvn.kicad_sch, het68 silova VVN Rogowski, part in row 1, column 1]

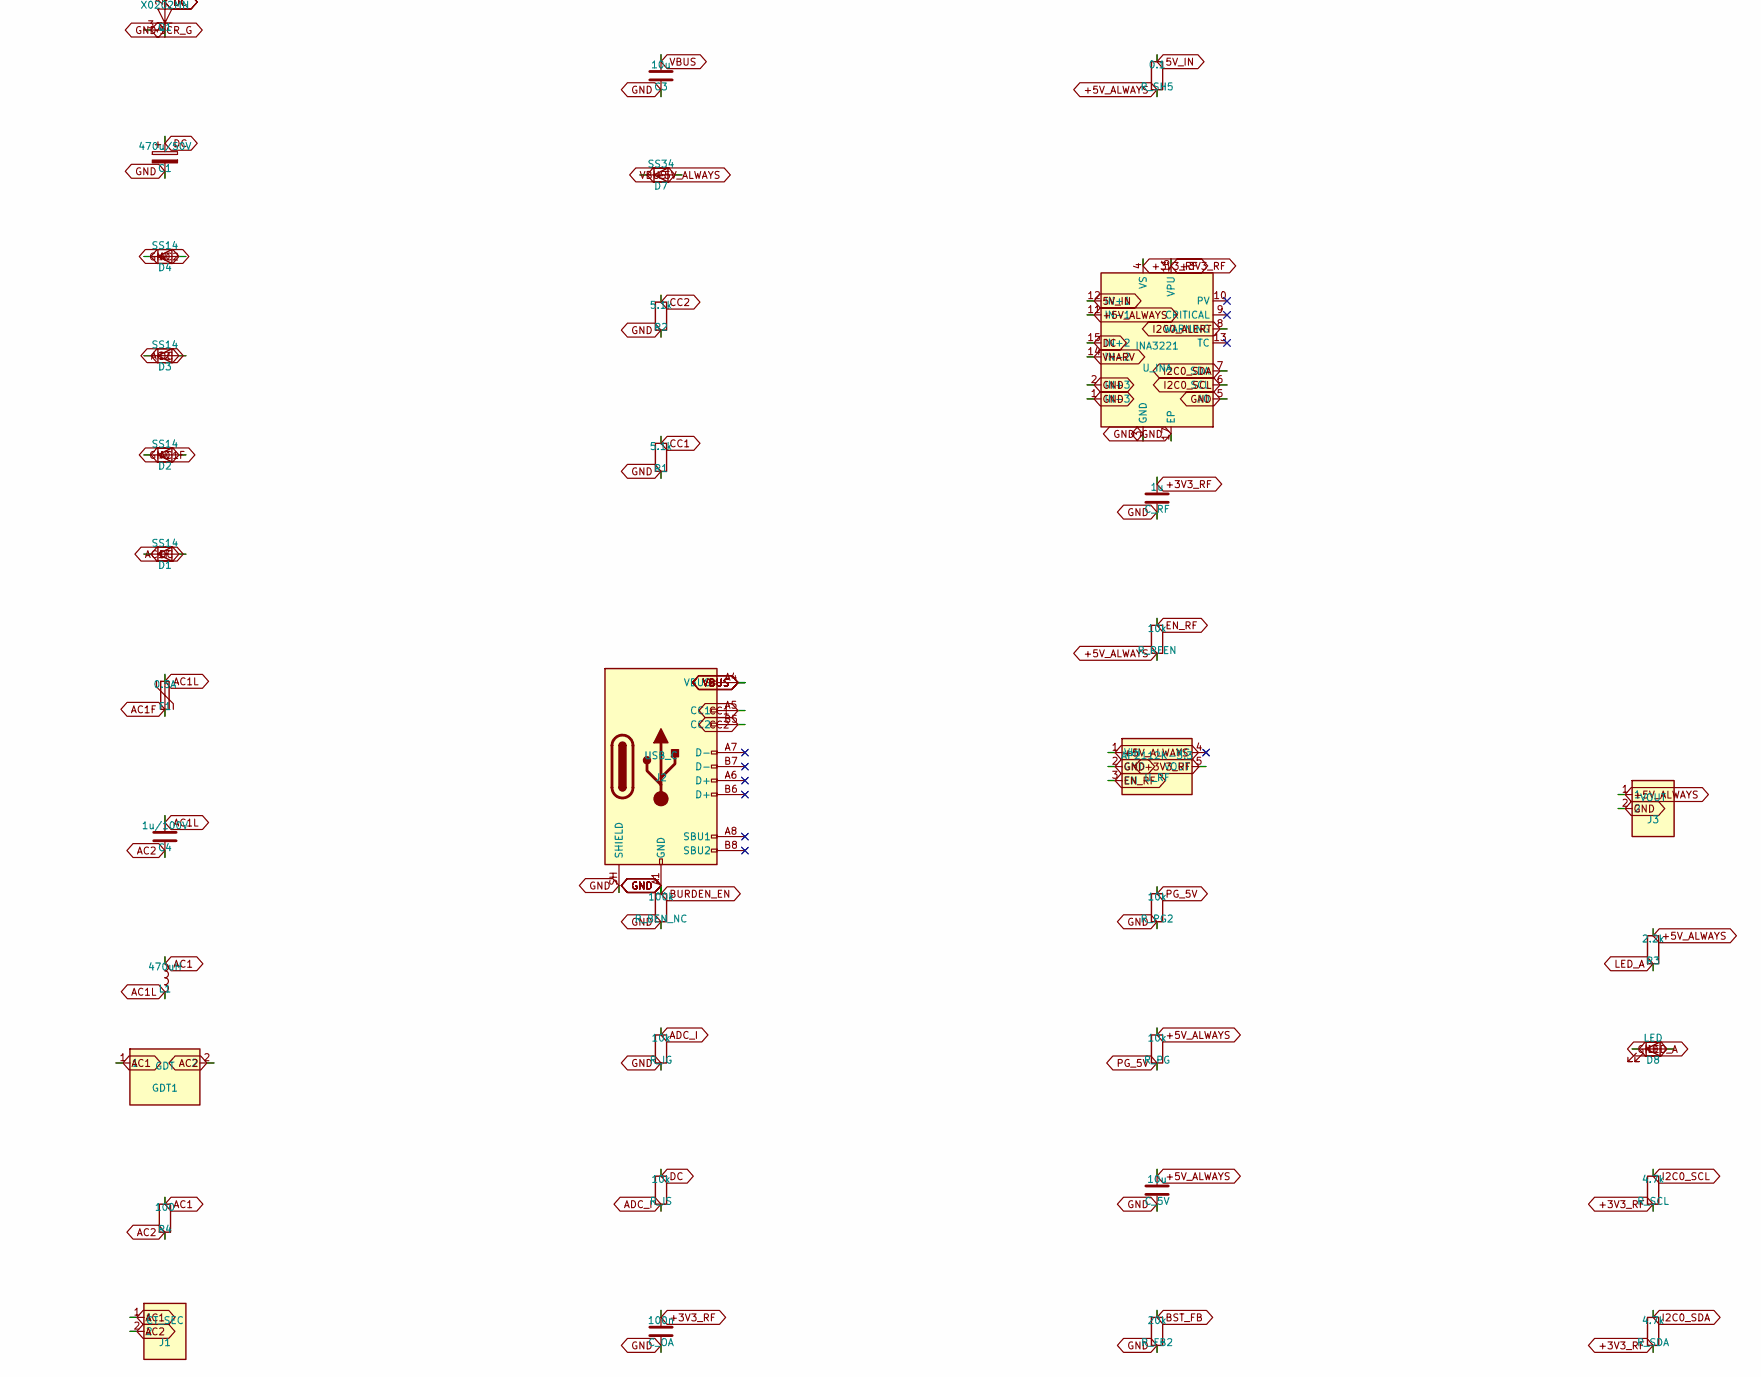
[picture p29: schematic het68-pwr-vvn.kicad_sch, het68 silova VVN Rogowski, part in row 2, column 1]

Parts:
BT1: 21700; Keystone_1122_21700; MPN Keystone 1122
C1: 470u/50V; CP_Radial_D10.0mm_P5.00mm; MPN electrolytic 470u 50V
C3: 10u; C_0805_2012Metric; MPN CL21A106KOQNNNE
C4: 1u/100V; C_1206_3216Metric; MPN 1uF 100V X7R LC
C_5V: 10u; C_0805_2012Metric; MPN CL21A106KOQNNNE
C_INA: 100n; C_0603_1608Metric; MPN CL10B104KB8NNNC
C_INT: 100n; C_0603_1608Metric; MPN CL10B104KB8NNNC
C_MC: 100n; C_0603_1608Metric; MPN CL10B104KB8NNNC
C_MP: 10u; C_0805_2012Metric; MPN CL21A106KOQNNNE
C_OA: 100n; C_0603_1608Metric; MPN CL10B104KB8NNNC
C_RF: 1u; C_0603_1608Metric; MPN CL10A105KA8NNNC
D1, D2, D3, D4: SS14; D_SMA; MPN SS14
D5: BZX84-C24; D_SOD-323; MPN BZX84-C24
D6, D7: SS34; D_SMC; MPN SS34
D8: LED; LED_0603_1608Metric; MPN LED 0603
DTVS: 15KP36A; D_DO-201_P15.24mm_Horizontal; MPN 15KP36A
D_HV: SS34; D_SMC; MPN SS34
F1: 0.5A; Fuse_1812_4532Metric; MPN polyfuse 1812 0.5 A
GDT1: GDT; Fuse_1812_4532Metric; MPN GDT secondary
J1: CT_SEC; PinHeader_1x02_P2.54mm_Vertical; MPN sekundar CT, NE sit
J2: USB_C; USB_C_Receptacle_HRO_TYPE-C-31-M-12; MPN TYPE-C-31-M-12
J3: VOUT; PinHeader_1x02_P2.54mm_Vertical; MPN 5V lab
J_CORE: J_CORE; PinHeader_2x10_P2.54mm_Vertical; MPN interconnect 2x10
J_ROGO: ROGOWSKI; PinHeader_1x02_P2.54mm_Vertical; MPN Rogowski secondary, NE sit
J_RTD: PT1000; PinHeader_1x02_P2.54mm_Vertical; MPN PT1000 on conductor
J_SOL: SOLAR; PinHeader_1x02_P2.54mm_Vertical; MPN panel Voc 6-18 V
L1: 470uH; L_Radial_D10.0mm_P5.00mm_Fastron_07P; MPN 470uH radial
L_BST: 10uH; L_0805_2012Metric; MPN 10uH boost
Q1: X0202MN; SOT-223; MPN X0202MN
R1, R2: 5.1k; R_0603_1608Metric; MPN RC0603FR-075K1L
R3: 2.2k; R_0603_1608Metric; MPN RC0603FR-072K2L
R4: 100; R_Axial_DIN0207_L6.3mm_D2.5mm_P10.16mm_Horizontal; MPN 100R THT burden
R5: 1k; R_0805_2012Metric; MPN RC0805FR-071KL
R_BEN_NC: 100k; R_0603_1608Metric; MPN RC0603FR-07100KL
R_FB1: 100k; R_0603_1608Metric; MPN RC0603FR-07100KL
R_FB2: 20k; R_0603_1608Metric; MPN RC0603FR-0720KL
R_HG: 10k; R_0603_1608Metric; MPN RC0603FR-0710KL
R_HS: 10k; R_0603_1608Metric; MPN RC0603FR-0710KL
R_IG: 10k; R_0603_1608Metric; MPN RC0603FR-0710KL
R_INT: 10k; R_0603_1608Metric; MPN RC0603FR-0710KL
R_IS: 10k; R_0603_1608Metric; MPN RC0603FR-0710KL
R_PG, R_PG2: 10k; R_0603_1608Metric; MPN RC0603FR-0710KL
R_RFEN: 10k; R_0603_1608Metric; MPN RC0603FR-0710KL
R_RN: 0; R_0603_1608Metric; MPN RC0603FR-070RL
R_RTN: 0; R_0603_1608Metric; MPN RC0603FR-070RL
R_SCL: 4.7k; R_0603_1608Metric; MPN RC0603FR-074K7L
R_SDA: 4.7k; R_0603_1608Metric; MPN RC0603FR-074K7L
R_SH: 0; R_0603_1608Metric; MPN RC0603FR-070RL
R_SH5: 0.1; R_0805_2012Metric; MPN RC0805FR-070R1L
U_BST: FP6291; SOT-23-6; MPN FP6291
U_INA: INA3221; Texas_RGV0016A_VQFN-16-1EP_4x4mm_P0.65mm_EP2.1x2.1mm; MPN INA3221AIRGVR
U_INT: MCP6001; SOT-23-5; MPN MCP6001T-OT
U_MPPT: CN3791; SOIC-8_3.9x4.9mm_P1.27mm; MPN CN3791
U_RF: AP2112K-3.3; SOT-23-5; MPN AP2112K-3.3TRG1

Connections:
5V_IN: R_SH5.1, U_INA.12 (IN+1)
+3V3_RF: C_INA.1, C_OA.1, C_RF.1, J_CORE.5, R_SCL.2, R_SDA.2, U_INA.4 (VS), U_INA.16 (VPU), U_INT.5 (VDD), U_RF.5 (VOUT)
+5V_ALWAYS: C_5V.1, D7.1 (K), J3.1, J_CORE.1, J_CORE.3, L_BST.2, R3.1, R_FB1.1, R_PG.1, R_RFEN.2, R_SH5.2, U_INA.11 (IN-1), U_RF.1 (VIN)
AC1: GDT1.1, J1.1, L1.1, R4.1
AC1F: D1.2 (A), D2.1 (K), F1.2
AC1L: C4.1, F1.1, L1.2
AC2: C4.2, D3.2 (A), D4.1 (K), GDT1.2, J1.2, R4.2
ADC_HARVEST: J_CORE.11, R_HG.1, R_HS.2
ADC_I: J_CORE.9, R_IG.1, R_IS.2
ADC_PT1000: J_CORE.12, J_RTD.1
ADC_ROGO: C_INT.2, J_CORE.10, U_INT.1 (OUT)
BAT: BT1.1 (+), D_HV.1 (K), U_BST.4 (EN), U_BST.5 (VIN), U_BST.6 (VIN2), U_MPPT.6 (FB), U_MPPT.7 (DRV)
BST_FB: R_FB1.2, R_FB2.1, U_BST.3 (FB)
BST_SW: L_BST.1, U_BST.1 (SW)
BURDEN_EN: J_CORE.13, R_BEN_NC.1
CC1: J2.A5 (CC1), R1.1
CC2: J2.B5 (CC2), R2.1
DC: C1.1, D1.1 (K), D3.1 (K), D6.2 (A), DTVS.1 (K), Q1.2 (A), Q1.4 (A), R5.1, R_IS.1, U_INA.15 (IN+2)
EN_RF: J_CORE.16, R_RFEN.1, U_RF.3 (EN)
GND: BT1.2 (-), C1.2, C3.2, C_5V.2, C_INA.2, C_MC.2, C_MP.2, C_OA.2, C_RF.2, D2.2 (A), D4.2 (A), D5.2 (A), D8.2 (A), DTVS.2 (A), J2.A1 (GND), J2.A12 (GND), J2.B1 (GND), J2.B12 (GND), J2.SH (SHIELD), J3.2, J_CORE.2, J_CORE.4, J_CORE.6, J_CORE.19, J_CORE.20, J_SOL.2, Q1.1 (K), R1.2, R2.2, R_BEN_NC.2, R_FB2.2, R_HG.2, R_IG.2, R_PG2.2, R_RN.2, R_RTN.2, R_SH.2, U_BST.2 (GND), U_INA.1 (IN-3), U_INA.2 (IN+3), U_INA.3 (GND), U_INA.5 (A0), U_INA.17 (EP), U_INT.2 (VSS), U_INT.3 (IN+), U_MPPT.1 (GND), U_MPPT.4 (TEMP), U_RF.2 (GND)
I2C0_ALERT: J_CORE.17, U_INA.8 (WARNING)
I2C0_SCL: J_CORE.8, R_SCL.1, U_INA.6 (SCL)
I2C0_SDA: J_CORE.7, R_SDA.1, U_INA.7 (SDA)
INT_IN: C_INT.1, R_INT.2, U_INT.4 (IN-)
LED_A: D8.1 (K), R3.2
MPPT_C: C_MC.1, U_MPPT.5 (COMP)
PG_5V: J_CORE.14, R_PG.2, R_PG2.1
PT1000_RTN: J_CORE.15, J_RTD.2, R_RTN.1
ROGO_N: J_ROGO.2, R_RN.1
ROGO_P: J_ROGO.1, R_INT.1
SCR_G: D5.1 (K), Q1.3 (G), R5.2
SHIELD: J_CORE.18, R_SH.1
SOL_P: C_MP.1, J_SOL.1, U_MPPT.2 (VIN), U_MPPT.3 (CS), U_MPPT.8 (VCC)
VBUS: C3.1, D7.2 (A), J2.A4 (VBUS), J2.A9 (VBUS), J2.B4 (VBUS), J2.B9 (VBUS)
VHARV: D6.1 (K), D_HV.2 (A), R_HS.1, U_INA.14 (IN-2)

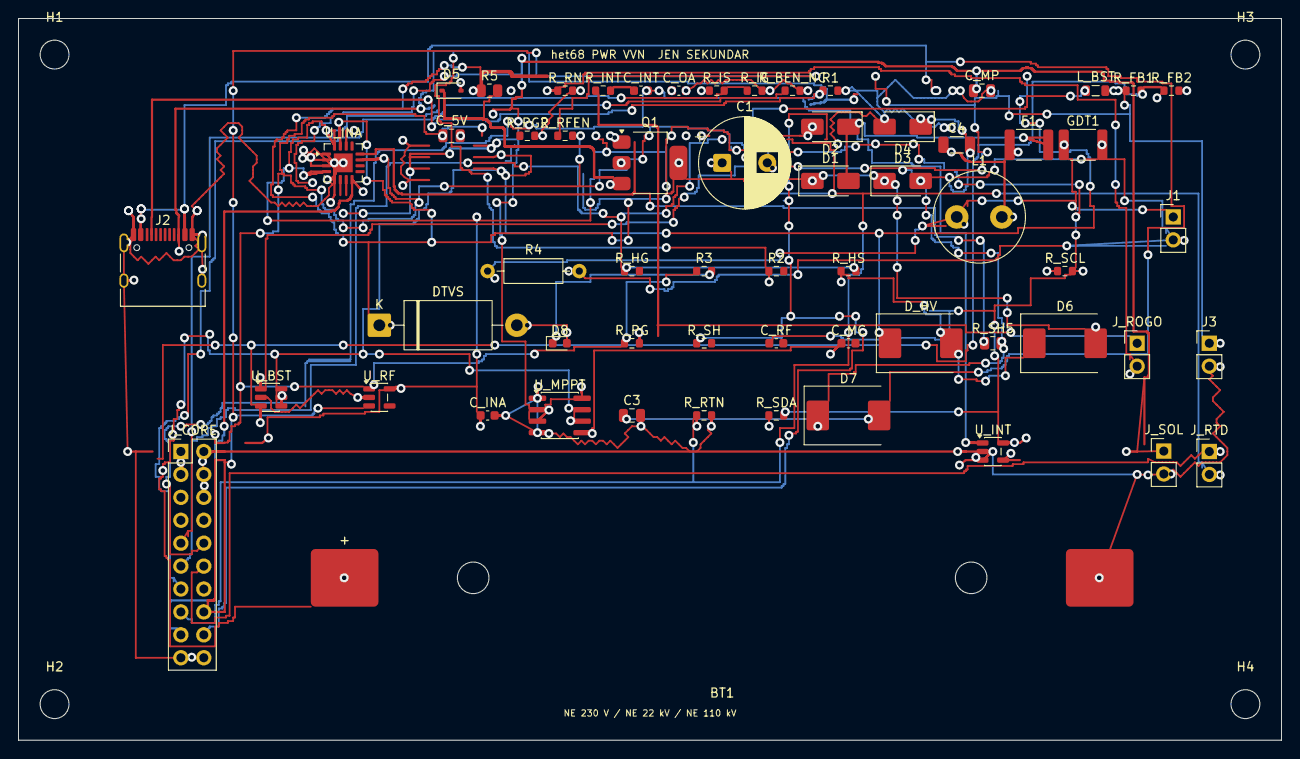
[picture p30: board het68-pwr-vvn.kicad_pcb from above]

Board: 2 copper layers, 140.0 x 80.0 mm, 64 parts (0 on the bottom side), 35 nets.

Other parts of the board:
H1, H2, H3, H4: M3; MountingHole_3.2mm_M3
