fedurca/het68_pcb/(commit log)

2026-10-28 Add PCB design brief v1.1.1
    Public specification for het68 hardware. Git history starts here.
    [PINOUT.csv]
2026-10-28 Freeze 6× RJ45: one UTP per mic plus RGB LED.
    Each satellite gets its own 8P8C (T568B) carrying I²S and WS2812/SK6812 DIN. The I/O board grows beyond the Pico 53×21 mm outline; SX126 on variant B moves to extra RP2350B GPIOs.
    [PINOUT.csv]
2026-10-28 Freeze Pico Plus 2 HAT: shifters, 4× piezo, env+PM I2C.
    Drop custom SoM/SX126 from this revision. The HAT carries 6× RJ45 with level shifting, a hardware H-bridge for four paralleled piezos, six LED_DIN lines, and I2C for INA power monitoring plus P/T/RH.
    [PINOUT.csv]
2026-10-28 Add KiCad rev A as v1.4.0 with board previews.
    The README now shows the bare PCB artwork and the assembled boards for the HAT, microphone satellite, and power supply.
    [bom.csv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]
2026-10-28 Drop the KiCad lock file from the board project.
2026-10-28 Ignore KiCad lock files.
2026-10-28 Switch the boards to two layers and specify the power sources.
    The HAT is no longer four-layer and the gerbers match that stackup. The power board now names the clamp CT, solar MPPT, 21700 cell and 5 V output; those charger parts are not drawn in KiCad yet.
    [BOM_ZDROJE.csv, bom.csv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]
2026-10-28 Reroute the two-layer boards and show the whole assembly.
    The satellite now passes DRC, the power board no longer shorts, and the HAT parts sit beside the Pico instead of on it. Previews include the clamp on one mains conductor, the panel, the 21700 cell and the linked boards.
    [het68-hat-B_Cu.gbl, het68-hat-B_Mask.gbs, het68-hat-B_Paste.gbp, het68-hat-B_Silkscreen.gbo, het68-hat-Edge_Cuts.gm1, het68-hat-F_Cu.gtl, het68-hat-F_Mask.gts, het68-hat-F_Paste.gtp]
2026-10-28 Clear the remaining copper violations and add the order BOM.
    HAT no longer reports shorts or clearance errors, and the power-board CC pins are connected. The order list now carries verified LCSC codes plus the power sources that are not drawn on the sheet yet.
    [BOM.csv, bom.csv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]
2026-10-28 Document the open prototype gaps and the cost of a build.
    The README now leads with the three boards, what still blocks fabrication, and whether LED data should stay on the acoustic board. The order BOM adds the shielded jack and a quantity cost estimate.
    [BOM.csv, bom.csv]
2026-10-28 Shrink the acoustic board and ground the cable shield only at the HAT.
    The HAT outline is 94 by 96 mm and the satellite shell pin is open. The README drops the power-board LED note and estimates a self-built Pico Plus 2 W against the bought module.
    [BOM.csv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]
2026-10-28 Protect the CT secondary and ship clean power and satellite fab files.
    Add burden, LC filter and crowbar on the power board, close DRC on power and satellite, and refresh the board previews for v1.10.0.
    [BOM.csv, BOM_ZDROJE.csv, bom.csv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]
2026-10-28 Ship a four-layer HAT that is fully routed and ready to fab.
    GPIO for SD and LED move to the jack rows so firmware can follow PINOUT.csv; power and satellite boards stay as in v1.10.0.
    [BOM.csv, PINOUT.csv, bom.csv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]
2026-10-29 Fit every board on printed.cz prototype: 2-layer, 0603, ENIG.
    HAT is 140×140 mm so it routes on two layers without 0402 or BGA; satellite and power use the same stack, drill and finish.
    [BOM.csv, BOM_ZDROJE.csv, bom.csv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]
2026-10-29 Freeze v4 as a native RP2350B 6-layer core with a swappable CT-secondary power board.
    MeshCore stays on Heltec V3 via J_MESH so the node remains in the mesh while DSP sleeps; satellites move to LVDS, and mains voltage never lands on copper.
    [BOM_v4.csv, PINOUT.csv, PINOUT_HAT_v3.csv, PINOUT_SAT_v4.csv, bom.csv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]
2026-10-29 Give the satellite the same 6-layer Faraday stack as Core and an 8-LED ring.
    Mic data sat→Core already uses SN65LVDS1 into SN65LVDS32; SCK/WS stay LVDS the other way.
    [BOM_v4.csv, PINOUT_SAT_v4.csv, bom.csv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]
2026-10-29 Ship v4.1.0 as a Core+satellite+power kit without the v3 HAT.
    LVDS now has 100 ohm receivers, SD common-mode chokes, and 3V3 ferrites for a noisy line; the kit BOM and 3D previews match that schematic.
    [BOM.csv, BOM_KIT.csv, BOM_ZDROJE.csv, BOM_v4.csv, PINOUT.csv, PINOUT_HAT_v3.csv, PINOUT_SAT_v4.csv, bom.csv]
2026-10-29 Add a Core status LED and three buttons, and fit a 21700 holder.
    RESET, BOOT and USER sit on the east edge with one SK6812; the power board uses a Keystone 1122 instead of an 18650 sled. Masks, schematics and JLCPCB gerber zips are in the tree.
    [BOM_KIT.csv, BOM_v4.csv, PINOUT.csv, bom.csv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]
2026-10-29 Route signal copper on the five v4 boards and drop tracks that still short.
    Core and the satellite have no copper shorts left. QFN-80 fanout and a few LVDS pairs stay open, and the power boards still have overlapping pads from placement.
    [het68-core-B_Cu.gbl, het68-core-B_Mask.gbs, het68-core-B_Paste.gbp, het68-core-B_Silkscreen.gbo, het68-core-Edge_Cuts.gm1, het68-core-F_Cu.gtl, het68-core-F_Mask.gts, het68-core-F_Paste.gtp]
2026-10-29 Fan out the RP2350B and finish the signal bridges that can leave the package.
    Each QFN pin gets a 0.15 mm escape along its axis. The crystal moves off the north row so that corridor exists. Core and the satellite have no new shorts; a few center-row pins and some LVDS nets are still open.
    [het68-core-B_Cu.gbl, het68-core-B_Mask.gbs, het68-core-B_Paste.gbp, het68-core-B_Silkscreen.gbo, het68-core-Edge_Cuts.gm1, het68-core-F_Cu.gtl, het68-core-F_Mask.gts, het68-core-F_Paste.gtp]
2026-10-29 Put the satellite electronics on the back and clear the power-board pad shorts.
    The outward face keeps only the microphone hole and the eight SK6812s. The DO-201 and the two regulators move off the header so the power boards no longer short pad to pad. Some LVDS, QSPI and GPIO nets are still open.
    [het68-core-B_Cu.gbl, het68-core-B_Mask.gbs, het68-core-B_Paste.gbp, het68-core-B_Silkscreen.gbo, het68-core-Edge_Cuts.gm1, het68-core-F_Cu.gtl, het68-core-F_Mask.gts, het68-core-F_Paste.gtp]
2026-10-29 Point the README at freshly rendered v4.5 previews.
    GitHub keeps the old image for an unchanged path. The assembly diagram also still said v4.1.0.
2026-10-29 Record the JLCPCB order settings for each board.
    Core and the satellite stay 6-layer ENIG with 0.2 mm drills and tented vias. The power boards are a separate 2-layer, 2 oz order.
2026-10-29 Ship the furthest routed v4 boards with matching previews.
    The satellite signal nets are closed, the five boards have no shorts, and the gerbers and renders follow this copper.
    [het68-core-B_Cu.gbl, het68-core-B_Mask.gbs, het68-core-B_Paste.gbp, het68-core-B_Silkscreen.gbo, het68-core-Edge_Cuts.gm1, het68-core-F_Cu.gtl, het68-core-F_Mask.gts, het68-core-F_Paste.gtp]
2026-10-29 Route the core with 0.15 mm vias and one 3.3 V plane.
    JLCPCB drills 0.15 mm on 6 layers. A 0.30 mm via fits the 0.40 mm QFN pitch, and L4 under the RP2350 is now a single +3V3_DIG pour so those vias meet the plane. DRC reports no shorts and no clearance errors. Seventeen pairs stay open where the via ring leaves no 0.15 mm exit.
    [het68-core-B_Cu.gbl, het68-core-B_Mask.gbs, het68-core-B_Paste.gbp, het68-core-B_Silkscreen.gbo, het68-core-Edge_Cuts.gm1, het68-core-F_Cu.gtl, het68-core-F_Mask.gts, het68-core-F_Paste.gtp]
2026-10-30 Select the satellite link mode with a shunt on the board.
    The cable has no spare wire, so each of SCK, WS and SD uses a 2x3 header. One horizontal shunt picks the row: north is LVDS, middle is 3.3 V through the translator, south is 1.8 V on the T5848. The microphone supply stays 1.8 V and the RJ45 shield is grounded.
    DRC reports no shorts. Airwires remain on OE, a short SD_3V3 gap at U5, WS_LVDS, WS_P, WS_T and WS_N.
    [PINOUT_SAT_v4.csv, bom.csv, het68-sat-bom.csv, het68-sat.kicad_pcb, het68-sat.kicad_sch]
2026-10-31 Mark the shunt-selectable satellite as v4.8.0.
    The changelog records the on-board mode headers and the airwires that DRC still reports.
2026-10-31 Stand the RJ45 plugs upright and show the mode shunt.
    The core and satellite jacks are a vertical 8P8C. The plug axis leaves
    the board face instead of running off the edge. The docs and the v480
    renders include the satellite mode headers. DRC has no shorts. Some
    jack pins, and the tracks the new pad grid cut, are still open.
    [BOM_KIT.csv, BOM_v4.csv, PINOUT_SAT_v4.csv, bom.csv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]
